gwangzeejay/NovaSight/output/diagrams/NovaSight_Studio_Preview.jpg

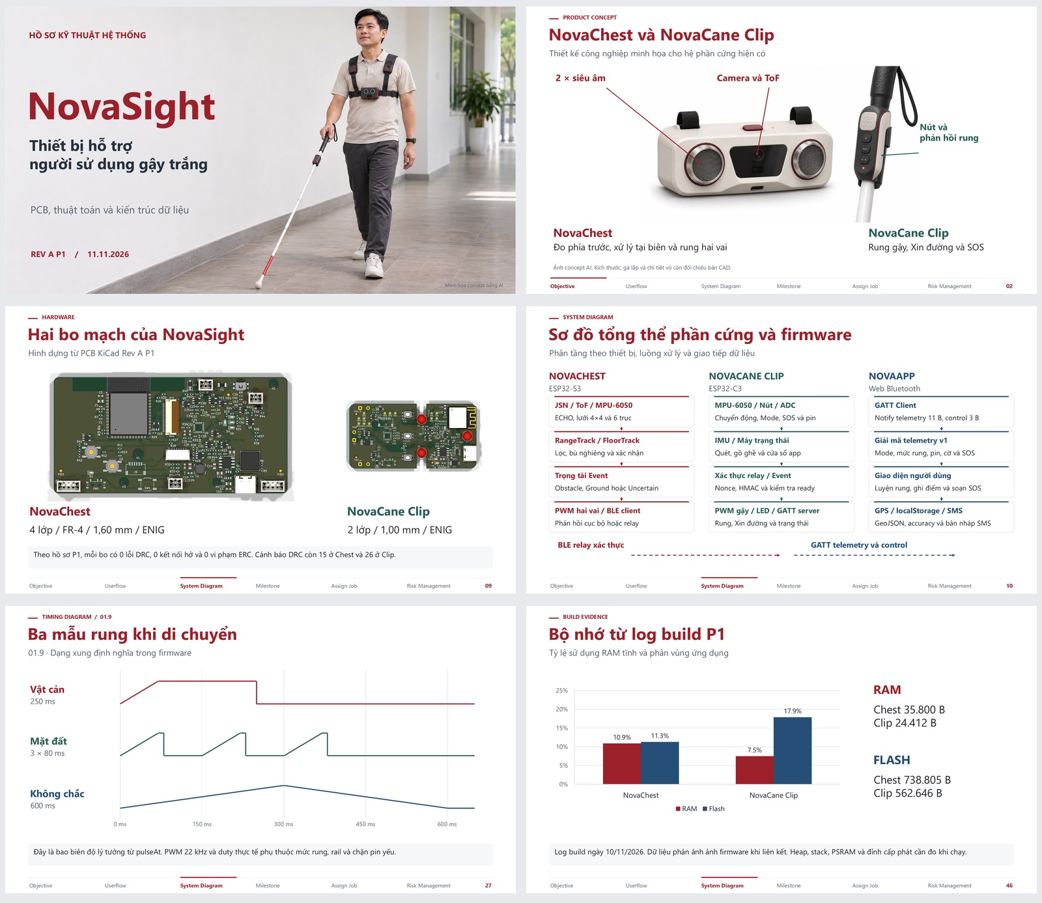
output/diagrams/NovaSight_Studio_Preview.jpg
