gwangzeejay/NovaSight/output/pdf/NovaSight_Technology_Engineering_RevA_P1_Studio.pdf

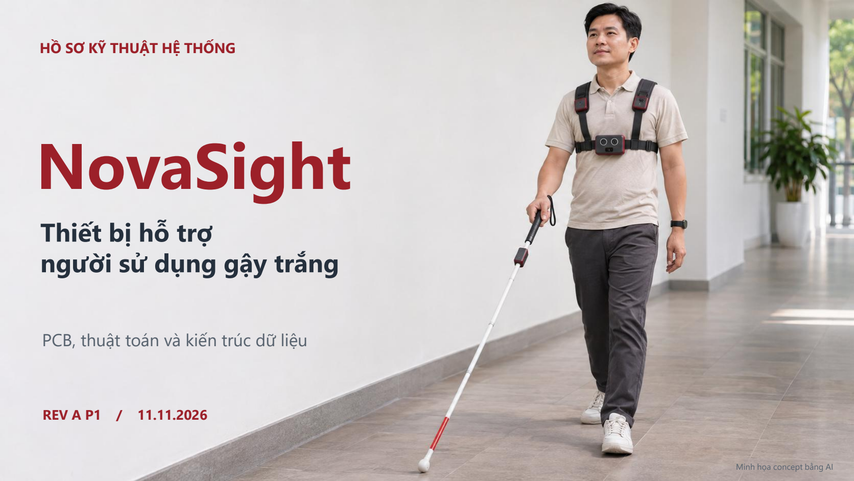
[picture p65: page 1]

HỒ SƠ KỸ THUẬT HỆ THỐNG

# NovaSight

# Thiết bị hỗ trợ

# người sử dụng gậy trắng

### PCB, thuật toán và kiến trúc dữ liệu

REV A P1 / 11.11.2026

Minh họa concept bằng AI

PRODUCT CONCEPT

# NovaChest và NovaCane Clip

Thiết kế công nghiệp minh họa cho hệ phần cứng hiện có

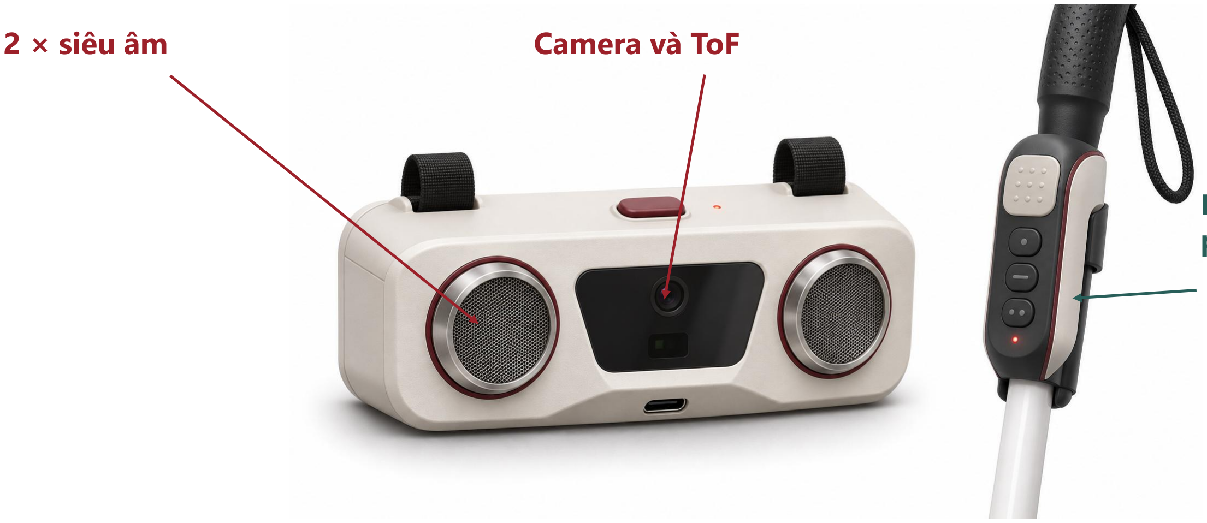
[picture p66: figure]
2 × siêu âm; Camera và ToF

Objective | Userflow | System Diagram | Milestone | Assign Job | Risk Management | 02

Nút và
phản hồi rung

## NovaChest

Đo phía trước, xử lý tại biên và rung hai vai

## NovaCane Clip

Rung gậy, Xin đường và SOS

Ảnh concept AI. Kích thước, gá lắp và chi tiết vỏ cần đối chiếu bản CAD.

DESIGN RATIONALE

# Nhu cầu và quyết định thiết kế

Dấu vết từ khảo sát người dùng đến yêu cầu kỹ thuật

Objective | Userflow | System Diagram | Milestone | Assign Job | Risk Management | 03
N1 | Vật cản ở ngực và đầu

### Hai kênh siêu âm trên Chest phân biệt

trái, phải và giữa.

## N4 Mặt đường khó dự đoán

ToF đa vùng so với nền đã hiệu chuẩn, kết hợp tư thế IMU.

N5 / N6 | Rung nhẹ và giữ tai rảnh
| Ba mức rung, khởi động mềm và phản hồi hai vai hoặc trên gậy.

## N13 / N14 Tiếp tục sử dụng gậy quen thuộc

### Clip gắn dưới tay cầm. NovaApp hỗ trợ

cấu hình và tiện ích.

P1 là nguyên mẫu kỹ thuật có giám sát. Hiệu năng phát hiện và trải nghiệm rung cần được đo với phần cứng thực.

TỔNG QUAN

# Objective

Nguyên mẫu hỗ trợ người sử dụng gậy trắng

Objective | Userflow | System Diagram | Milestone | Assign Job | Risk Management | 04

### 01 Nhận biết vật cản thân trên

NovaChest phát siêu âm hai hướng và chọn vật cản trái, phải hoặc giữa.

### 02 Nhận biết thay đổi mặt đất

ToF 4×4 và IMU giúp so độ cao so với nền đã hiệu chuẩn. Tín hiệu yếu có mẫu rung riêng.

### 03 Phản hồi qua hai thiết bị

Chest có rung vai. Clip nhận cảnh báo đã xác thực khi đang quét và đủ điều kiện.

### 04 Tiện ích NovaApp

Cấu hình, luyện rung, tiếp nhận SOS và lưu điểm gồ ghề khi người dùng thao tác.

P1 dùng cho nguyên mẫu kỹ thuật có giám sát. Mục tiêu độ trễ và khả năng phát hiện cần đo trên mẫu.

OBJECTIVE

# Phạm vi chức năng Rev A P1

Phân biệt đường chạy hiện hành và hạng mục kiểm chứng

Objective | Userflow | System Diagram | Milestone | Assign Job | Risk Management | 05
Khối | Đường xử lý có trong P1 | Điều kiện hoặc mốc còn mở
NovaChest | Siêu âm, ToF + IMU, trọng tài sự kiện, rung vai | ToF cần bật và hiệu chuẩn. Đo ngoài nắng, bỏ sót và báo nhầm.
NovaCane Clip | IMU, quét và gồ ghề, motor, đèn Xin đường, SOS | Xác nhận cường độ rung, rail tải và dùng nút khi đeo.
Liên kết Chest–Clip | BLE GATT và relay có nonce + HMAC | Cần cặp đã cấu hình. Đo mất kết nối và thời gian chờ ACK.
NovaApp | BLE, luyện rung, GPS theo yêu cầu, mở SMS và GeoJSON | Cần trình duyệt tương thích. Người dùng xác nhận gửi SMS.
OV5640 | Task chẩn đoán thu JPEG QVGA | Đo điện và xác minh FPC. Ghép ảnh vào thuật toán là hướng phát triển.

HÀNH TRÌNH SỬ DỤNG

# Userflow

Các thao tác chính khi chuẩn bị, di chuyển và cần hỗ trợ

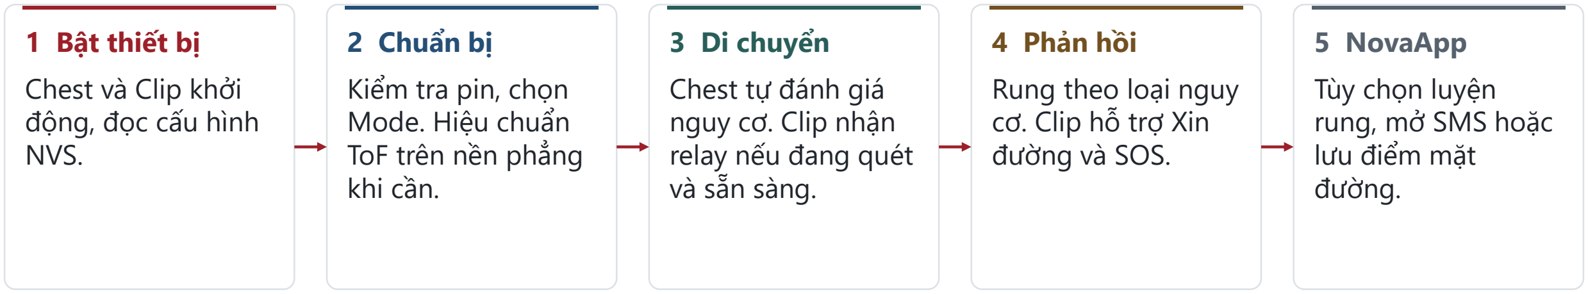
[picture p67: figure]
1 Bật thiết bị; Chest và Clip khởi động, đọc cấu hình NVS.; 2 Chuẩn bị; Kiểm tra pin, chọn Mode. Hiệu chuẩn ToF trên nền phẳng khi cần.; 3 Di chuyển; Chest tự đánh giá nguy cơ. Clip nhận relay nếu đang quét và sẵn sàng.; 4 Phản hồi; Rung theo loại nguy cơ. Clip hỗ trợ Xin đường và SOS.; 5 NovaApp; Tùy chọn luyện rung, mở SMS hoặc lưu điểm mặt đường.
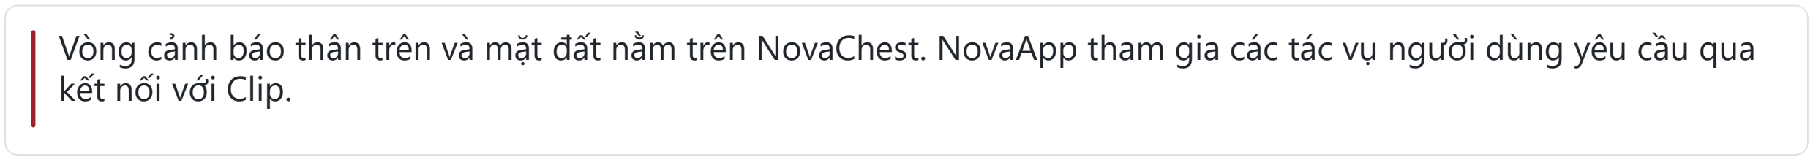
[picture p68: figure]
kết nối với Clip.

Objective | Userflow | System Diagram | Milestone | Assign Job | Risk Management | 06

Vòng cảnh báo thân trên và mặt đất nằm trên NovaChest. NovaApp tham gia các tác vụ người dùng yêu cầu qua

NOVASIGHT
01

# ARCHITECTURE

## System Diagram từ ngữ cảnh đến gói dữ liệu

NovaChest · NovaCane Clip · NovaApp

Objective | Userflow | System Diagram | Milestone | Assign Job | Risk Management | 07

SYSTEM DIAGRAM

# Thành phần hệ thống

Các thiết bị và giao diện trong phiên bản Rev A P1

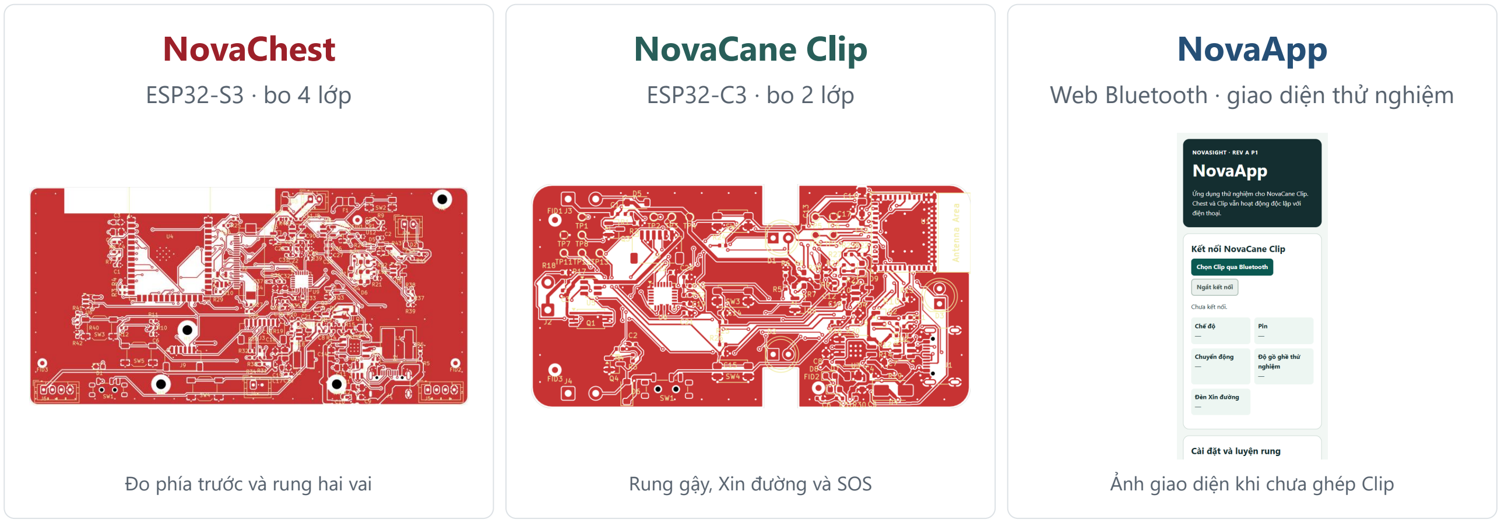
[picture p69: figure]
NovaChest; ESP32-S3 · bo 4 lớp; Đo phía trước và rung hai vai; NovaCane Clip; ESP32-C3 · bo 2 lớp; Rung gậy, Xin đường và SOS; NovaApp; Web Bluetooth · giao diện thử nghiệm; Ảnh giao diện khi chưa ghép Clip

Objective | Userflow | System Diagram | Milestone | Assign Job | Risk Management | 08

HARDWARE

# Hai bo mạch của NovaSight

Hình dựng từ PCB KiCad Rev A P1

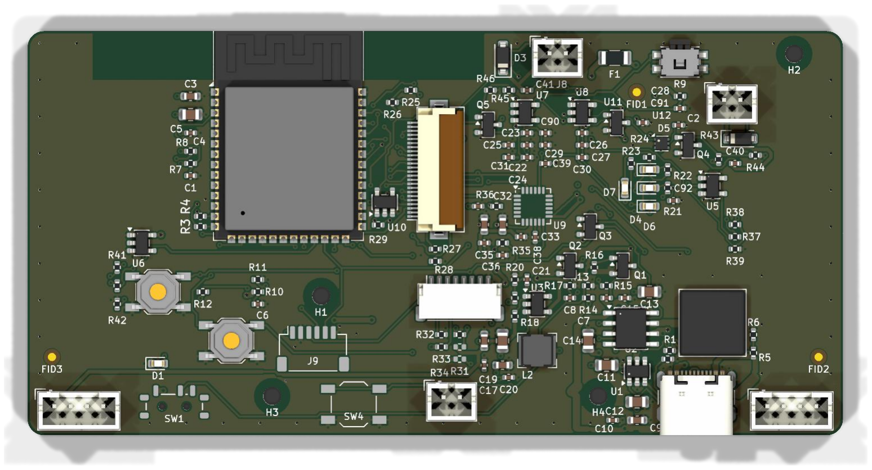
[picture p70: figure]
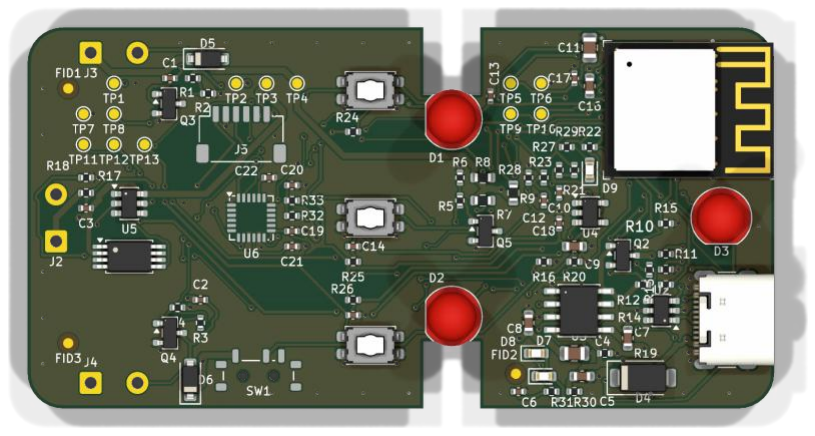
[picture p71: figure]

Objective | Userflow | System Diagram | Milestone | Assign Job | Risk Management | 09

## NovaChest

### 4 lớp / FR-4 / 1,60 mm / ENIG

## NovaCane Clip

### 2 lớp / 1,00 mm / ENIG

Theo hồ sơ P1, mỗi bo có 0 lỗi DRC, 0 kết nối hở và 0 vi phạm ERC. Cảnh báo DRC còn 15 ở Chest và 26 ở Clip.

# Sơ đồ tổng thể phần cứng và firmware

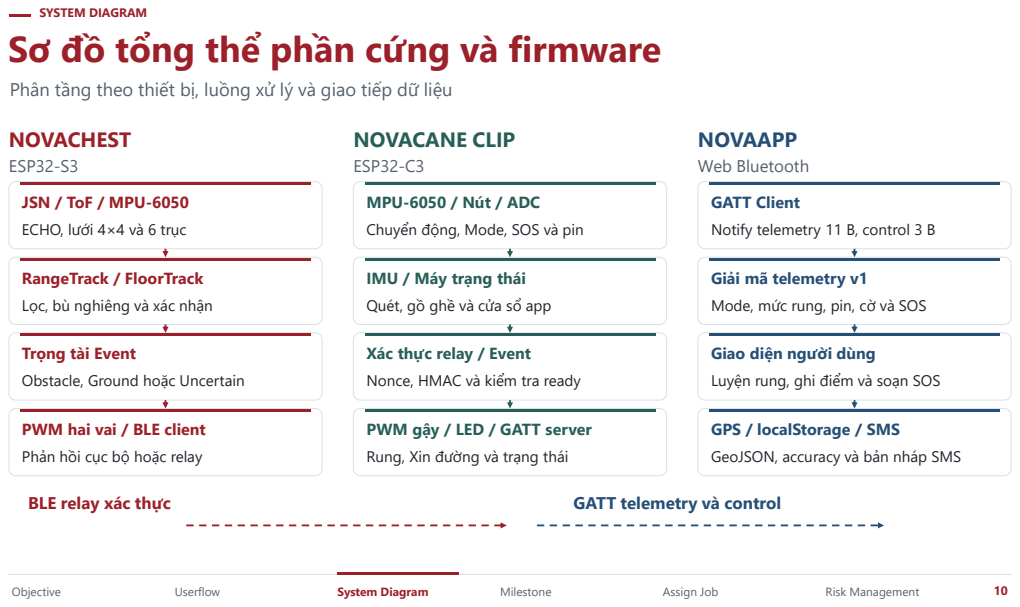
[picture p72: page 10]
SYSTEM DIAGRAM; Objective; Userflow; System Diagram; Milestone; Assign Job; Risk Management; NOVACHEST; ESP32-S3; NOVACANE CLIP; ESP32-C3; NOVAAPP; Web Bluetooth; GATT Client; BLE relay xác thực; GATT telemetry và control

Phân tầng theo thiết bị, luồng xử lý và giao tiếp dữ liệu

JSN / ToF / MPU-6050
ECHO, lưới 4×4 và 6 trục

MPU-6050 / Nút / ADC
Chuyển động, Mode, SOS và pin

Notify telemetry 11 B, control 3 B

RangeTrack / FloorTrack
Lọc, bù nghiêng và xác nhận

IMU / Máy trạng thái
Quét, gồ ghề và cửa sổ app

Giải mã telemetry v1

Mode, mức rung, pin, cờ và SOS

Trọng tài Event

Xác thực relay / Event
Nonce, HMAC và kiểm tra ready

Giao diện người dùng
Luyện rung, ghi điểm và soạn SOS

Obstacle, Ground hoặc Uncertain

PWM hai vai / BLE client
Phản hồi cục bộ hoặc relay

PWM gậy / LED / GATT server

GPS / localStorage / SMS
GeoJSON, accuracy và bản nháp SMS

Rung, Xin đường và trạng thái

POWER ARCHITECTURE

# Kiến trúc nguồn NovaChest

Đường công suất và tín hiệu điều khiển được phân biệt rõ

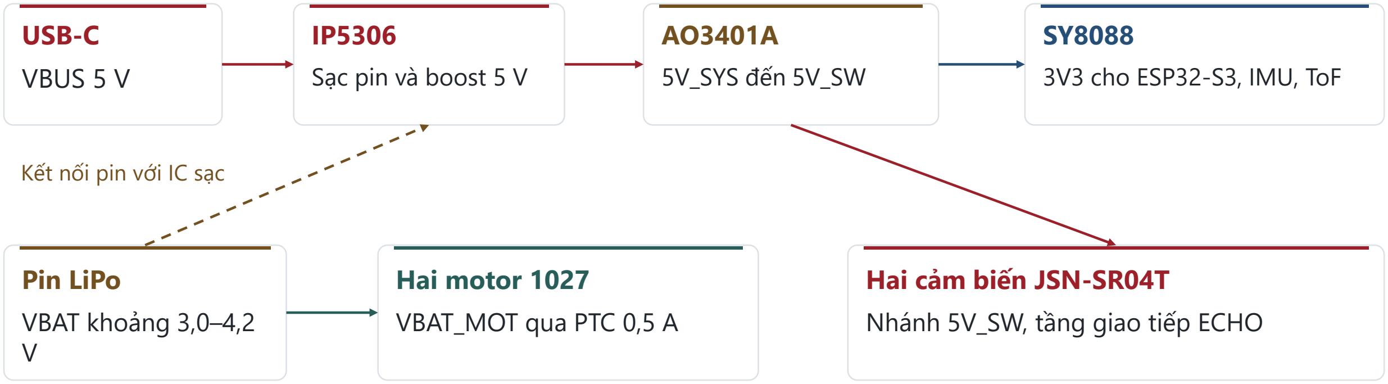
[picture p73: figure]
USB-C; VBUS 5 V; Sạc pin và boost 5 V; 5V_SYS đến 5V_SW; 3V3 cho ESP32-S3, IMU, ToF; Pin LiPo; VBAT khoảng 3,0–4,2 V; Hai motor 1027; VBAT_MOT qua PTC 0,5 A; Hai cảm biến JSN-SR04T; Nhánh 5V_SW, tầng giao tiếp ECHO; Kết nối pin với IC sạc

Objective | Userflow | System Diagram | Milestone | Assign Job | Risk Management | 11

Công tắc gạt điều khiển PWR_EN và KEY. Motor lấy nguồn từ VBAT. Đo rail, dòng đỉnh và nhiệt trước khi gắn đầy đủ tải.

POWER ARCHITECTURE

# Kiến trúc nguồn NovaCane Clip

Nạp qua USB, bảo vệ pin và chia tải VSYS

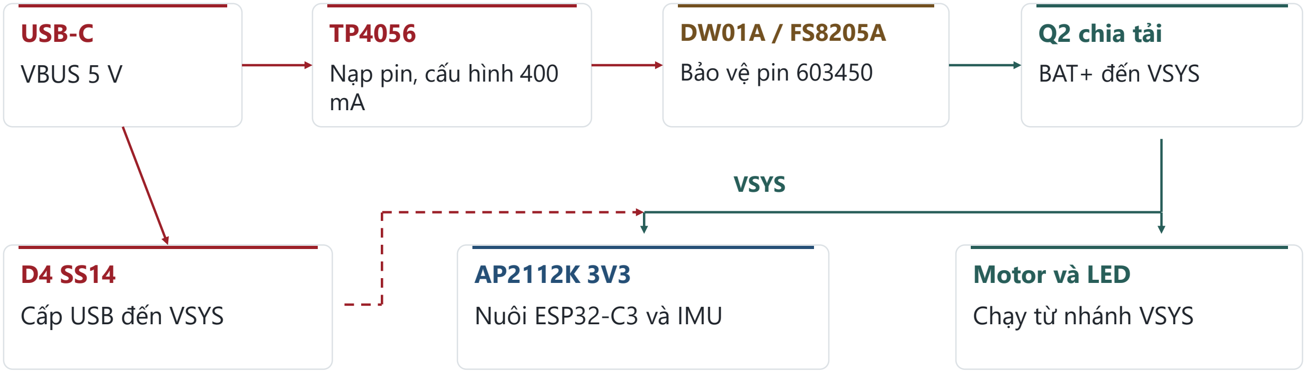
[picture p74: figure]
USB-C; VBUS 5 V; Nạp pin, cấu hình 400 mA; Bảo vệ pin 603450; Q2 chia tải; BAT+ đến VSYS; Cấp USB đến VSYS; Nuôi ESP32-C3 và IMU; Motor và LED; Chạy từ nhánh VSYS; VSYS

Objective | Userflow | System Diagram | Milestone | Assign Job | Risk Management | 12

SW1 điều khiển chân EN của LDO. Rung bị khóa dưới 3,50 V và mở lại từ 3,65 V theo ADC trong firmware.

SYSTEM DIAGRAM / L0

# System Diagram

L0 · Ngữ cảnh, tác nhân và ranh giới hệ thống

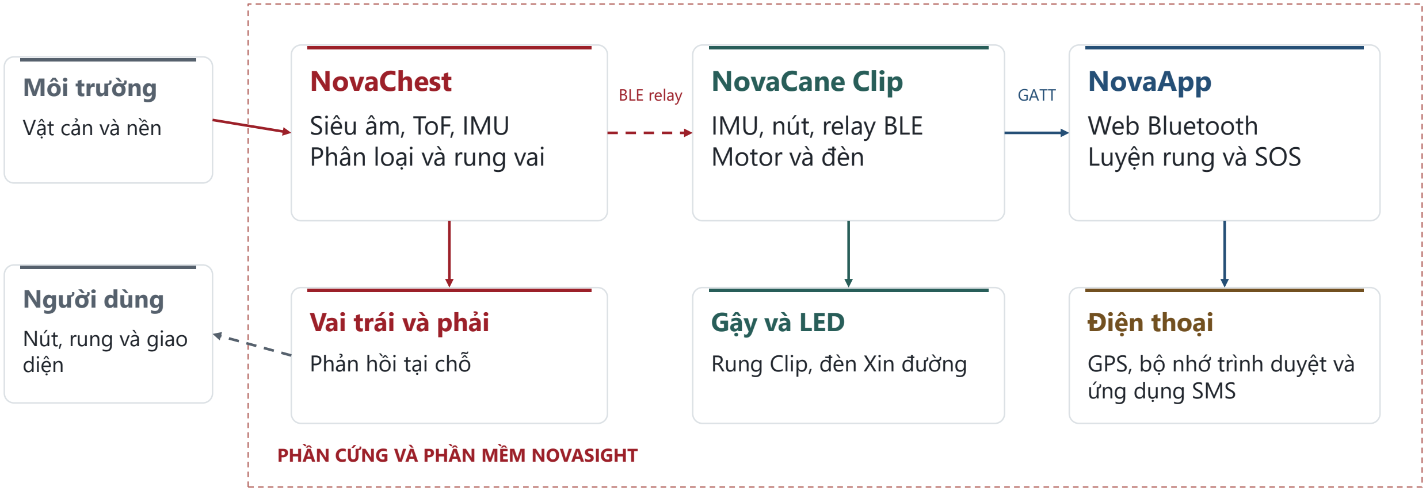
[picture p75: figure]
Môi trường; Vật cản và nền; Người dùng; Nút, rung và giao diện; NovaChest; Siêu âm, ToF, IMU Phân loại và rung vai; NovaCane Clip; IMU, nút, relay BLE Motor và đèn; NovaApp; Web Bluetooth Luyện rung và SOS; Điện thoại; GPS, bộ nhớ trình duyệt và ứng dụng SMS; Vai trái và phải; Phản hồi tại chỗ; Gậy và LED; Rung Clip, đèn Xin đường; BLE relay; GATT; PHẦN CỨNG VÀ PHẦN MỀM NOVASIGHT

Objective | Userflow | System Diagram | Milestone | Assign Job | Risk Management | 13

Đường an toàn tại chỗ chạy trên thiết bị. GPS, lưu điểm và soạn SMS là các tác vụ tùy chọn trên điện thoại.

SYSTEM DIAGRAM / L0–L4

# Phân cấp dữ liệu NovaSight

L0–L4 · Từ ngữ cảnh đến byte, đối tượng và nơi lưu

Objective | Userflow | System Diagram | Milestone | Assign Job | Risk Management | 14
L0 Ngữ cảnh | Môi trường, người sử dụng, Chest, Clip và điện thoại.
L1 Miền và giao tiếp | Cảm biến I²C, TRIG/ECHO, PWM, BLE GATT và API vị trí.
L2 Luồng xử lý | Thu nhận, lọc, trích đặc trưng, phân loại và phản hồi.
L3 Đối tượng dữ liệu | Motion, RangeSample, FloorFrame, FloorCalibration, Event và
Pulse.

L4 Tuần tự hóa và lưu Challenge 18 B, relay 16 B, ACK 12 B, telemetry 11 B, control 3 B và GeoJSON.

SYSTEM DIAGRAM / L1

# Phân vùng xử lý và nhịp dữ liệu

L1 · Các task và nhịp xử lý cấu hình trong P1

Objective | Userflow | System Diagram | Milestone | Assign Job | Risk Management | 15
Tác vụ | NovaChest ESP32-S3 | NovaCane Clip ESP32-C3 / NovaApp
Vòng chính | pollUltrasound, nhận FloorFrame, trọng tài và PWM. delay(2 ms). | Đọc nút, xử lý relay/control, PWM và cập nhật cờ. delay(2 ms).
Thu nhận | TRIG xen kẽ 50 ms. IMU theo lịch 10 ms. ToF 4×4 cấu hình 20 Hz. | IMU theo lịch 10 ms. ADC pin trên cả hai bo mỗi 250 ms.
Task nền | nova-sensors đẩy queue 1 phần tử. nova-camera và nova-link chạy riêng. | BLE server đẩy hàng đợi 1 Event và 3 AppCommand.
Ứng dụng | Chest không gửi ảnh hay lưới ToF sang NovaApp. | Telemetry notify mỗi 500 ms hoặc khi dirty. GPS theo yêu cầu.

Nhịp danh định từ code. Thời gian I/O, radio và lập lịch làm thay đổi nhịp đo thực tế.

TIMING DIAGRAM / L1–L2

# Dòng thời gian thu nhận và xác nhận

L1–L2 · Minh họa nhịp danh định trong cửa sổ 250 ms

Objective | Userflow | System Diagram | Milestone | Assign Job | Risk Management | 16
| 0 ms | 50 ms | 100 ms | 150 ms | 200 ms | 250 ms
TRIG trái | L | | L | | L
TRIG phải | | R | | R | | R
ToF 4×4 | F | F | F | F | F | F
Mẫu trái nhất quán | 1 | | 2 | | 3
Khung ToF nhất quán | 1 | 2 | 3

Điểm 3 đánh dấu đủ số mẫu/khung. IMU cập nhật theo lịch 10 ms và cung cấp Motion mới nhất cho khung ToF.

Mốc minh họa giả định các chuỗi bắt đầu cùng lúc. Độ trễ thực còn gồm thời điểm mục tiêu xuất hiện, ECHO, xử lý và đầu ra.

NOVASIGHT
02

# EDGE PROCESSING

## NovaChest nhận biết nguy cơ và điều khiển phản hồi

01 · Thu nhận / DSP / Quyết định / Rung

Objective | Userflow | System Diagram | Milestone | Assign Job | Risk Management | 17

SYSTEM DIAGRAM / 01

# System Diagram

01 · NovaChest và các nhánh xử lý tại biên

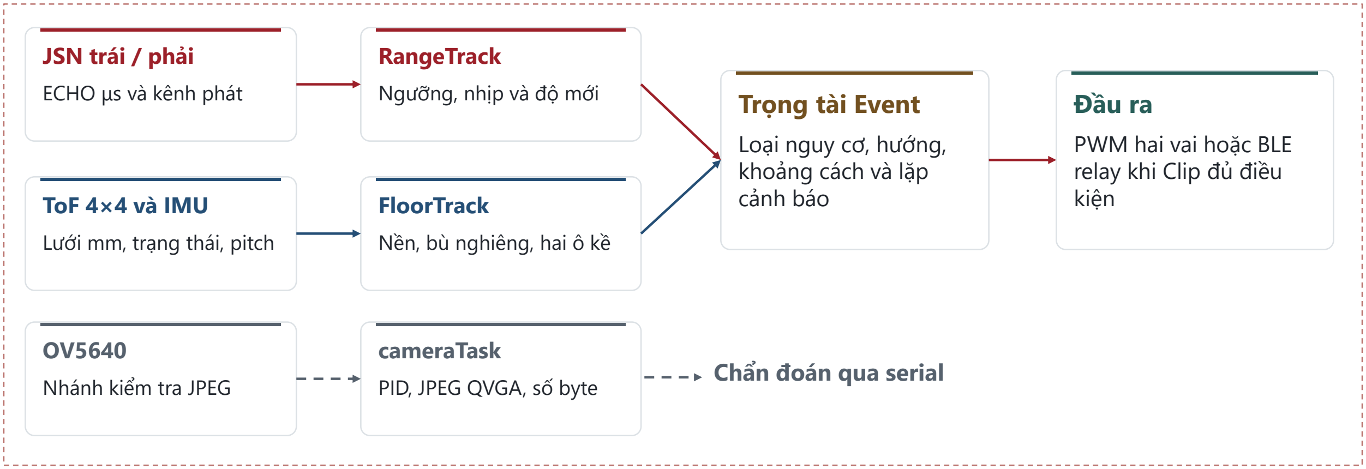
[picture p76: figure]
JSN trái / phải; ECHO μs và kênh phát; ToF 4×4 và IMU; Lưới mm, trạng thái, pitch; Nhánh kiểm tra JPEG; RangeTrack; Ngưỡng, nhịp và độ mới; FloorTrack; Nền, bù nghiêng, hai ô kề; cameraTask; PID, JPEG QVGA, số byte; Trọng tài Event; Loại nguy cơ, hướng, khoảng cách và lặp cảnh báo; Đầu ra; PWM hai vai hoặc BLE relay khi Clip đủ điều kiện; Chẩn đoán qua serial

Objective | Userflow | System Diagram | Milestone | Assign Job | Risk Management | 18

Camera đo tình trạng thu ảnh riêng. Đường cảnh báo dùng siêu âm, ToF và thông tin tư thế từ IMU.

ALGORITHM / 01.1

# Siêu âm và thuật toán vật cản

01.1 · Thu ECHO, kiểm tra nhất quán rồi phát hiện thân trên

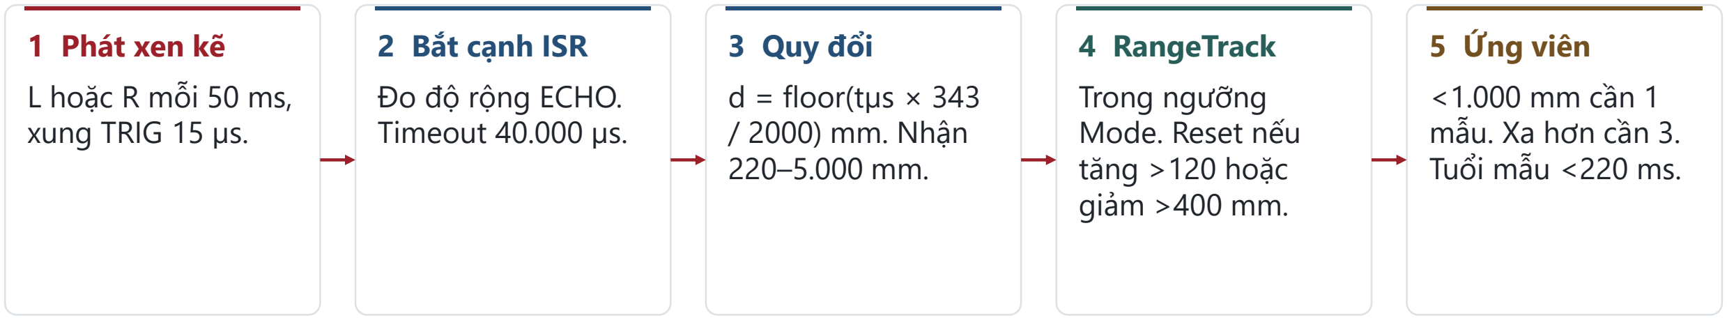
[picture p77: figure]
1 Phát xen kẽ; L hoặc R mỗi 50 ms, xung TRIG 15 µs.; 2 Bắt cạnh ISR; Đo độ rộng ECHO. Timeout 40.000 µs.; 3 Quy đổi; d = floor(tµs × 343 / 2000) mm. Nhận 220–5.000 mm.; 4 RangeTrack; Trong ngưỡng Mode. Reset nếu tăng >120 hoặc giảm >400 mm.; 5 Ứng viên; <1.000 mm cần 1 mẫu. Xa hơn cần 3. Tuổi mẫu <220 ms.
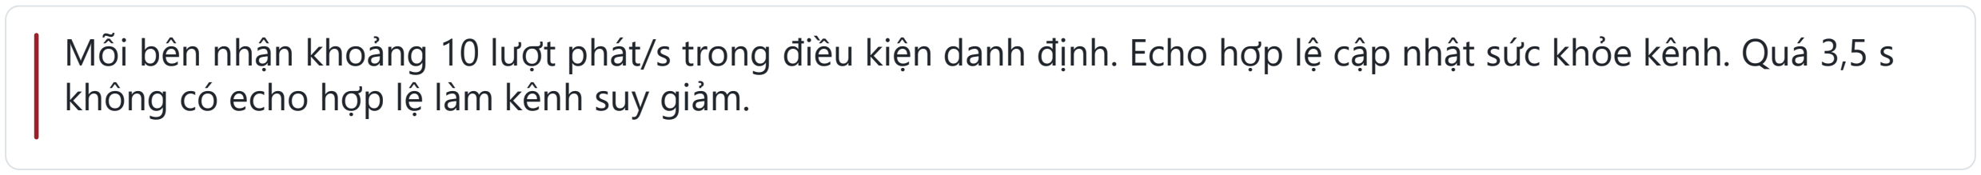
[picture p78: figure]
không có echo hợp lệ làm kênh suy giảm.

Objective | Userflow | System Diagram | Milestone | Assign Job | Risk Management | 19

Mỗi bên nhận khoảng 10 lượt phát/s trong điều kiện danh định. Echo hợp lệ cập nhật sức khỏe kênh. Quá 3,5 s

DSP / 01.2

# IMU và trích xuất đặc trưng

01.2 · Từ 14 byte MPU-6050 đến tư thế và vận tốc ước lượng

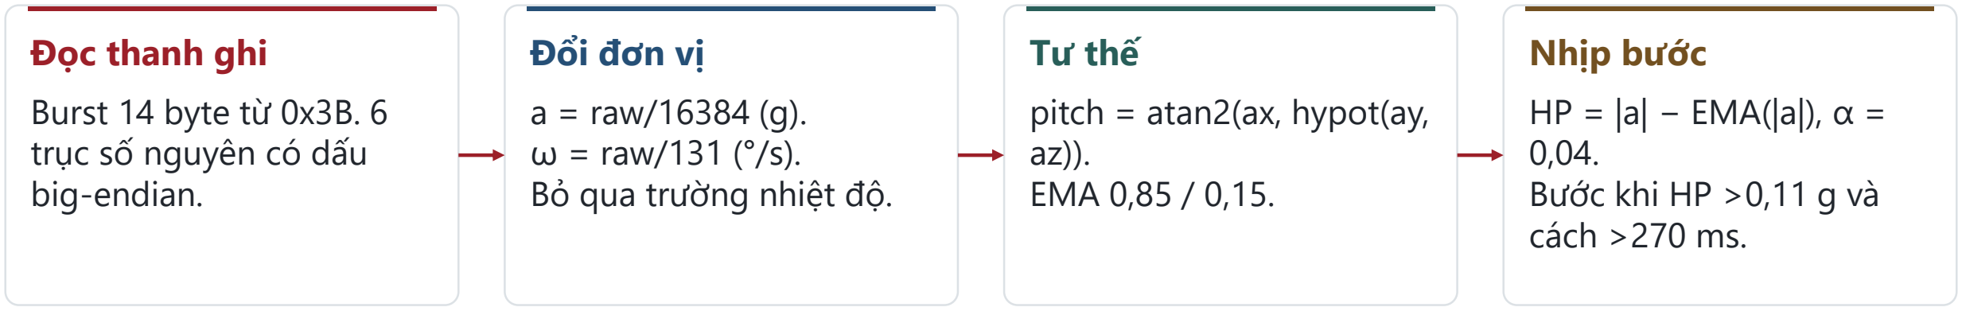
[picture p79: figure]
Đọc thanh ghi; Burst 14 byte từ 0x3B. 6 trục số nguyên có dấu big-endian.; Đổi đơn vị; a = raw/16384 (g). ω = raw/131 (°/s). Bỏ qua trường nhiệt độ.; Tư thế; pitch = atan2(ax, hypot(ay, az)). EMA 0,85 / 0,15.; Nhịp bước; HP = |a| − EMA(|a|), α = 0,04. Bước khi HP >0,11 g và cách >270 ms.

Objective | Userflow | System Diagram | Milestone | Assign Job | Risk Management | 20

Cổng tin cậy tư thế

0,78 < |a| < 1,22 g và |ω| < 140 °/s. Pitch chỉ cập nhật ở mẫu qua cổng.

Tốc độ dùng cho ngưỡng

Cadence EMA 0,7 / 0,3. v = min(2,2; 0,65 × cadence) m/s khi bước còn mới (<1,45 s).

Pitch lấy từ gia tốc trọng trường. Gyro giúp loại tư thế thiếu ổn định. Tốc độ là ước lượng từ nhịp bước.

DSP / 01.3

# ToF Input Processing

01.3 · Đồng bộ lưới độ sâu với tư thế mới nhất

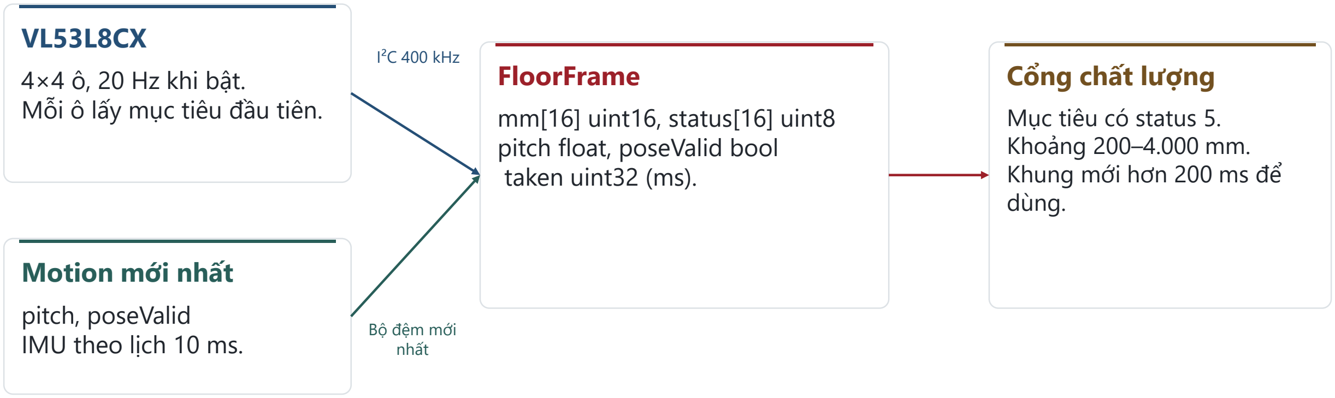
[picture p80: figure]
4×4 ô, 20 Hz khi bật. Mỗi ô lấy mục tiêu đầu tiên.; Motion mới nhất; pitch, poseValid IMU theo lịch 10 ms.; FloorFrame; mm[16] uint16, status[16] uint8 pitch float, poseValid bool taken uint32 (ms).; Cổng chất lượng; Mục tiêu có status 5. Khoảng 200–4.000 mm. Khung mới hơn 200 ms để dùng.; I²C 400 kHz; Bộ đệm mới nhất

Objective | Userflow | System Diagram | Milestone | Assign Job | Risk Management | 21

Nếu ô không có mục tiêu, status = 255. Mất khung ≥1 s thì task dừng ranging và thử lại theo chu kỳ 5 s.

ALGORITHM / 01.4

# Hiệu chuẩn nền phẳng

01.4 · Tạo nền theo từng ô ToF và lưu cấu hình có phiên bản

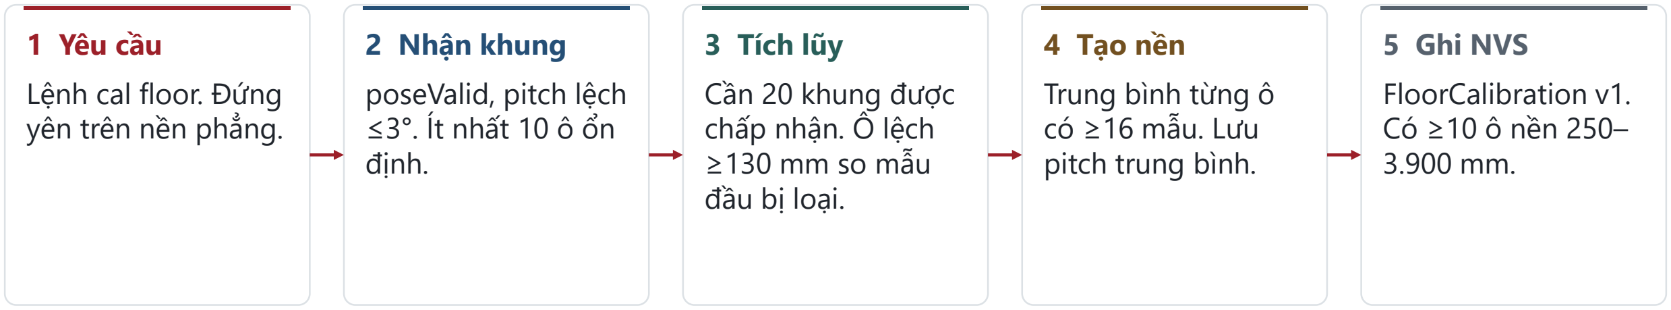
[picture p81: figure]
1 Yêu cầu; Lệnh cal floor. Đứng yên trên nền phẳng.; 2 Nhận khung; poseValid, pitch lệch ≤3°. Ít nhất 10 ô ổn định.; 3 Tích lũy; Cần 20 khung được chấp nhận. Ô lệch ≥130 mm so mẫu đầu bị loại.; 4 Tạo nền; Trung bình từng ô có ≥16 mẫu. Lưu pitch trung bình.; 5 Ghi NVS; FloorCalibration v1. Có ≥10 ô nền 250– 3.900 mm.
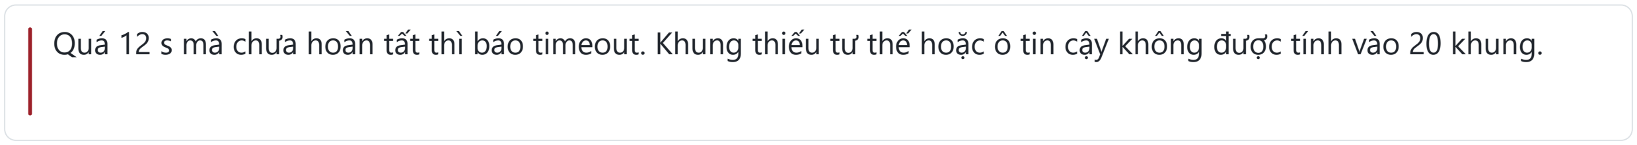
[picture p82: figure]

Objective | Userflow | System Diagram | Milestone | Assign Job | Risk Management | 22

Quá 12 s mà chưa hoàn tất thì báo timeout. Khung thiếu tư thế hoặc ô tin cậy không được tính vào 20 khung.

ALGORITHM / 01.5

# Bù nghiêng và độ lệch mặt đất

01.5 · Phép chiếu theo hàng ToF cho mỗi ô đã qua lọc

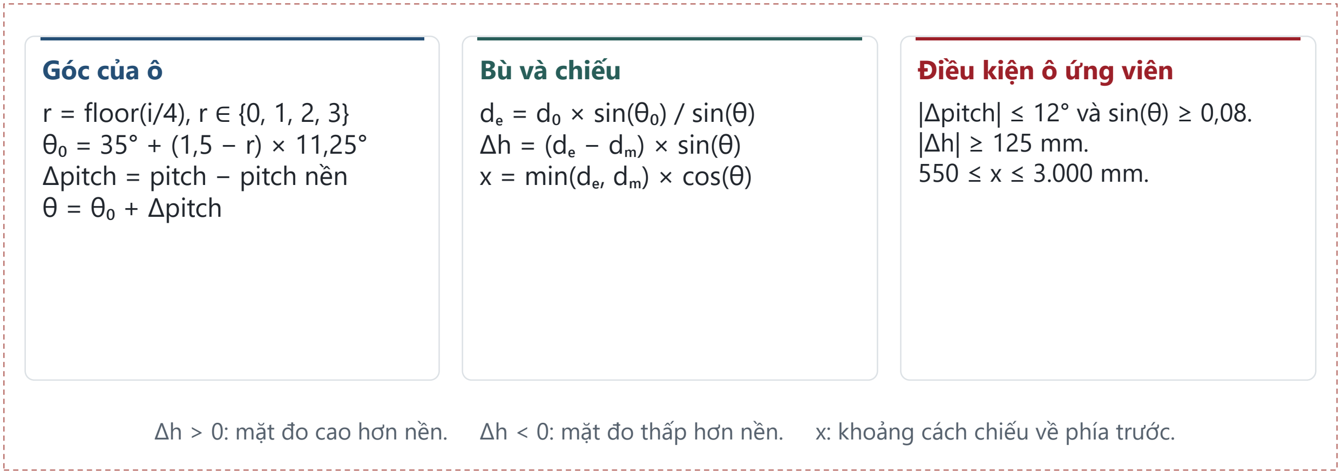
[picture p83: figure]
Góc của ô; r = floor(i/4), r ∈ {0, 1, 2, 3} θ₀ = 35° + (1,5 − r) × 11,25° Δpitch = pitch − pitch nền θ = θ₀ + Δpitch; Bù và chiếu; dₑ = d₀ × sin(θ₀) / sin(θ) Δh = (dₑ − dₘ) × sin(θ) x = min(dₑ, dₘ) × cos(θ); Điều kiện ô ứng viên; |Δpitch| ≤ 12° và sin(θ) ≥ 0,08. |Δh| ≥ 125 mm. 550 ≤ x ≤ 3.000 mm.

Objective | Userflow | System Diagram | Milestone | Assign Job | Risk Management | 23
Δh > 0: mặt đo cao hơn nền. | Δh < 0: mặt đo thấp hơn nền. | x: khoảng cách chiếu về phía trước.

Khi hụt, dùng min(dₑ, dₘ) để ước lượng vị trí mép nền thay vì chọn điểm phản xạ sâu.

ALGORITHM / 01.6

# Lưới ToF và cửa sổ xác nhận

01.6 · Kiểm tra liền kề theo không gian và nhất quán theo thời gian

Objective | Userflow | System Diagram | Milestone | Assign Job | Risk Management | 24
Hàng | 0 | 1 | 2 | 3
0 | · | + | + | ·
1 | · | · | · | ·
2 | · | · | · | −
3 | ? | · | · | ·

Ví dụ minh họa nhãn ô, không phải lưới đo thực tế.

Không gian

Chấp nhận cặp ngang hoặc dọc cùng dấu. Chọn ứng viên gần nhất. Cần ≥6 ô khỏe.

Thời gian

Đếm 3 khung nhất quán. Reset nếu mất >200 ms, đổi dấu, xa thêm >150 mm hoặc gần thêm >450 mm.

Kết quả

reliable biểu thị đủ ô khỏe. hazardMm chỉ khác 0 khi qua cửa sổ xác nhận.

Cặp + ở hàng 0 qua kiểm tra liền kề. Ô − đơn lẻ ở hàng 2 chưa đủ điều kiện ứng viên.

ALGORITHM / 01.7

# Trọng tài nguy cơ và chế độ

01.7 · Từ hai RangeTrack và FloorResult đến một Event

Objective | Userflow | System Diagram | Milestone | Assign Job | Risk Management | 25
Chế độ | Vật cản thân trên | Mặt đất và phản hồi
Đi bộ | Ngưỡng = clamp(1.200v + 300; 1.500; 2.500) mm. Hướng giữa khi hai bên lệch ≤500 mm. | Xét mặt đất khi khung còn mới và đủ tin cậy. Rung theo mức cài.
Đông người | Chỉ ứng viên giữa trong 1.200 mm. Khoảng lặp 1.200 ms. | Bỏ qua kênh mặt đất trong mode này.
Trong nhà | Giới hạn siêu âm 1.000 mm. | Mặt đất chỉ đến 1.000 mm. Mức rung 1 và tạm dừng camera.

Nếu có cả hai ứng viên, ưu tiên mặt đất khi d_mặt đất + 200 mm < d_thân trên. Các trường hợp còn lại chọn thân trên.

ALGORITHM / 01.8

# Trạng thái suy giảm và không chắc

01.8 · Hành vi khi tín hiệu không đủ để kết luận

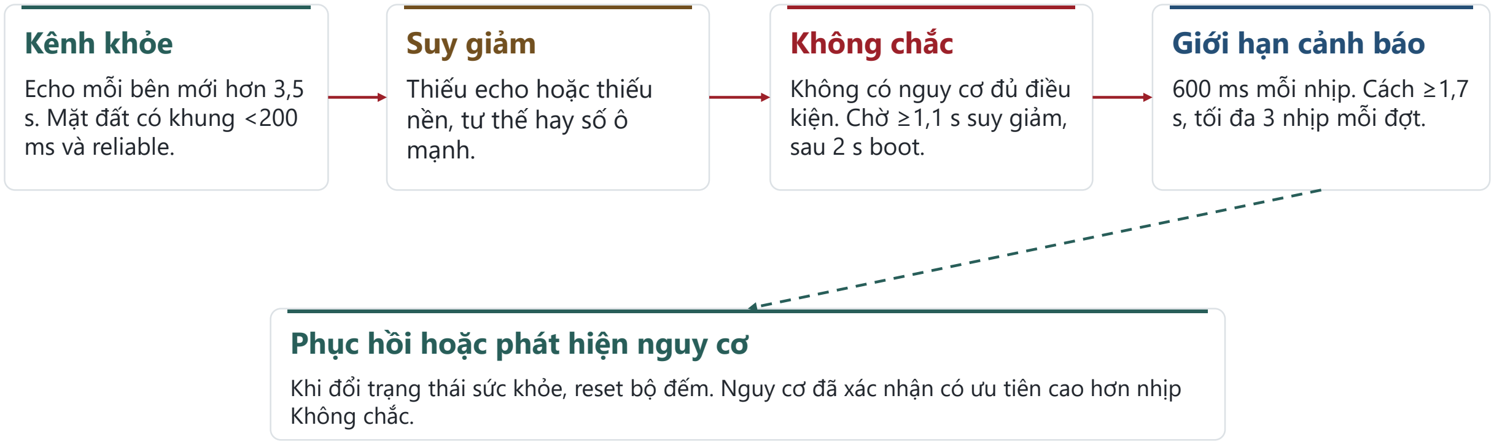
[picture p84: figure]
Kênh khỏe; Echo mỗi bên mới hơn 3,5 s. Mặt đất có khung <200 ms và reliable.; Suy giảm; Thiếu echo hoặc thiếu nền, tư thế hay số ô mạnh.; Không chắc; Không có nguy cơ đủ điều kiện. Chờ ≥1,1 s suy giảm, sau 2 s boot.; Giới hạn cảnh báo; 600 ms mỗi nhịp. Cách ≥1,7 s, tối đa 3 nhịp mỗi đợt.; Phục hồi hoặc phát hiện nguy cơ; Không chắc.

Objective | Userflow | System Diagram | Milestone | Assign Job | Risk Management | 26

Khi đổi trạng thái sức khỏe, reset bộ đếm. Nguy cơ đã xác nhận có ưu tiên cao hơn nhịp

Không có echo kéo dài có thể là vùng trống hoặc lỗi/che đầu dò. P1 chọn báo trạng thái suy giảm.

TIMING DIAGRAM / 01.9

# Ba mẫu rung khi di chuyển

01.9 · Dạng xung định nghĩa trong firmware

Objective | Userflow | System Diagram | Milestone | Assign Job | Risk Management | 27
0 ms | 150 ms | 300 ms | 450 ms | 600 ms

### Vật cản

250 ms

### Mặt đất

3 × 80 ms

### Không chắc

600 ms

Đây là bao biên độ lý tưởng từ pulseAt. PWM 22 kHz và duty thực tế phụ thuộc mức rung, rail và chặn pin yếu.

ALGORITHM / 01.10

# Quản lý pin và duty motor

01.10 · Chặn tải theo điện áp và mức rung của người dùng

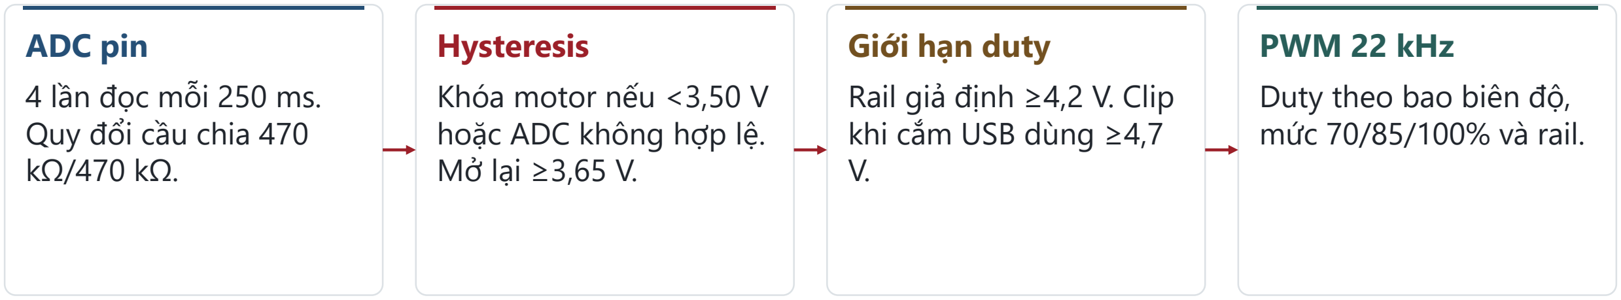
[picture p85: figure]
ADC pin; 4 lần đọc mỗi 250 ms. Quy đổi cầu chia 470 kΩ/470 kΩ.; Hysteresis; Khóa motor nếu <3,50 V hoặc ADC không hợp lệ. Mở lại ≥3,65 V.; Giới hạn duty; Rail giả định ≥4,2 V. Clip khi cắm USB dùng ≥4,7 V.; PWM 22 kHz; Duty theo bao biên độ, mức 70/85/100% và rail.
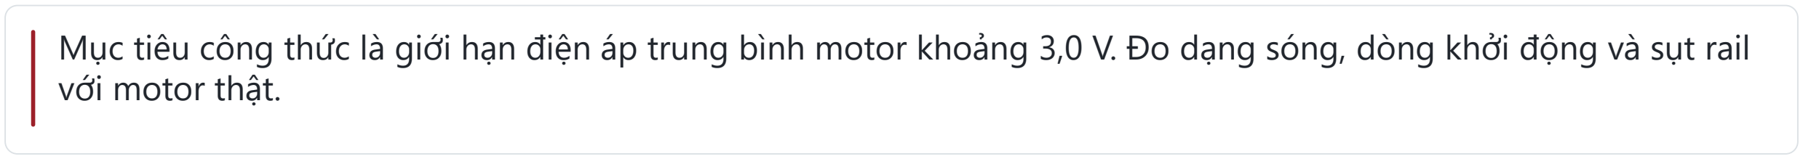
[picture p86: figure]
với motor thật.

Objective | Userflow | System Diagram | Milestone | Assign Job | Risk Management | 28

Mục tiêu công thức là giới hạn điện áp trung bình motor khoảng 3,0 V. Đo dạng sóng, dòng khởi động và sụt rail

SYSTEM DIAGRAM / 01.11

# OV5640 và luồng chẩn đoán

01.11 · Kiểm tra camera tại thiết bị bằng dữ liệu JPEG

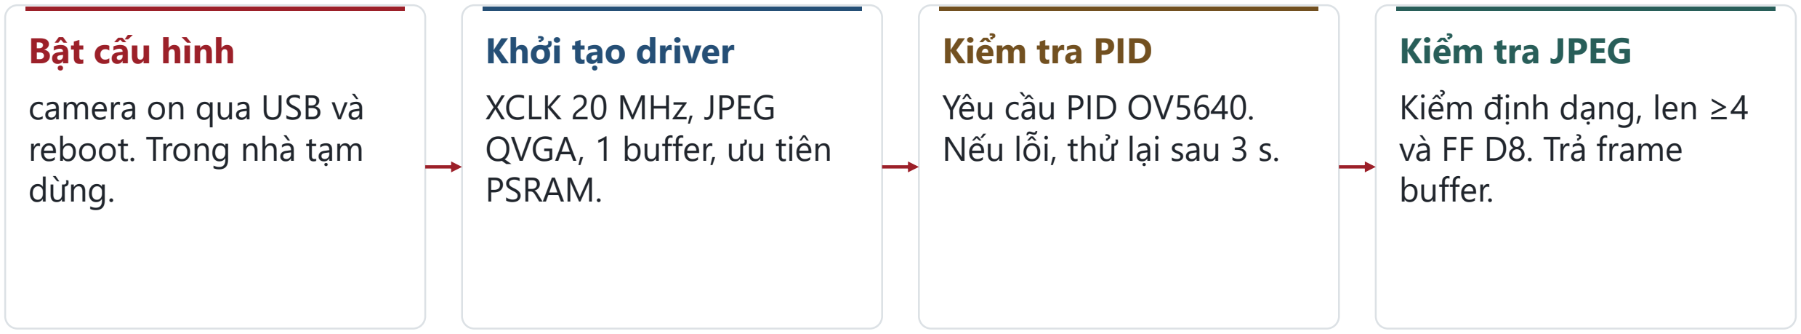
[picture p87: figure]
Bật cấu hình; camera on qua USB và reboot. Trong nhà tạm dừng.; Khởi tạo driver; XCLK 20 MHz, JPEG QVGA, 1 buffer, ưu tiên PSRAM.; Kiểm tra PID; Yêu cầu PID OV5640. Nếu lỗi, thử lại sau 3 s.; Kiểm tra JPEG; Kiểm định dạng, len ≥4 và FF D8. Trả frame buffer.
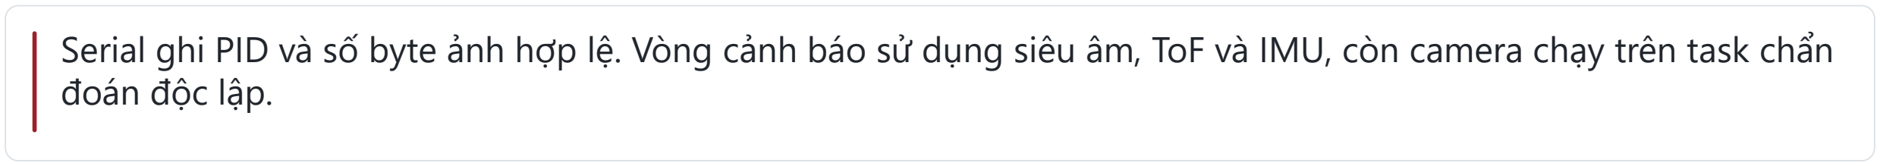
[picture p88: figure]
đoán độc lập.

Objective | Userflow | System Diagram | Milestone | Assign Job | Risk Management | 29

Serial ghi PID và số byte ảnh hợp lệ. Vòng cảnh báo sử dụng siêu âm, ToF và IMU, còn camera chạy trên task chẩn

SYSTEM DIAGRAM / 02

# System Diagram

02 · NovaCane Clip và các đường vào ra

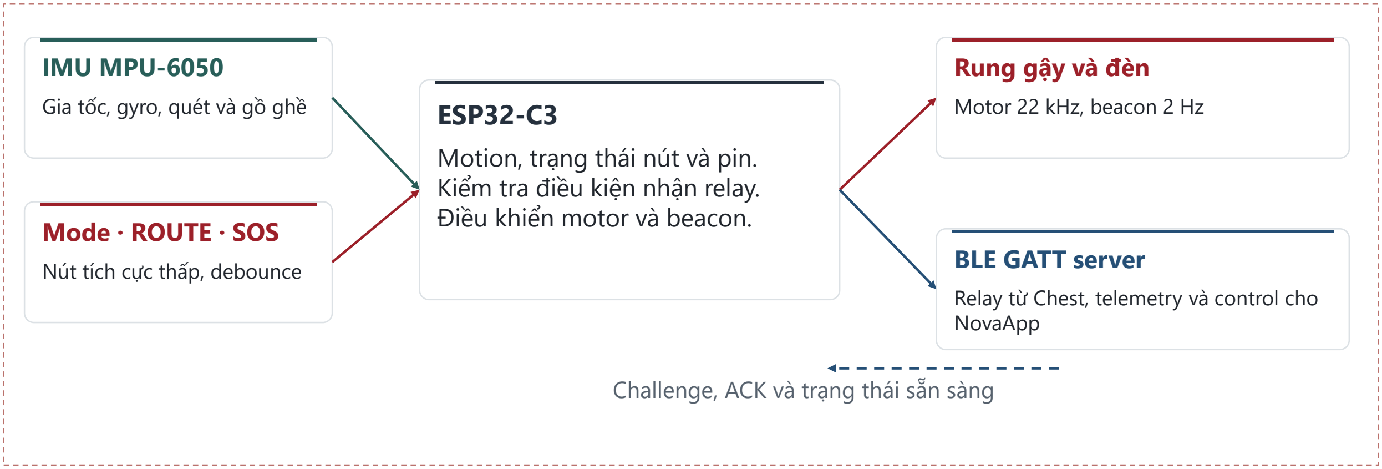
[picture p89: figure]
IMU MPU-6050; Gia tốc, gyro, quét và gồ ghề; Mode · ROUTE · SOS; Nút tích cực thấp, debounce; ESP32-C3; Motion, trạng thái nút và pin. Kiểm tra điều kiện nhận relay. Điều khiển motor và beacon.; Rung gậy và đèn; Motor 22 kHz, beacon 2 Hz; BLE GATT server; NovaApp; Challenge, ACK và trạng thái sẵn sàng

Objective | Userflow | System Diagram | Milestone | Assign Job | Risk Management | 30

Relay từ Chest, telemetry và control cho

Clip chỉ nhận cảnh báo relay khi đang quét, pin đủ và motor rảnh hoặc đang chạy mẫu có thể thay thế.

ALGORITHM / 02.1

# NovaCane Clip và các máy trạng thái

02.1 · Xử lý nút, beacon và yêu cầu hỗ trợ

Objective | Userflow | System Diagram | Milestone | Assign Job | Risk Management | 31
Đầu vào | Kích hoạt | Trạng thái hoặc đầu ra
Mode ngắn | Nhả sau debounce 30 ms | Đi bộ → Đông người → Trong nhà. Lưu NVS, xác nhận 1–3 xung.
Mode giữ | Giữ 3 s | Mở điều khiển NovaApp 60 s. Xác nhận hai xung nếu motor cho phép.
Xin đường | Nhả ROUTE để bật/tắt | Đèn 2 Hz, duty 50%. Tự tắt sau 60 s hoặc pin yếu.
SOS | Giữ 3 s | Tạo sosId 32 bit khác 0, giữ 120 s. Nếu chưa có điện thoại, phát NoLink.
App control | 3 B đúng phiên bản, quyền còn hạn | Đặt mức 1–3, hoặc thử mẫu khi Clip đứng yên.

DSP / 02.2

# Phát hiện quét và chỉ số gồ ghề

02.2 · Nhánh xử lý IMU riêng trên Clip

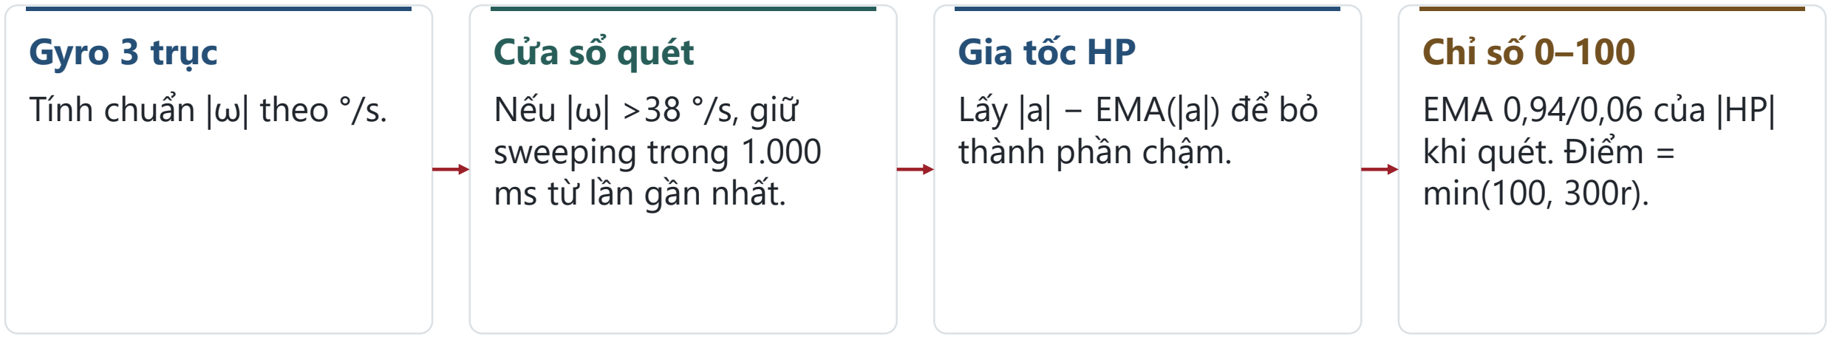
[picture p90: figure]
Gyro 3 trục; Tính chuẩn |ω| theo °/s.; Cửa sổ quét; Nếu |ω| >38 °/s, giữ sweeping trong 1.000 ms từ lần gần nhất.; Gia tốc HP; Lấy |a| − EMA(|a|) để bỏ thành phần chậm.; Chỉ số 0–100; EMA 0,94/0,06 của |HP| khi quét. Điểm = min(100, 300r).
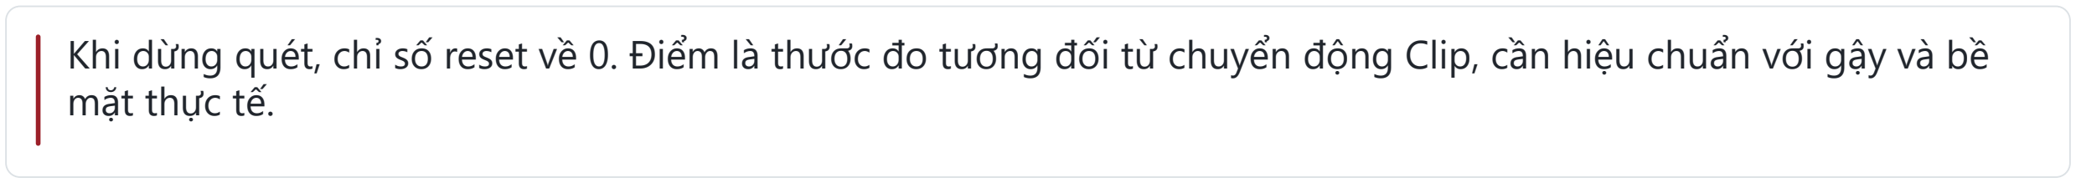
[picture p91: figure]
mặt thực tế.

Objective | Userflow | System Diagram | Milestone | Assign Job | Risk Management | 32

Khi dừng quét, chỉ số reset về 0. Điểm là thước đo tương đối từ chuyển động Clip, cần hiệu chuẩn với gậy và bề

SYSTEM DIAGRAM / 03

# System Diagram

03 · BLE GATT và vai trò Client / Server

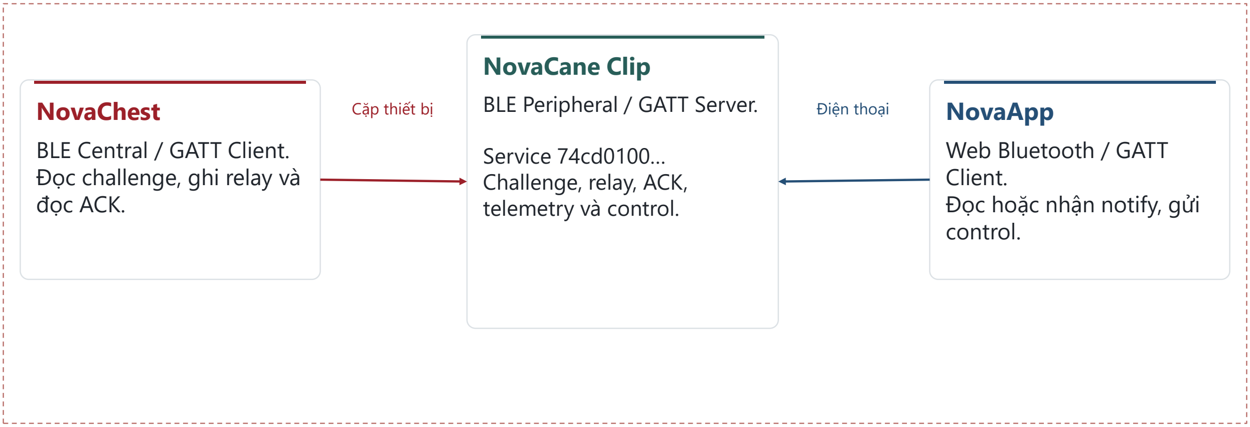
[picture p92: figure]
NovaChest; BLE Central / GATT Client. Đọc challenge, ghi relay và đọc ACK.; NovaCane Clip; BLE Peripheral / GATT Server.; Service 74cd0100… Challenge, relay, ACK, telemetry và control.; NovaApp; Web Bluetooth / GATT Client. Đọc hoặc nhận notify, gửi control.; Cặp thiết bị; Điện thoại

Objective | Userflow | System Diagram | Milestone | Assign Job | Risk Management | 33

Relay xác thực bằng khóa chung 128 bit. Control của app dùng cửa sổ mở bằng nút Mode trên Clip.

SEQUENCE DIAGRAM / 03.1

# Trình tự xác thực relay BLE

03.1 · Challenge, sự kiện và phản hồi trên cùng kết nối

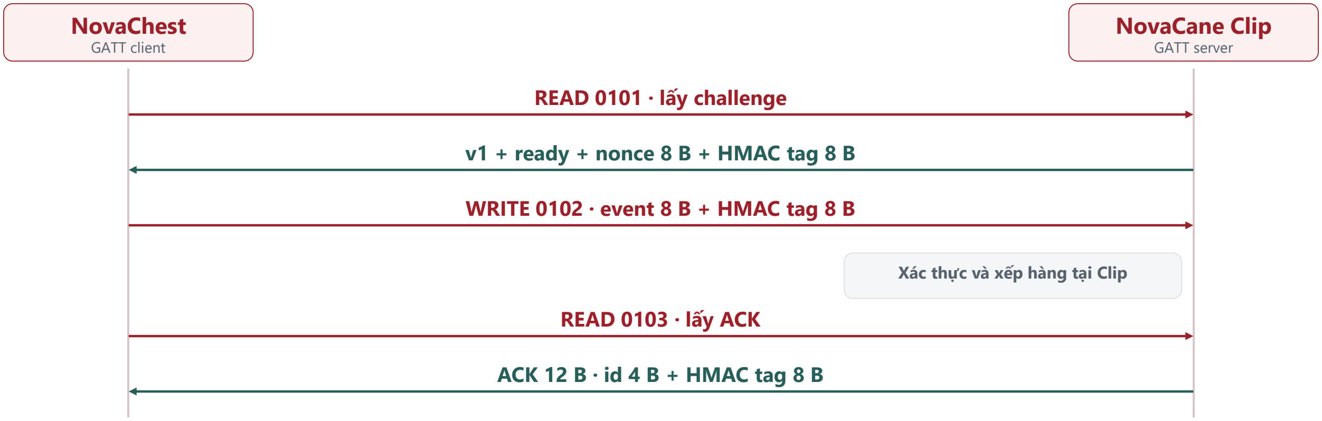
[picture p93: figure]
NovaChest; GATT client; NovaCane Clip; GATT server; READ 0101 · lấy challenge; v1 + ready + nonce 8 B + HMAC tag 8 B; WRITE 0102 · event 8 B + HMAC tag 8 B; Xác thực và xếp hàng tại Clip; READ 0103 · lấy ACK; ACK 12 B · id 4 B + HMAC tag 8 B

Objective | Userflow | System Diagram | Milestone | Assign Job | Risk Management | 34

Nonce thuộc kết nối, dùng một lần và hết hạn 120 ms. Tag là 8 byte đầu của HMAC-SHA256.

STATE DIAGRAM / 03.2

# Khi relay không hoàn tất

03.2 · Cửa sổ gửi và phương án rung cục bộ

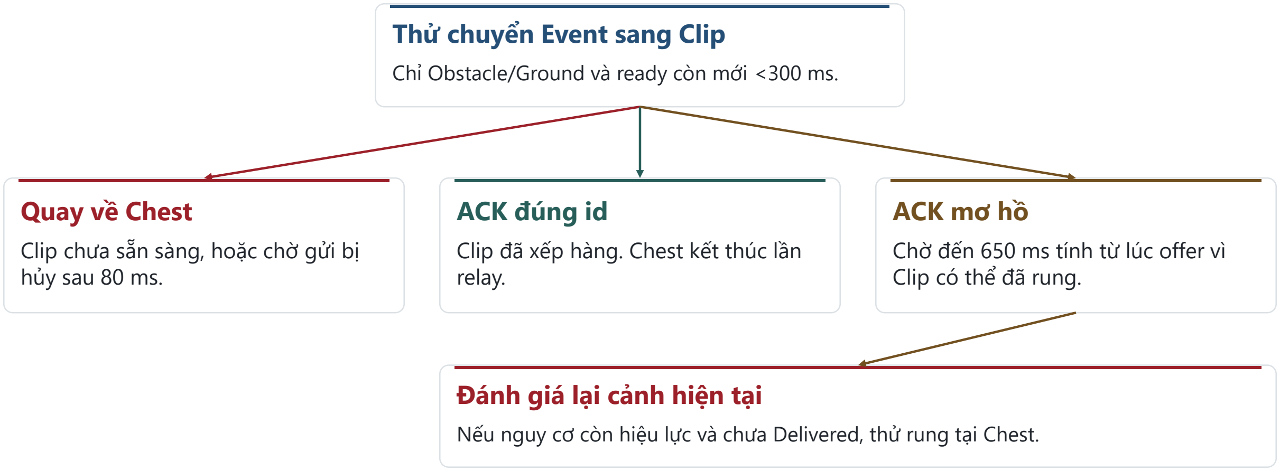
[picture p94: figure]
Thử chuyển Event sang Clip; Quay về Chest; Clip chưa sẵn sàng, hoặc chờ gửi bị hủy sau 80 ms.; ACK đúng id; Clip đã xếp hàng. Chest kết thúc lần relay.; ACK mơ hồ; Chờ đến 650 ms tính từ lúc offer vì Clip có thể đã rung.; Đánh giá lại cảnh hiện tại

Objective | Userflow | System Diagram | Milestone | Assign Job | Risk Management | 35

Chỉ Obstacle/Ground và ready còn mới <300 ms.

Nếu nguy cơ còn hiệu lực và chưa Delivered, thử rung tại Chest.

Mốc 650 ms là nhánh dự phòng. Khi đo độ trễ cần báo riêng nhánh ổn định và nhánh mất ACK.

DATA FORMAT / 03.3

# Bản đồ dữ liệu giao thức BLE

03.3 · Định dạng trên đường truyền, little-endian cho số nhiều byte

Objective | Userflow | System Diagram | Milestone | Assign Job | Risk Management | 36
Characteristic | Quyền và cỡ | Thứ tự byte
0101 Challenge | READ · 18 B | [0] v1 [1] ready [2–9] nonce [10–17] tag
0102 Relay | WRITE · 16 B | [0] kind [1] side [2–3] d_mm [4–7] id [8–15] tag
0103 ACK | READ · 12 B | [0–3] id nhận vào queue [4–11] tag
0104 Telemetry | READ/NOTIFY · 11 B | [0] v1 [1] flags [2] mode [3] level [4–5] pin_mV [6] roughness [7–10] sosId
0105 Control | WRITE · 3 B | [0] v1 [1] op [2] value. Op 1 đặt mức, op 2 phát mẫu.

# Telemetry theo tầng dữ liệu

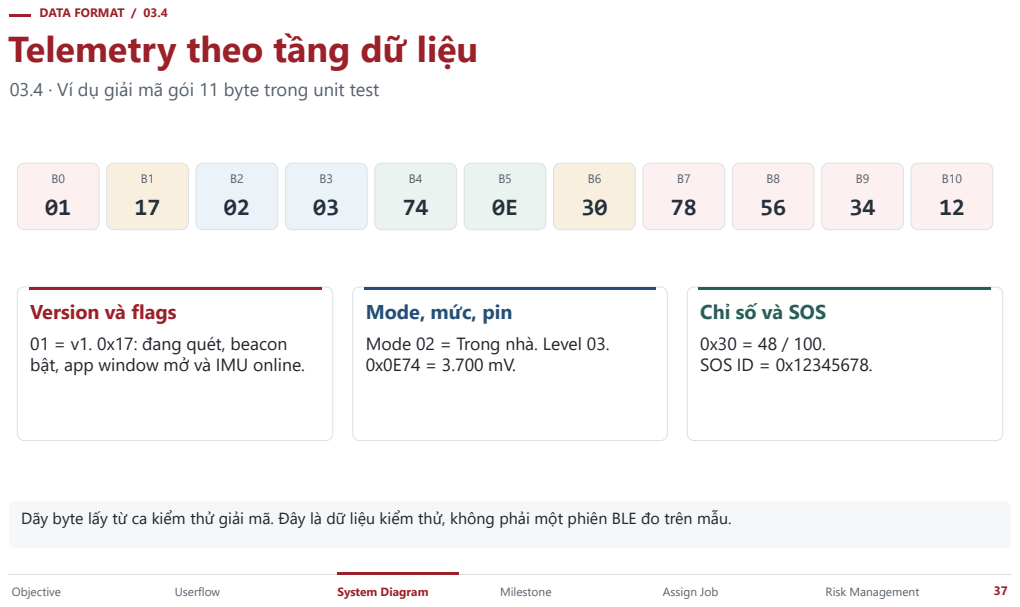
[picture p95: page 37]
DATA FORMAT / 03.4; Objective; Userflow; System Diagram; Milestone; Assign Job; Risk Management; 0x30 = 48 / 100. SOS ID = 0x12345678.

03.4 · Ví dụ giải mã gói 11 byte trong unit test

Version và flags

Mode, mức, pin

Chỉ số và SOS

01 = v1. 0x17: đang quét, beacon
bật, app window mở và IMU online.

Mode 02 = Trong nhà. Level 03.

Dãy byte lấy từ ca kiểm thử giải mã. Đây là dữ liệu kiểm thử, không phải một phiên BLE đo trên mẫu.

SYSTEM DIAGRAM / 04

# System Diagram

04 · NovaApp, lưu cục bộ và API điện thoại

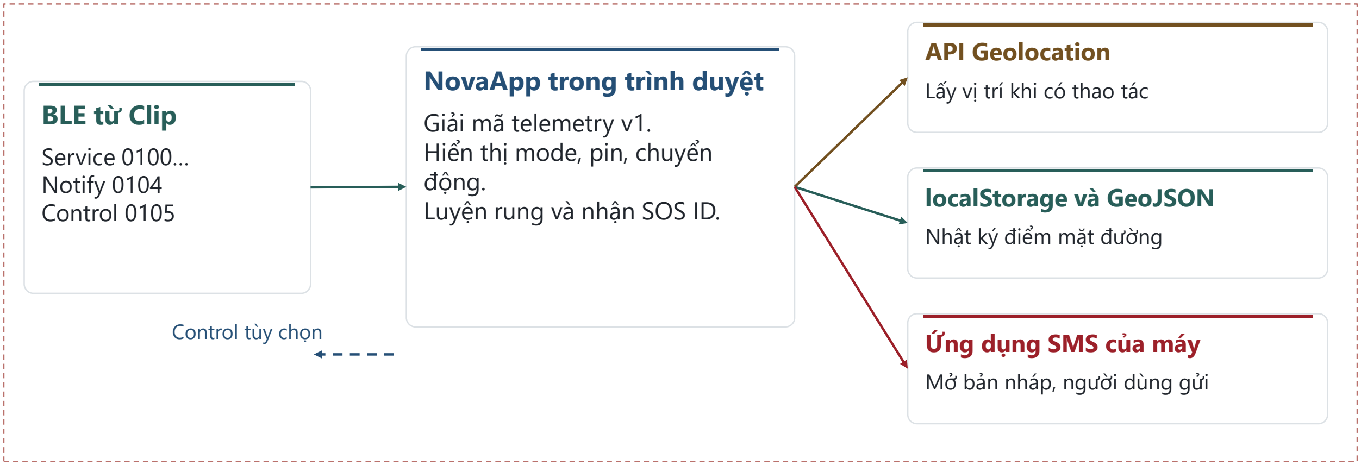
[picture p96: figure]
BLE từ Clip; Service 0100… Notify 0104 Control 0105; NovaApp trong trình duyệt; Giải mã telemetry v1. Hiển thị mode, pin, chuyển động. Luyện rung và nhận SOS ID.; API Geolocation; Lấy vị trí khi có thao tác; localStorage và GeoJSON; Nhật ký điểm mặt đường; Ứng dụng SMS của máy; Mở bản nháp, người dùng gửi; Control tùy chọn

Objective | Userflow | System Diagram | Milestone | Assign Job | Risk Management | 38

Dữ liệu ứng dụng P1 nằm trong trình duyệt và các tệp người dùng xuất. Vòng cảnh báo trên Chest độc lập.

USER INTERFACE / 04.1

# NovaApp và quyền thao tác

04.1 · Giao diện hiện có và cửa sổ điều khiển

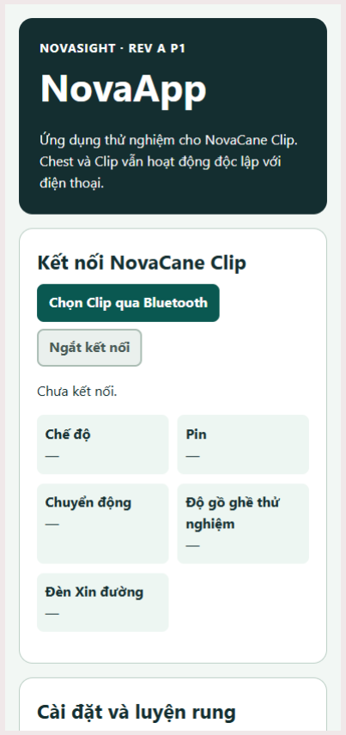
[picture p97: figure]

Objective | Userflow | System Diagram | Milestone | Assign Job | Risk Management | 39

Kết nối và đọc trạng thái

Chọn NovaClip P1. App đọc telemetry ban đầu và đăng ký notify. Mất BLE thì xóa trạng thái live.

Đặt mức hoặc luyện mẫu

Giữ Mode 3 s để mở quyền 60 s. Gửi op 1 đặt mức, op 2 luyện mẫu. Luyện khi Clip đứng yên.

Xác nhận phản hồi

Mức rung hiển thị theo telemetry. Phát mẫu tùy tình trạng pin, motor và trạng thái quét.

SEQUENCE DIAGRAM / 04.2

# SOS từ nút đến SMS

04.2 · Hành động vật lý, nhận sự kiện và xác nhận gửi

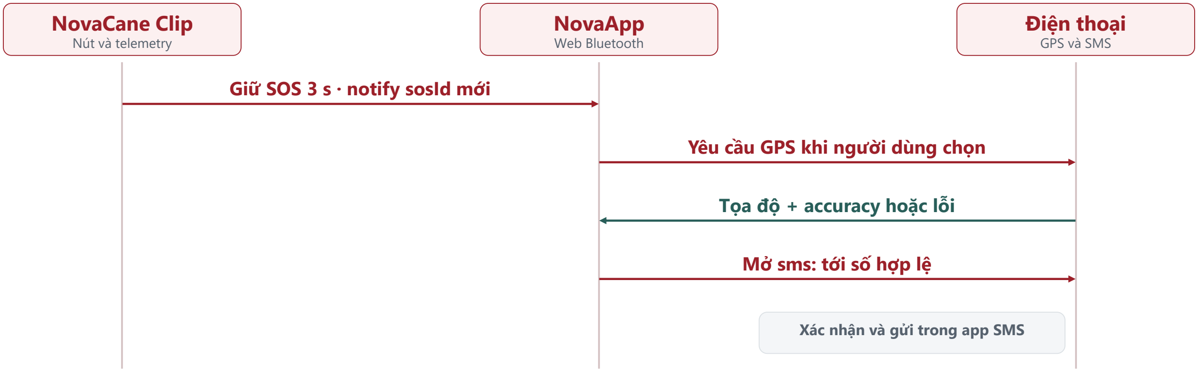
[picture p98: figure]
NovaCane Clip; Nút và telemetry; NovaApp; Web Bluetooth; Điện thoại; GPS và SMS; Giữ SOS 3 s · notify sosId mới; Yêu cầu GPS khi người dùng chọn; Tọa độ + accuracy hoặc lỗi; Mở sms: tới số hợp lệ; Xác nhận và gửi trong app SMS

Objective | Userflow | System Diagram | Milestone | Assign Job | Risk Management | 40

SOS ID tồn tại 120 s trong Clip. App lọc ID trùng trong phiên. Nếu GPS thất bại, vẫn có thể soạn SMS không kèm vị trí.

DATA HIERARCHY / 04.3

# Luồng dữ liệu điểm mặt đường

04.3 · Từ chỉ số Clip đến GeoJSON cục bộ

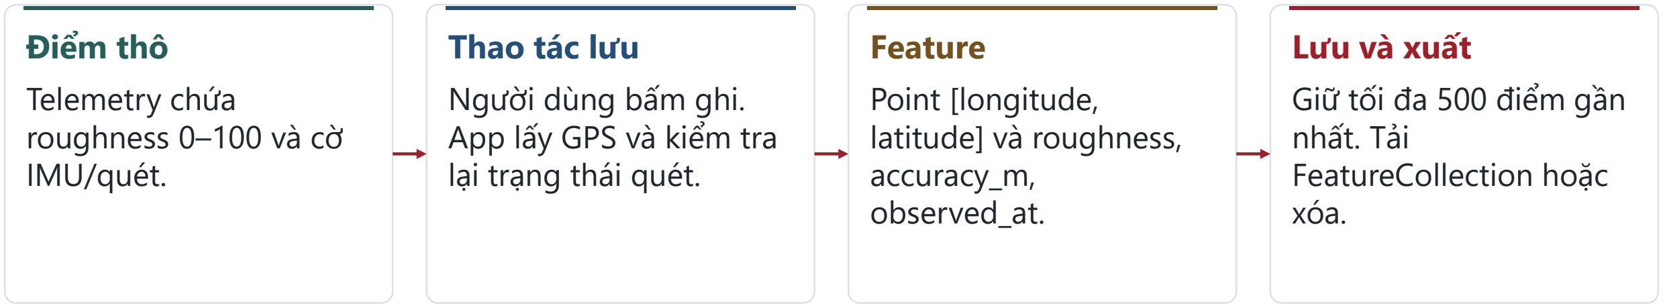
[picture p99: figure]
Điểm thô; Telemetry chứa roughness 0–100 và cờ IMU/quét.; Thao tác lưu; Người dùng bấm ghi. App lấy GPS và kiểm tra lại trạng thái quét.; Feature; Point [longitude, latitude] và roughness, accuracy_m, observed_at.; Lưu và xuất; Giữ tối đa 500 điểm gần nhất. Tải FeatureCollection hoặc xóa.
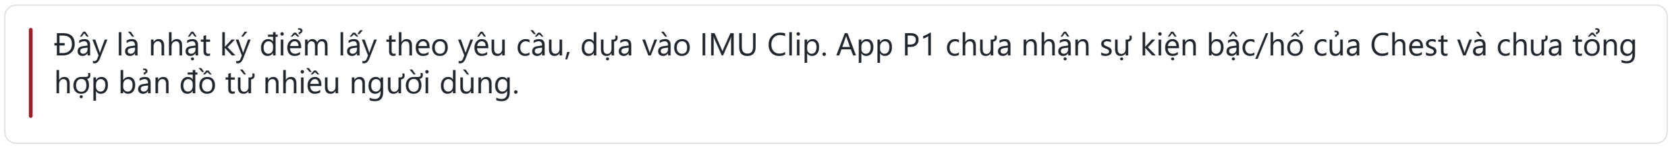
[picture p100: figure]
hợp bản đồ từ nhiều người dùng.

Objective | Userflow | System Diagram | Milestone | Assign Job | Risk Management | 41

Đây là nhật ký điểm lấy theo yêu cầu, dựa vào IMU Clip. App P1 chưa nhận sự kiện bậc/hố của Chest và chưa tổng

DATA HIERARCHY / L3–L4

# Từ điển dữ liệu và vòng đời

L3–L4 · Trường, đơn vị, vị trí và thời điểm tồn tại

Objective | Userflow | System Diagram | Milestone | Assign Job | Risk Management | 42
Đối tượng | Dữ liệu chính | Nơi tồn tại và vòng đời
RangeSample / RangeTrack | left, distance mm. Track giữ timestamp, count và lastEcho. | RAM Chest. Ứng viên mất hiệu lực khi tuổi mẫu ≥220 ms.
Motion / FloorFrame | pitch °, speed m/s, valid/quét; mm[16], status[16], taken ms. | RAM. Queue mới nhất một phần tử trên Chest.
FloorCalibration | mm[16], pitch °, version = 1. | NVS Chest sau hiệu chuẩn. Xóa bằng cal clear.
Event / Pulse | kind, side, distance mm, pulses; level, side, finished. | RAM. Có tuần tự hóa Event rút gọn cho BLE relay.
Telemetry / GeoJSON | Mode, pin mV, cờ, roughness, sosId; Point, sai số m, UTC ISO. | Telemetry tức thời. GeoJSON lưu cục bộ khi được yêu cầu.

DATA TRACE / VÍ DỤ

# Ví dụ từ cảm biến đến sự kiện

Kiểm tra từng lớp dữ liệu bằng một tình huống minh họa

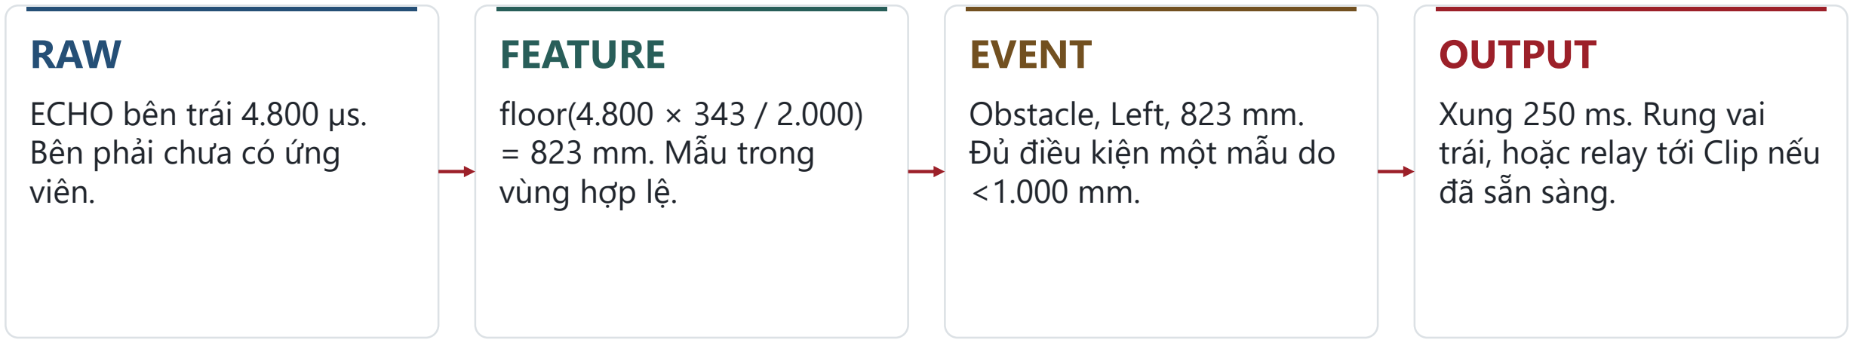
[picture p101: figure]
RAW; ECHO bên trái 4.800 µs. Bên phải chưa có ứng viên.; FEATURE; floor(4.800 × 343 / 2.000) = 823 mm. Mẫu trong vùng hợp lệ.; EVENT; Obstacle, Left, 823 mm. Đủ điều kiện một mẫu do <1.000 mm.; OUTPUT; Xung 250 ms. Rung vai trái, hoặc relay tới Clip nếu đã sẵn sàng.

Objective | Userflow | System Diagram | Milestone | Assign Job | Risk Management | 43

Giả định nguồn hợp lệ, mẫu còn mới, mode Đi bộ và chưa có nguy cơ mặt đất gần hơn theo ngưỡng ưu tiên.

Nếu Clip nhận Obstacle, firmware Clip phát cả hai motor. Hướng trái vẫn xác định đường rung cục bộ ở Chest.

DATA TRACE / VÍ DỤ ToF

# Ví dụ ToF từ lưới đến Event

Đối chiếu số liệu qua các lớp bù nghiêng, kiểm tra cặp và đếm khung

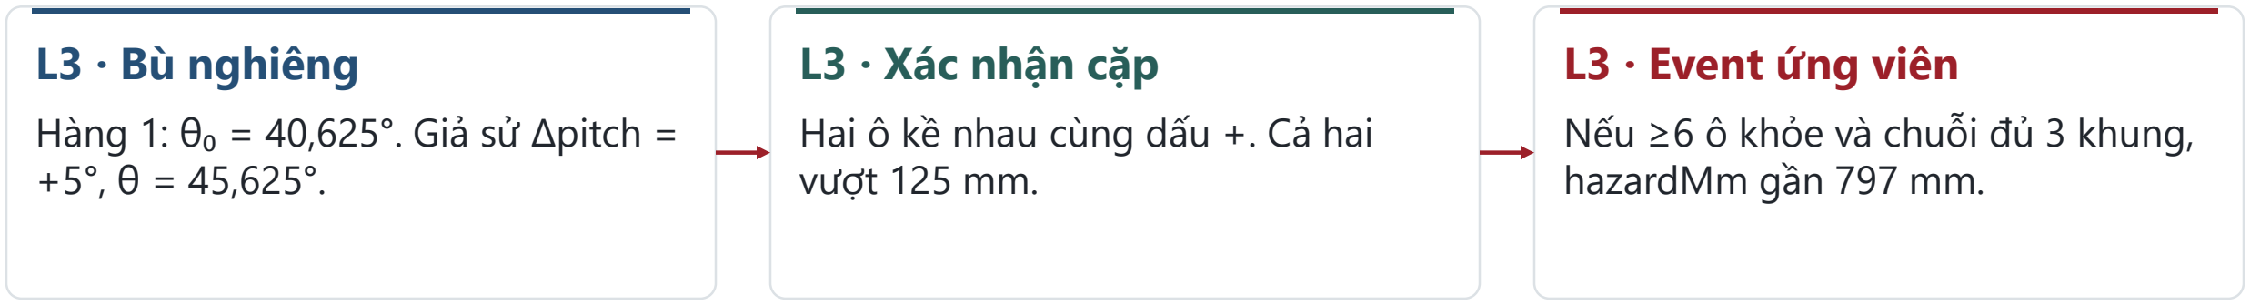
[picture p102: figure]
L3 · Bù nghiêng; Hàng 1: θ₀ = 40,625°. Giả sử Δpitch = +5°, θ = 45,625°.; L3 · Xác nhận cặp; Hai ô kề nhau cùng dấu +. Cả hai vượt 125 mm.; L3 · Event ứng viên; Nếu ≥6 ô khỏe và chuỗi đủ 3 khung, hazardMm gần 797 mm.

Objective | Userflow | System Diagram | Milestone | Assign Job | Risk Management | 44
Ô hàng 1 | Nền d₀ | ToF dₘ | dₑ sau bù | Δh | x chiếu
Cột 1 | 1.600 mm | 1.140 mm | 1.457,5 mm | +226,9 mm | 797,3 mm
Cột 2 | 1.600 mm | 1.160 mm | 1.457,5 mm | +212,6 mm | 811,2 mm

Ví dụ tính toán giả định ô status 5, nền hợp lệ và khung mới. Trọng tài còn xét Mode và vật cản thân trên.

VERIFICATION

# Kiểm chứng phần mềm và build

Kết quả đọc từ log và kiểm thử chạy lại trên máy phát triển

Objective | Userflow | System Diagram | Milestone | Assign Job | Risk Management | 45
Hạng mục | Kết quả | Phạm vi
Build NovaChest | SUCCESS · RAM 35.800 B · Flash 738.805 B | Theo log PlatformIO. Bộ nhớ phần build, chưa gồm số đo runtime.
Build NovaCane Clip | SUCCESS · RAM 24.412 B · Flash 562.646 B | Theo log PlatformIO. Dùng target P1 đã cấu hình.
Kiểm thử C++ | Pass · xung rung, nút, khoảng cách và lưới ToF | Kiểm tra logic thuần trên máy, không có cảm biến thực.
Kiểm thử NovaApp | 3/3 pass · telemetry, control và GeoJSON | Kiểm tra định dạng giao thức và thứ tự kinh độ/vĩ độ.

BUILD EVIDENCE

# Bộ nhớ từ log build P1

Tỷ lệ sử dụng RAM tĩnh và phân vùng ứng dụng

Objective | Userflow | System Diagram | Milestone | Assign Job | Risk Management | 46

10.9%

7.5%

11.3%

17.9%

0%

5%

10%

15%

20%

25%

NovaChest | NovaCane Clip
RAM | Flash

## RAM

## Chest 35.800 B Clip 24.412 B

## FLASH

## Chest 738.805 B Clip 562.646 B

Log build ngày 10/11/2026. Dữ liệu phản ánh ảnh firmware khi liên kết. Heap, stack, PSRAM và đỉnh cấp phát cần đo khi chạy.

VERIFICATION

# Kế hoạch đo và benchmark nguyên mẫu

Báo cáo theo từng kịch bản và tách mục tiêu khỏi kết quả đo

Objective | Userflow | System Diagram | Milestone | Assign Job | Risk Management | 47
Bài thử | Thay đổi có kiểm soát | Số liệu và bằng chứng cần ghi
Khoảng cách và hướng | 0,5 / 1 / 2 / 2,5 m, trái/giữa/phải, bề mặt phản xạ khác nhau | Sai số khoảng cách, nhầm hướng, bỏ sót, báo nhầm.
Mặt đất và độ tin cậy | Nền phẳng, bậc lên/xuống, trong nhà, bóng râm, nắng | Số ô hợp lệ, sai lệch nền, tỷ lệ cảnh báo và Không chắc.
Độ trễ | Chest độc lập, relay ổn định, chờ ACK, nhiều khung | Từ khi mục tiêu vào vùng kiểm đến PWM: median, p95 và max.
Rung, nguồn và SOS | Mức 1–3, pin thấp, cắm/rút USB, GPS cấp/từ chối | Duty, dòng/nhiệt, sự kiện trùng hoặc mất, bước xác nhận SMS.

Mục tiêu brief ≤200 ms. Đo nhánh mất ACK riêng vì firmware cho phép chờ đến 650 ms trước khi đánh giá lại.

NOVASIGHT
03

# MILESTONE

## Lộ trình kiểm chứng theo các mốc bàn giao

Sáu mốc cho nguyên mẫu Rev A P1

Objective | Userflow | System Diagram | Milestone | Assign Job | Risk Management | 48

MILESTONE

# Lộ trình hoàn thiện

Milestone · Các mốc theo thứ tự phụ thuộc kỹ thuật

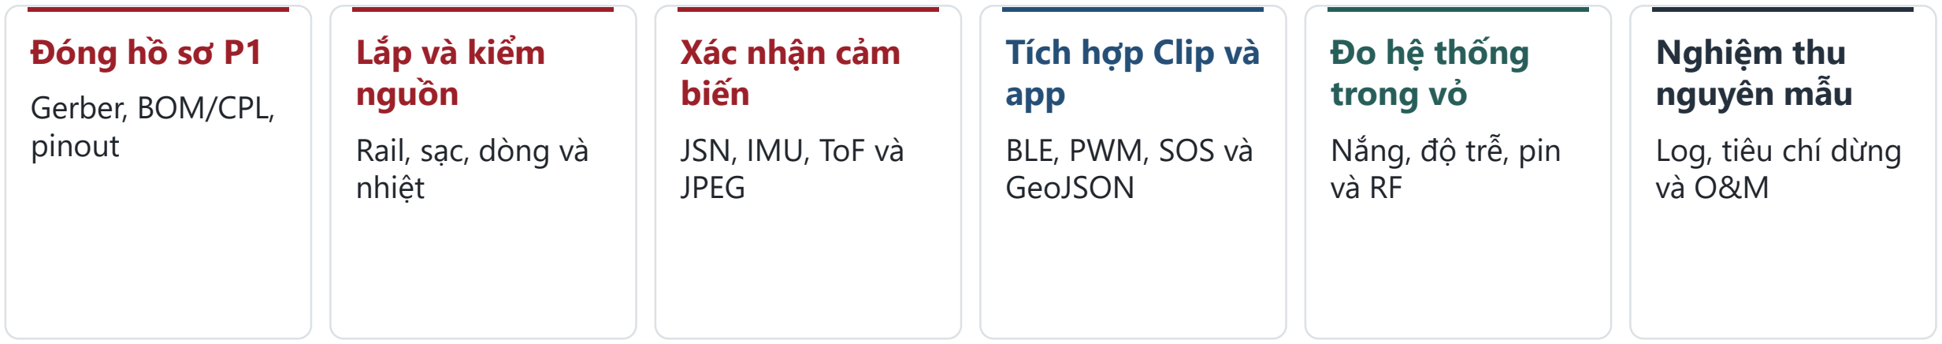
[picture p103: figure]
Đóng hồ sơ P1; Gerber, BOM/CPL, pinout; Lắp và kiểm nguồn; Rail, sạc, dòng và nhiệt; Xác nhận cảm biến; JSN, IMU, ToF và JPEG; Tích hợp Clip và app; BLE, PWM, SOS và GeoJSON; Đo hệ thống trong vỏ; Nắng, độ trễ, pin và RF; Nghiệm thu nguyên mẫu; Log, tiêu chí dừng và O&M

Objective | Userflow | System Diagram | Milestone | Assign Job | Risk Management | 49

Chuyển mốc sau khi có bằng chứng đo và danh sách lỗi còn mở. Chốt lịch và người phụ trách theo nguồn lực thực tế.

ASSIGN JOB

# Assign Job và Work Flow

Ma trận đề xuất theo vai trò của nhóm

Objective | Userflow | System Diagram | Milestone | Assign Job | Risk Management | 50
Vai trò | Việc phụ trách | Bàn giao
Phần cứng và cơ khí | Duyệt Gerber, footprint, vỏ, dây, pinout và nguồn | Checklist lắp, sơ đồ rail, log nhiệt và ảnh lắp vỏ.
Firmware NovaChest | Thu nhận, hiệu chuẩn, xử lý sự kiện và rung cục bộ | Bộ kịch bản khoảng cách/nền, log serial và dạng sóng.
Firmware Clip và BLE | IMU, nút, motor, beacon và giao thức relay | Kết quả mất ACK, cửa sổ setup, kiểm thử nguồn và tải.
NovaApp và kiểm thử | Tương thích BLE, SOS/GPS, nhật ký và thu kết quả | Ma trận trình duyệt/điện thoại, tệp mẫu GeoJSON, báo cáo kiểm chứng.

NOVASIGHT
04

# RISK ASSESSMENT

## Rủi ro kỹ thuật và ưu tiên kiểm chứng

Đánh giá sơ bộ cho phiên bản nguyên mẫu

Objective | Userflow | System Diagram | Milestone | Assign Job | Risk Management | 51

RISK MANAGEMENT

# Risk Assessment Table

Ma trận sơ bộ trước đo trên mẫu

Objective | Userflow | System Diagram | Milestone | Assign Job | Risk Management | 52
Khả năng / Tác động | Thấp | Vừa | Cao | Rất cao
Thường gặp | Theo dõi | Kiểm tra | Ưu tiên | Ưu tiên
Có thể | Theo dõi | R5, R6 | R2, R3 | R1, R4
Ít gặp | Theo dõi | Theo dõi | Kiểm tra | Ưu tiên
Hiếm | Theo dõi | Theo dõi | Kiểm tra | Kiểm tra
R1 Bỏ sót vật cản/nền | R2 Thiếu dữ liệu ToF | R3 Trễ relay hoặc ACK mơ hồ
R4 Mất nguồn/reset | R5 SOS chưa gửi | R6 Nhầm mẫu rung

Mức khả năng và tác động là giả định để xếp thứ tự thử. Cập nhật theo dữ liệu đo và sự cố trên mẫu.

RISK MANAGEMENT

# Rủi ro và hành động kiểm chứng

Chuyển mỗi rủi ro thành một phép thử hoặc kiểm tra cụ thể

Objective | Userflow | System Diagram | Milestone | Assign Job | Risk Management | 53
Mã | Cơ chế cần xem xét | Hành động và bằng chứng
R1 / R2 | Mù vùng đo, phản xạ yếu, ToF nắng gắt hoặc lệch trục | Đo tập tình huống chuẩn. Ghi bỏ sót, báo nhầm, số ô mạnh và Không chắc.
R3 | Relay chậm, mất BLE hoặc trạng thái ACK mơ hồ | Đo p95/max và số lần mất/trùng trên cả Chest và Clip.
R4 | Sụt rail, cắm/rút USB hoặc motor khởi động | Đo rail, dòng đỉnh, PWM, nhiệt và số reset ở tải thực.
R5 | GPS bị từ chối, không có Clip hoặc SMS chưa xác nhận | Thử cùng người dùng, xác minh SMS có/không vị trí theo kịch bản.
R6 | Người dùng khó phân biệt mẫu hoặc khó thao tác nút | Đo tỷ lệ nhận đúng, cảm nhận mức rung và tình huống thao tác khi đeo.

RISK MANAGEMENT

# Nguồn đối chiếu

Tài liệu thiết kế và mã nguồn của đúng phiên bản

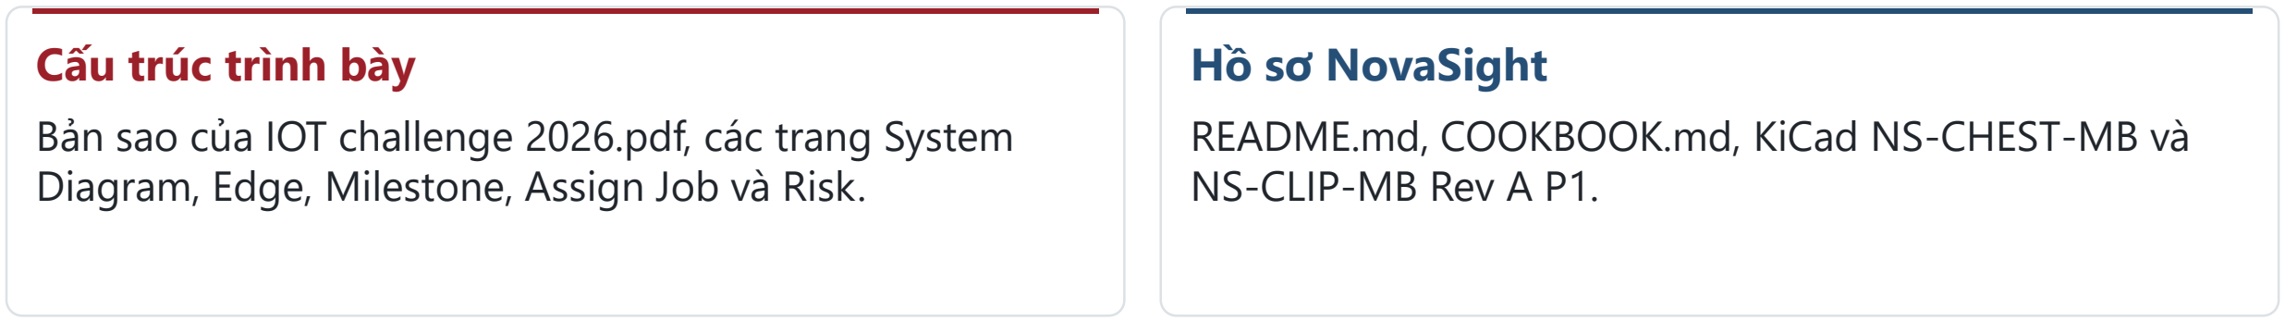
[picture p104: figure]
Cấu trúc trình bày; Hồ sơ NovaSight; README.md, COOKBOOK.md, KiCad NS-CHEST-MB và NS-CLIP-MB Rev A P1.
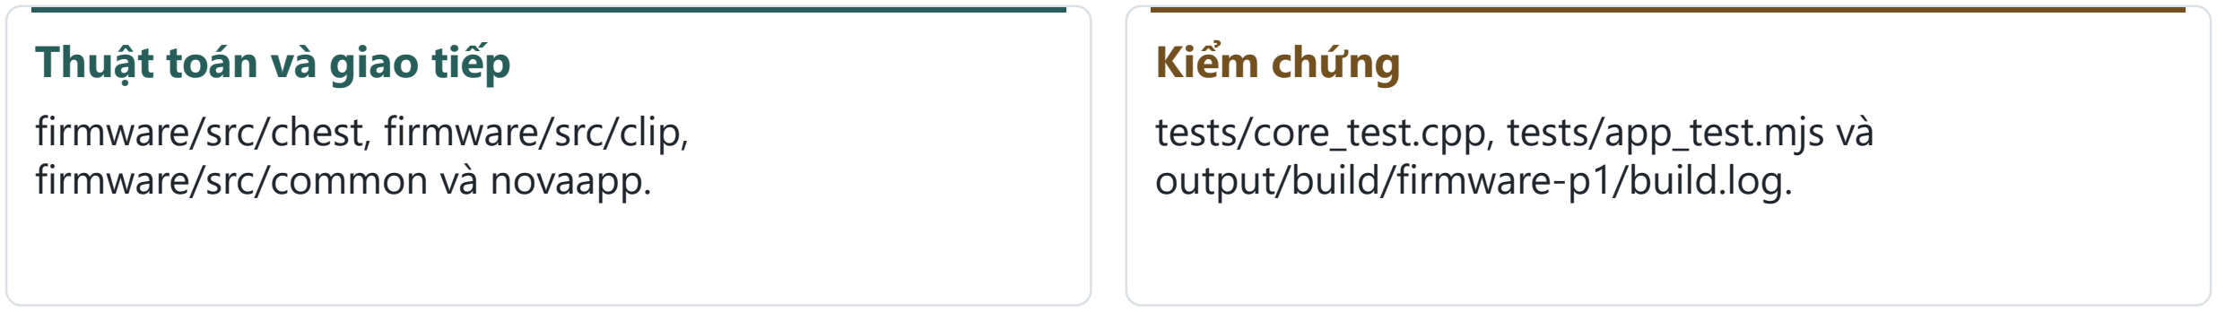
[picture p105: figure]
Thuật toán và giao tiếp; firmware/src/chest, firmware/src/clip, firmware/src/common và novaapp.; Kiểm chứng; tests/core_test.cpp, tests/app_test.mjs và output/build/firmware-p1/build.log.

Objective | Userflow | System Diagram | Milestone | Assign Job | Risk Management | 54

Bản sao của IOT challenge 2026.pdf, các trang System Diagram, Edge, Milestone, Assign Job và Risk.

NOVASIGHT

# NOVASIGHT

## Từ dữ liệu cảm biến đến phản hồi tại chỗ

NovaChest · NovaCane Clip · NovaApp

Objective | Userflow | System Diagram | Milestone | Assign Job | Risk Management | 55
