gwangzeejay/NovaSight/hardware/NS-CHEST-MB/exports/NS-CHEST-MB.png

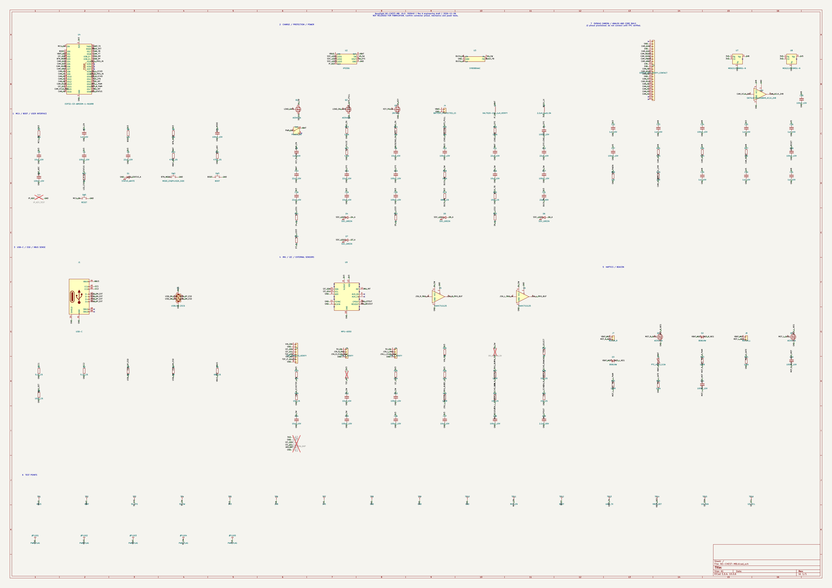
hardware/NS-CHEST-MB/exports/NS-CHEST-MB.png
