gwangzeejay/NovaSight/hardware/NS-CLIP-MB/exports/NS-CLIP-MB.png

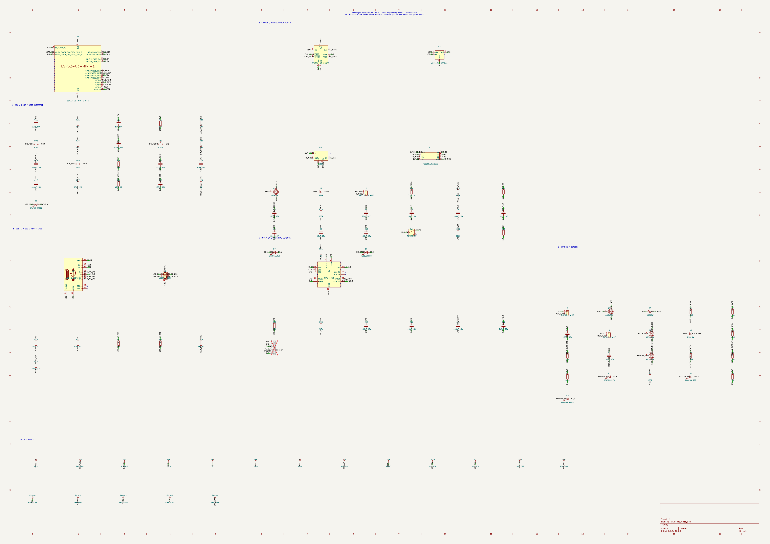
hardware/NS-CLIP-MB/exports/NS-CLIP-MB.png
