gwangzeejay/NovaSight/source_review/brief_2.png

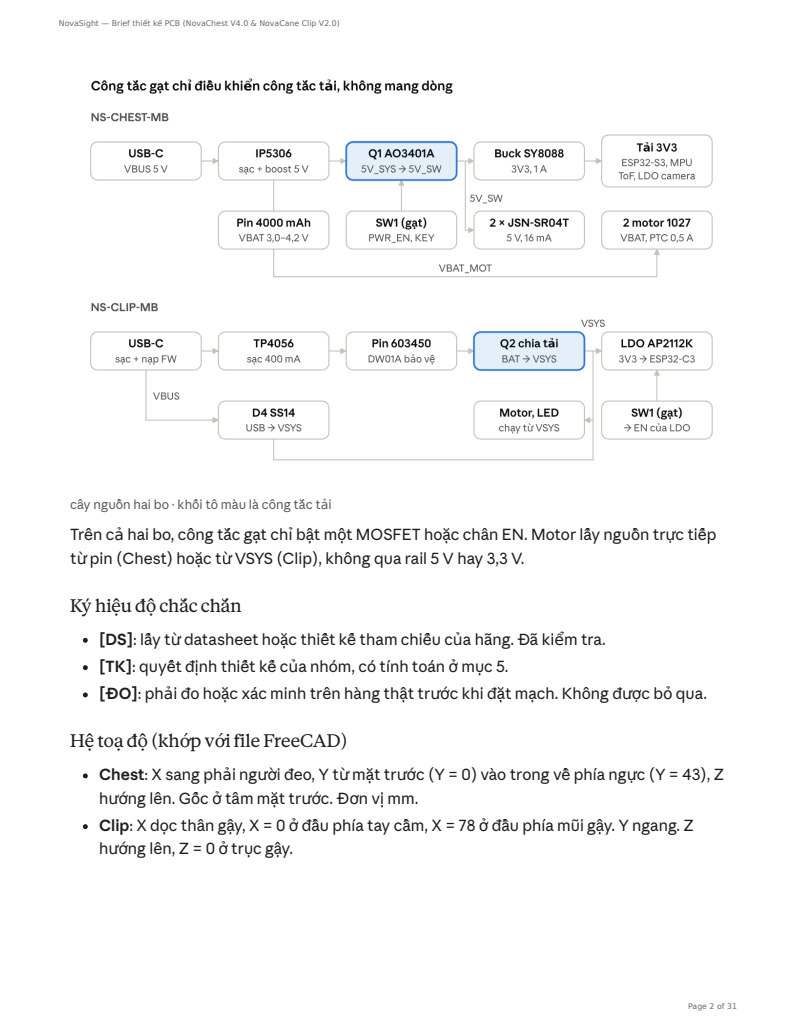
source_review/brief_2.png
