gwangzeejay/NovaSight/source_review/brief_5.png

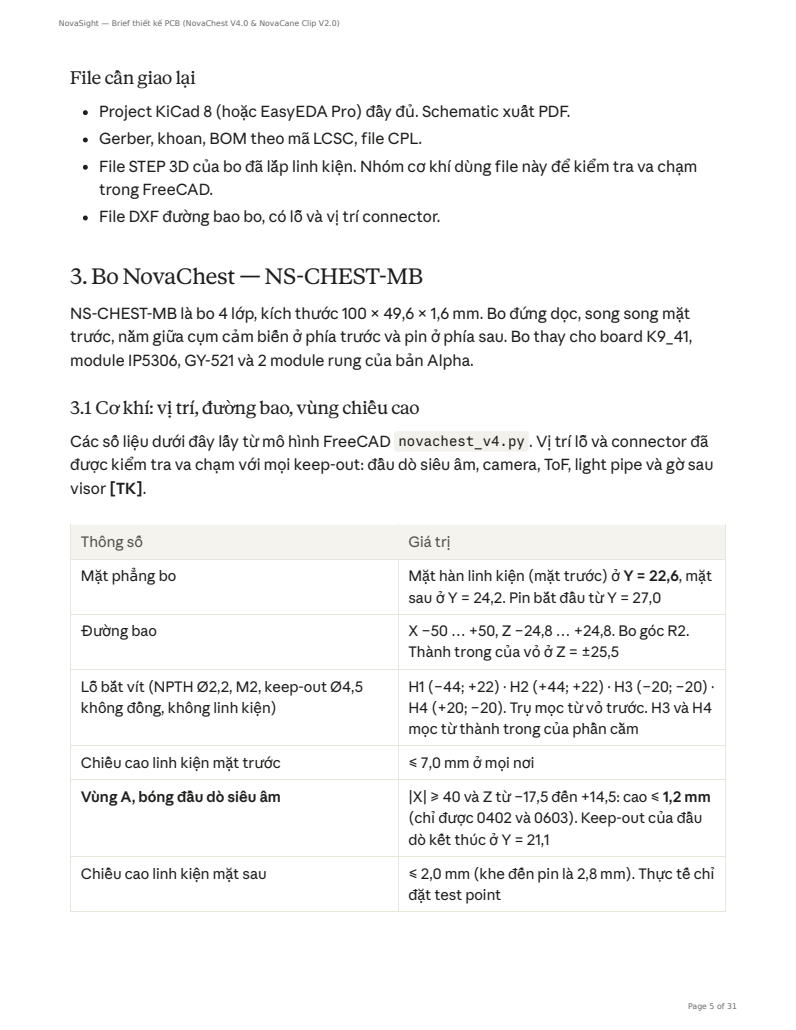
source_review/brief_5.png
