gwangzeejay/NovaSight/source_review/brief_6.png

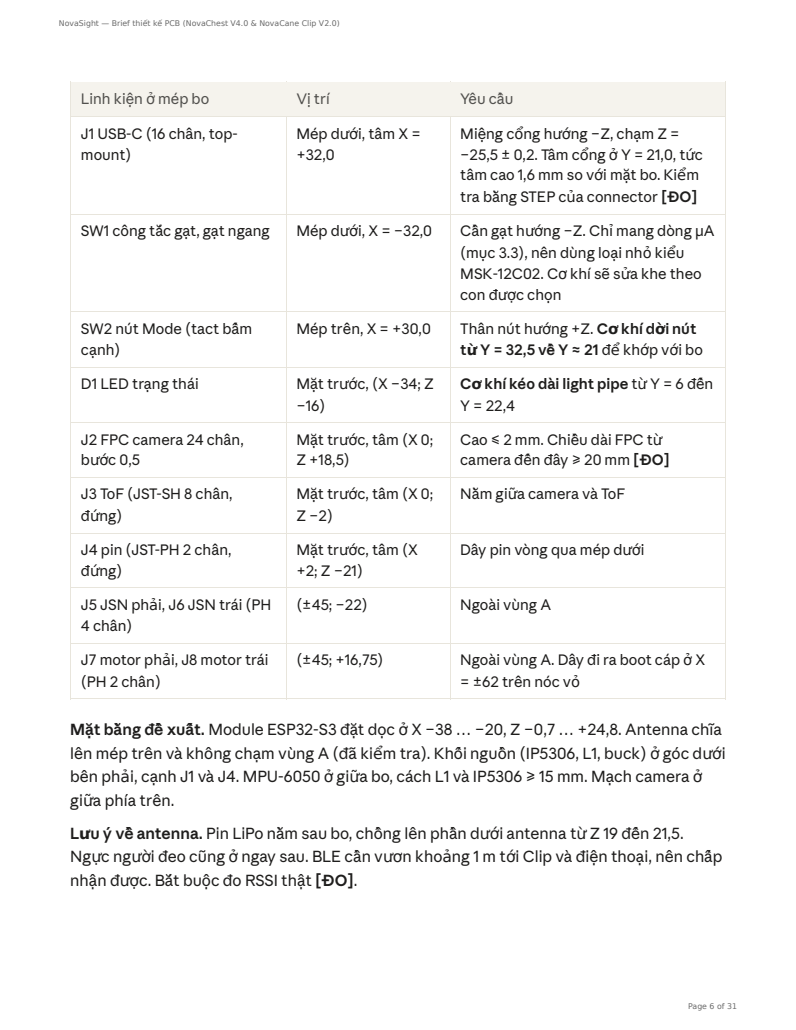
source_review/brief_6.png
