gwangzeejay/NovaSight/source_review/brief_7.png

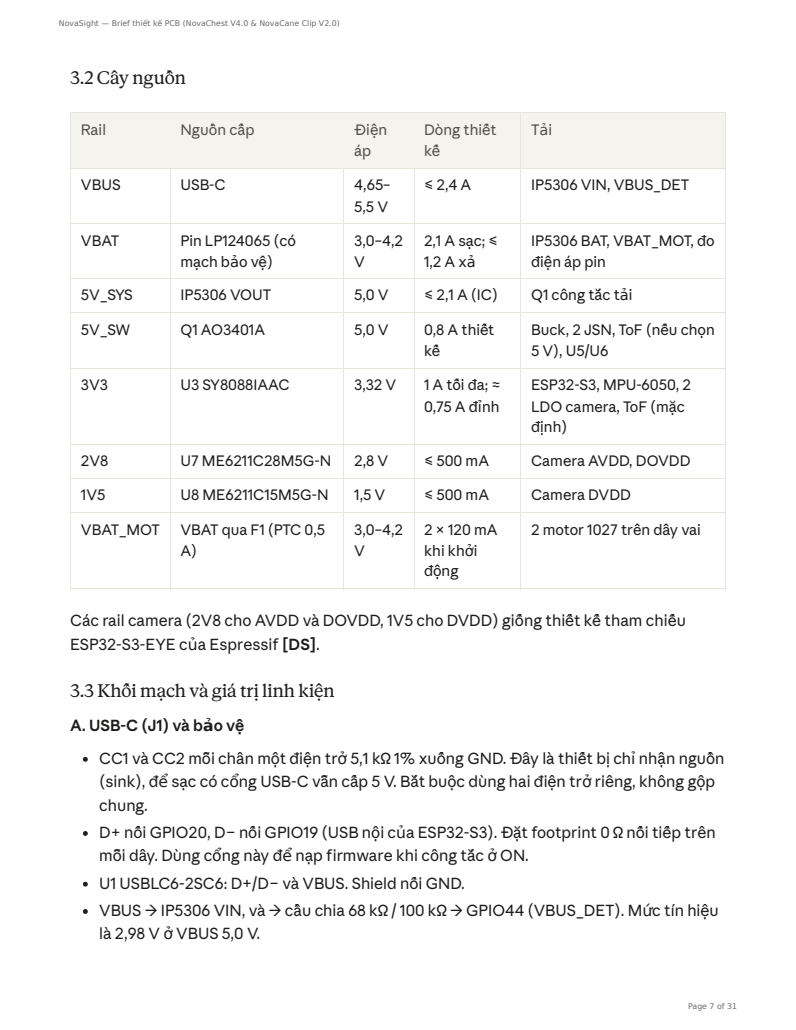
source_review/brief_7.png
