gwangzeejay/NovaSight/source_review/brief_14.png

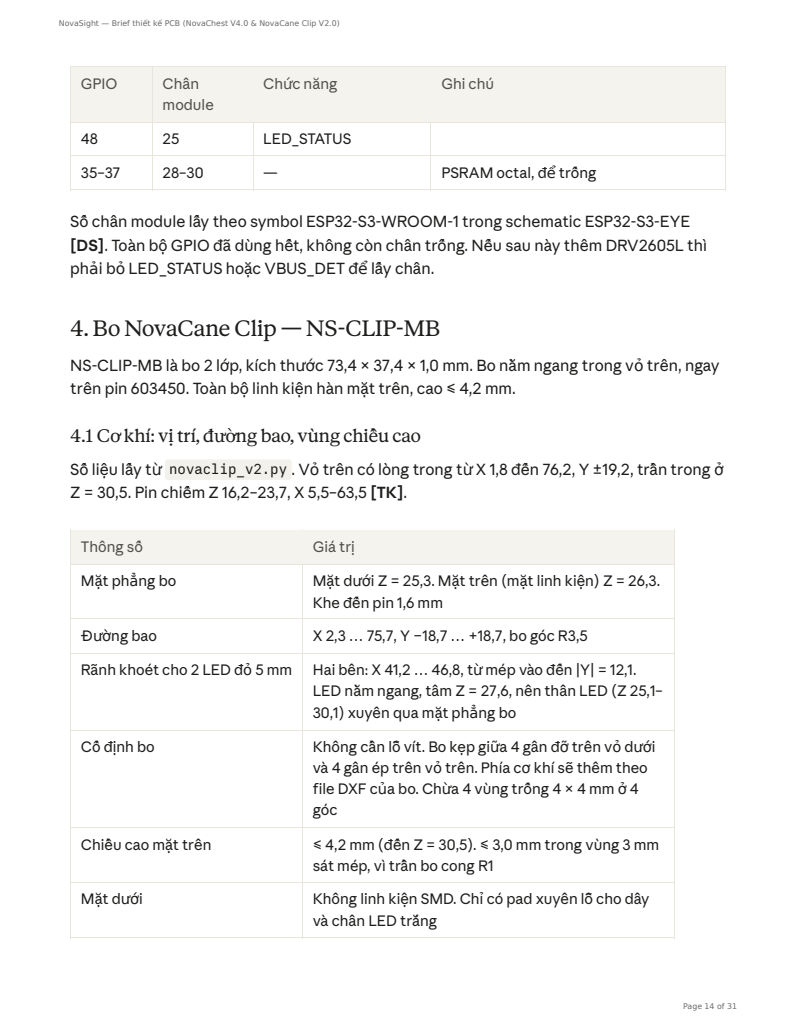
source_review/brief_14.png
