gwangzeejay/NovaSight/source_review/brief_15.png

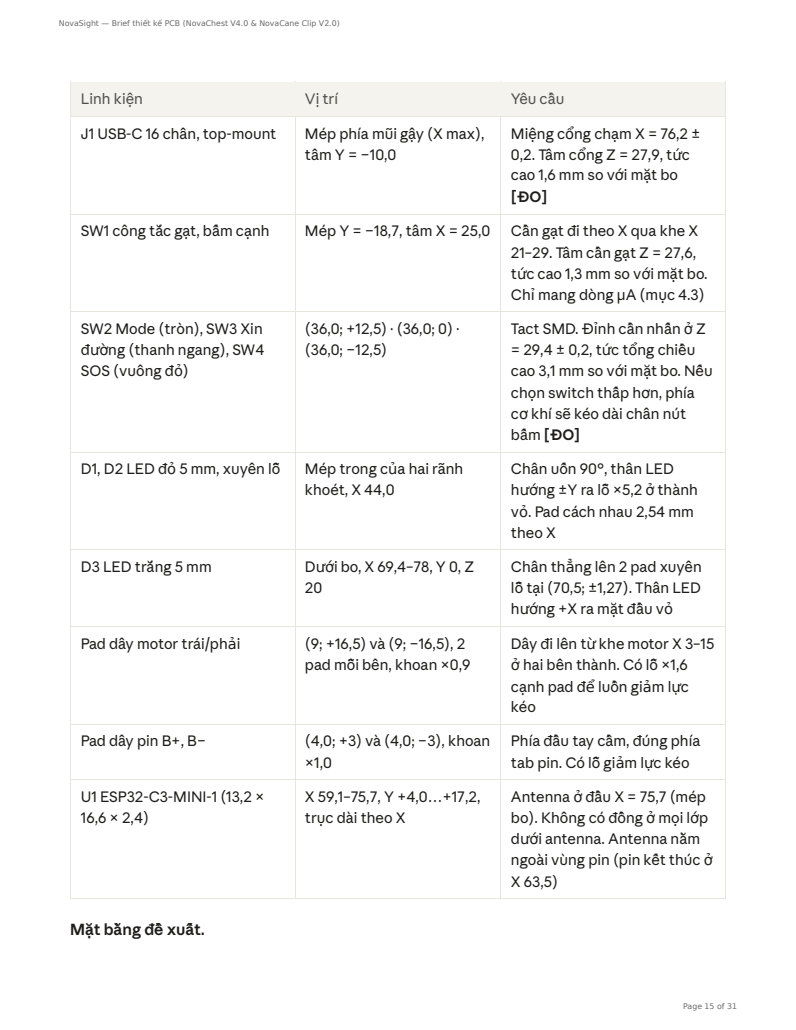
source_review/brief_15.png
