gwangzeejay/NovaSight/source_review/brief_16.png

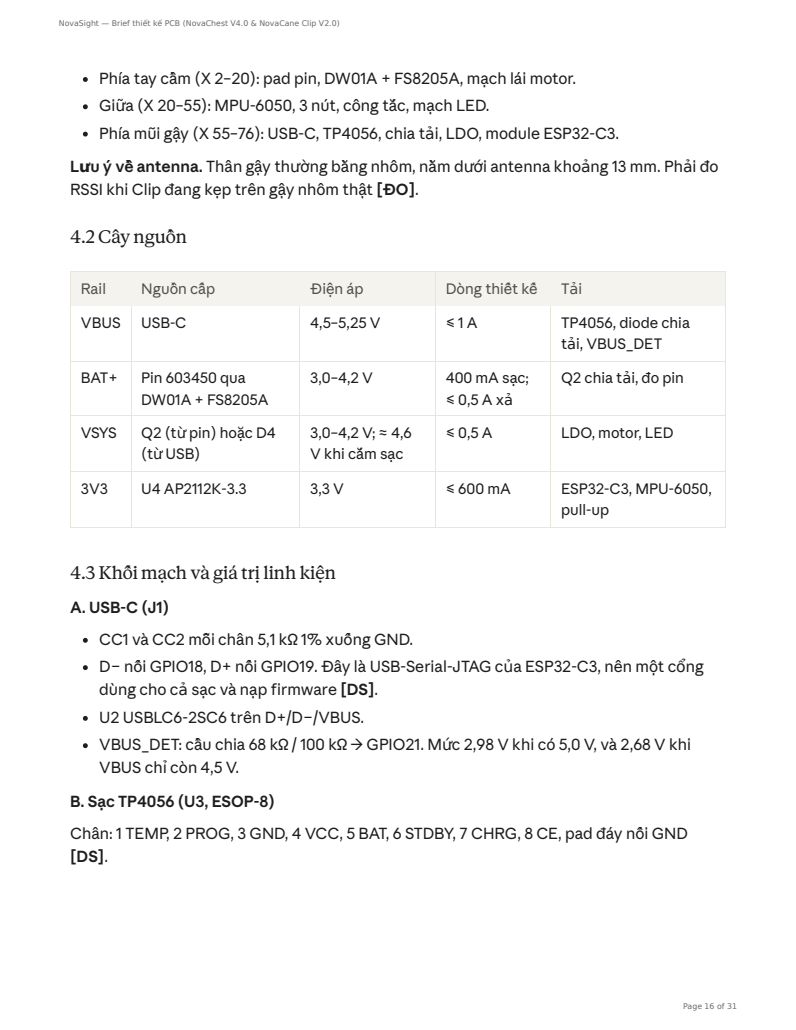
source_review/brief_16.png
