gwangzeejay/NovaSight/source_review/IP5306_application.png

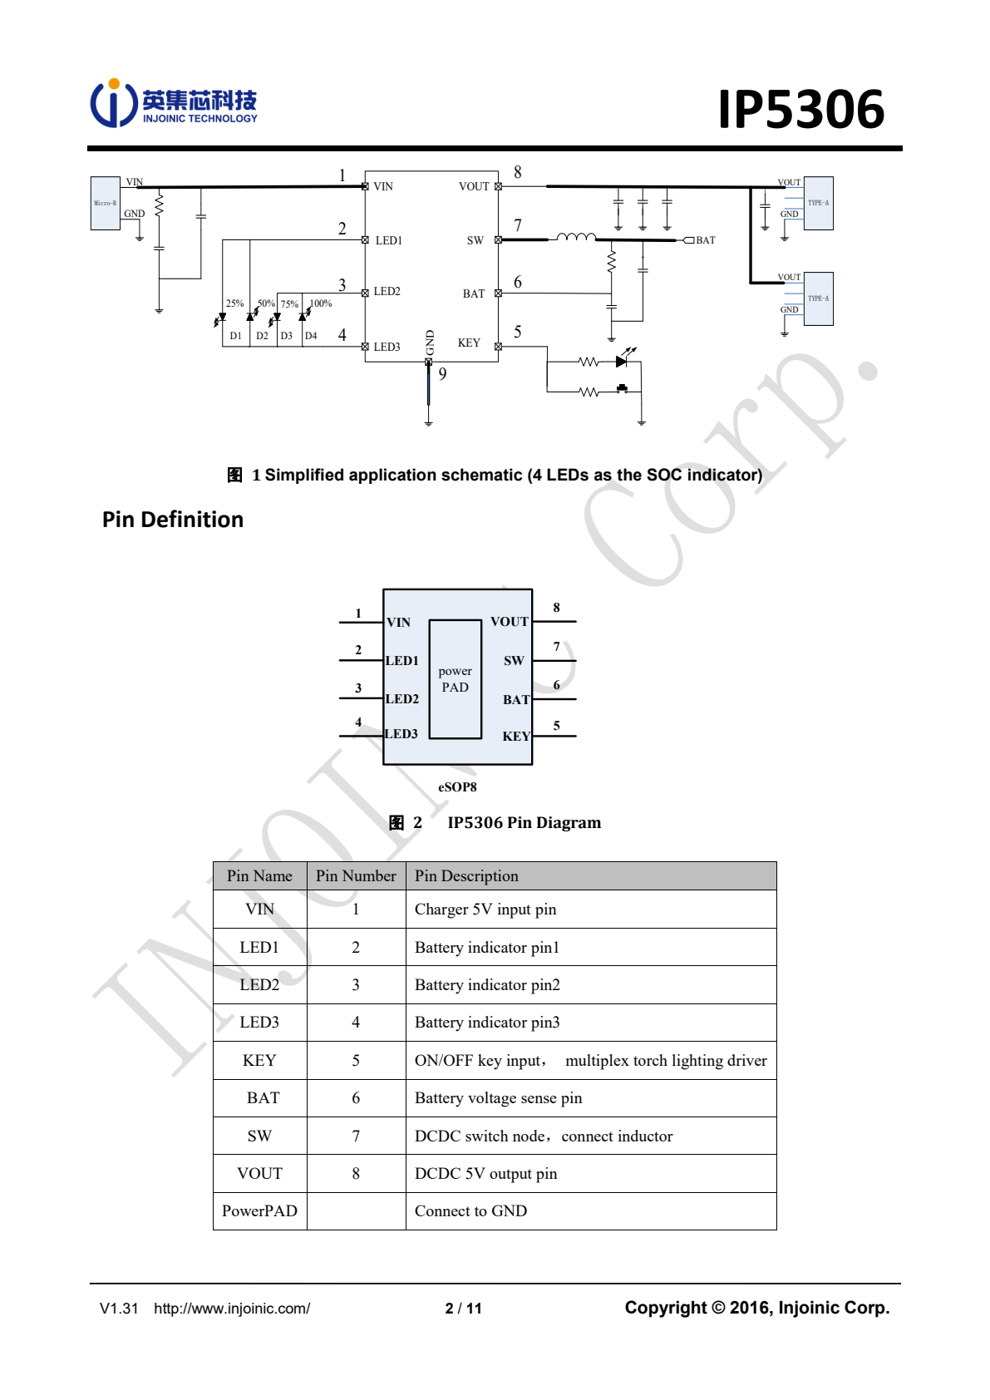
source_review/IP5306_application.png
