gwangzeejay/NovaSight/output/bom/NovaSight_BOM_Alpha-2_sua.xlsx

Sheet: Tổng hợp
NovaSight — BOM bản Alpha (2 sản phẩm)
Giá lấy từ trang sản phẩm của các shop ngày 06/11/2026. Chi tiết, link và phương án thay thế nằm ở 2 sheet sản phẩm.
Sản phẩm | Tổng BOM (đ) | Phần giá đã có trên web (đ) | Phần cần xác nhận giá (đ) | Số dòng linh kiện | Ghi chú
NovaChest V4.0 | 2028000 | 1538000 | 490000 | 24 | VL53L8CX đang HẾT HÀNG ở Đức Huy (670.000 đ). Phương án: chờ hàng hoặc nhập Pololu #3419.
NovaCane Clip V2.0 | 390670 | 162270 | 228400 | 17 | Thay module rung bằng motor trần 1027 + MOSFET vì khe motor nhỏ. Thay R_PROG của TP4056 sang 3,0 kΩ.
Tổng 1 bộ (Chest + Clip) | 2418670 | 1700270 | 718400
So với Đặc tả v2
Chest (Đặc tả v2) | 1874000
Clip (Đặc tả v2) | 417000
Chênh lệch 2 sản phẩm | 127670 |  |  |  | Dương = BOM mới cao hơn Đặc tả v2 (do giá K9_41 tăng, thêm phụ trợ, cơ khí và vít được liệt kê riêng).
Cách đọc
• Chữ xanh dương: số lượng và đơn giá nhập tay, sửa được. Thành tiền và tổng tự tính lại.
• Ô đơn giá tô vàng: Ước tính / Dự toán / giá Đặc tả v2, chưa có trên trang web của shop. Hỏi shop hoặc xưởng in 3D để chốt.
• Link Shopee dạng tìm kiếm (shopee.vn/search?keyword=…) dùng cho hàng phổ thông như vít, dây, gen co. Chọn shop có đánh giá tốt, gần TP.HCM.
• Cột 'Phương án thay thế' có nơi mua thứ hai và link, dùng khi nơi mua chính hết hàng.

Sheet: NovaChest V4.0
BOM NovaChest V4.0 — bản Alpha lắp từ module
Giá tra trên web các shop ngày 06/11/2026, có thể thay đổi. Ô vàng là giá ước tính hoặc dự toán, cần hỏi lại shop. Ô đỏ là hàng đang hết.
STT | Mã | Linh kiện / quy cách | SL | Đơn vị | Đơn giá (đ) | Thành tiền (đ) | Loại giá | Nơi mua chính | Link mua | Phương án thay thế (nơi mua, giá, link) | Ghi chú kỹ thuật
A. ĐIỆN TỬ CHÍNH
1 | C01 | ESP32-S3 WROOM N16R8 tích hợp camera OV5640 5MP (Đức Huy K9_41) | 1 | cái | 330000 | 330000 | Giá web | Điện tử Đức Huy | ESP32 S3 WROOM N16R8 WIFI TÍCH HỢP CAMERA OV5640 – LINH KIỆN ĐIỆN TỬ ĐỨC HUY (29A BÙI XUÂN PHÁI) (https://dientuduchuy.com/products/esp32-s3-wroom-n16r8-wifi-tich-hop-camera-ov5640) | Tuyết Nga: kit ESP32-S3 N16R8 TypeC chưa kèm camera, 155.000 đ, https://dientutuyetnga.com/products/esp32-cam-kit-phat-trien-esp32-s3-n16r8-typec + camera OV3660 68° rời (Đức Huy K2_14, 130.000 đ, đang hết) | Đặc tả v2 ghi 290.000 đ; giá web hiện tại 315.000 đ. Mua dư 1 con dự phòng vì đang còn ít. [CẦN XÁC NHẬN: đơn giá 330.000 đ nhưng ghi chú trên nói giá web hiện tại 315.000 đ. Kiểm tra lại giá. SL trong bảng là 1, con mua dự phòng chưa tính vào tổng.]
2 | C02 | Breakout ToF VL53L8CX 8×8 vùng, VIN 3,3 V | 1 | cái | 670000 | 670000 | Giá web | Điện tử Đức Huy | https://dientuduchuy.com/products/vl53l8cx-cam-bien-do-khoang-cach-laser-time-of-flight-tof-do-chinh-xac-cao | Pololu #3419 (có LDO + chuyển mức, VIN 3,2–5,5 V), 24,95 USD + phí nhập, https://www.pololu.com/product/3419 | Board Đức Huy ghi VIN 3,3 V: cấp từ 3,3 V, KHÔNG cấp 5 V. Gọi shop hỏi ngày về hàng trước khi đặt.
3 | C03 | Cảm biến siêu âm chống nước JSN-SR04T (đầu dò + board, cáp 2,5 m) | 2 | bộ | 140000 | 280000 | Giá web | Điện tử Tuyết Nga | https://dientutuyetnga.com/products/jsn-sr04t-cam-bien-sieu-am-chong-nuoc | Nguyễn Hiền: 135.000 đ, tồn 5, https://www.dientunguyenhien.vn/show/145 | Chế độ 0 (Mode để hở). ECHO ra mức 5 V: phải qua cầu chia 10k/20k trước khi vào GPIO.
4 | C04 | Module IMU GY-521 MPU6050 | 1 | cái | 73000 | 73000 | Giá web | Thegioiic | https://www.thegioiic.com/gy-521-mpu-6050-cam-bien-con-quay-gia-toc | Caka: 74.000 đ, https://caka.vn/cam-bien-gy-521-mpu6050-do-gia-toc-goc-6-truc-imu | Gắn cứng lên khung, không lót mút.
5 | C05 | Pin Li-Po 3,7 V 4000 mAh 12×40×65 mm (LP124065), có mạch bảo vệ | 1 | viên | 90000 | 90000 | Giá web | Linh kiện Thành Công | https://linhkienthanhcong.com/pin-lipo-polymer-3-7v-4000mah-12x40x65mm-co-mach-bao-ve | handphone.vn (Hà Nội): 70.000 đ + 10.000 đ mạch bảo vệ, https://handphone.vn/pin-li-po-3-7v-124065-4000mah.html | Bắt buộc loại có mạch bảo vệ. Kiểm tra kích thước thật trước khi in vỏ.
6 | C06 | Mạch sạc + boost 5 V 2,1 A MH-CD42 (IP5306) | 1 | cái | 15000 | 15000 | Giá web | Điện tử Đức Huy | https://dientuduchuy.com/products/mhcd42-ip5306-mach-sac-pin-1s-kem-tang-ap-5v-2a-co-den-bao-dung-luong | Hshop: 20.000 đ, https://hshop.vn/products/mach-sac-pin-lithium-va-cap-nguon-5vdc-2-1a-mh-cd42 | Tự tắt khi tải < 45 mA quá 32 s. Mua dư 1.
7 | C06b | Đế ra chân USB-C cái (chỉ lấy nguồn 5 V) cho cổng sạc ở đáy vỏ | 1 | cái | 5000 | 5000 | Ước tính | Shopee | https://shopee.vn/search?keyword=breakout%20usb%20type%20c%20cái%202%20chân | Mua tại shop linh kiện gần nhất | Nối vào VIN của MH-CD42. Vị trí X +32 ở đáy vỏ. [LƯU Ý: cổng này chỉ có nguồn 5 V, không nạp firmware được khi đã lắp vỏ. Nạp qua cổng USB của board ESP32 trước khi đóng vỏ.]
8 | C07 | Mạch động cơ rung 1027 tích hợp MOSFET, 3–5,3 V | 2 | cái | 40000 | 80000 | Giá web | Điện tử RLAB | https://dienturlab.com/san-pham/mach-dong-co-rung-viration-motor-1027/ | Motor 1027 trần 10.000 đ (Tuyết Nga) + MOSFET tự hàn, https://dientutuyetnga.com/products/1027-dong-co-rung-tron | Trang sản phẩm ghi 40.000 đ, trang danh mục ghi 30.000 đ. Đặt trong túi trên dây vai. [LƯU Ý: module 3–5,3 V cấp từ 5 V thì điện áp trung bình trên motor 1027 cao hơn khoảng 19% so với firmware tính theo rail pin 4,2 V (mục tiêu ~3 V). Cấp từ VBAT hoặc kiểm tra lại duty, và xác nhận định mức motor theo datasheet.]
B. PHỤ TRỢ ĐIỆN
9 | C08a | Công tắc gạt mini 2 vị trí, chịu ≥ 2 A | 1 | cái | 5000 | 5000 | Ước tính | Shopee | https://shopee.vn/search?keyword=công%20tắc%20gạt%20mini%202A | Điện tử Tuyết Nga, Đức Huy (mua tại quầy) | Ở đáy vỏ, X −32. Cắt dòng 5 V nên phải ≥ 2 A. [LƯU Ý: công tắc gạt mini phổ biến (SS12D00, MSK12C02) chỉ chịu khoảng 0,3–0,5 A, giá ước tính 5.000 đ khó mua được loại ≥ 2 A. Chọn linh kiện thật, hoặc dùng công tắc chỉ điều khiển MOSFET/chân EN như brief P1.]
10 | C08b | Nút nhấn 6×6 mm (Mode) | 1 | cái | 1000 | 1000 | Ước tính | Shopee | https://shopee.vn/search?keyword=nút%20nhấn%206x6 | Mua tại quầy | Trên nóc vỏ.
11 | C08c | LED 3 mm trắng + điện trở 1 kΩ (LED trạng thái sau light pipe) | 1 | bộ | 1000 | 1000 | Ước tính | Điện tử Đức Huy | https://dientuduchuy.com/products/led-do-3mm-10-con | — | Chỉ dành cho kỹ thuật viên. [CẦN XÁC NHẬN: mô tả là LED trắng nhưng link là LED đỏ 3 mm. LED trắng (~3 V) với 1 kΩ ở 3,3 V gần như không sáng; giảm điện trở hoặc đổi màu LED.]
12 | C08d | Điện trở 1/4 W: 10 kΩ ×2, 20 kΩ ×2 (chia ECHO), 100 kΩ ×2 (đo pin) | 1 | bộ | 3000 | 3000 | Ước tính | Shopee | https://shopee.vn/search?keyword=điện%20trở%201/4w | Mua tại quầy | Cầu chia ECHO 5 V → 3,3 V.
13 | C08e | Dây silicone 26 AWG (đỏ, đen) 1 m mỗi màu | 2 | m | 4000 | 8000 | Ước tính | Shopee | https://shopee.vn/search?keyword=dây%20silicone%2026awg | Mua tại quầy | Dây mềm, chịu nhiệt.
14 | C08f | Cáp 3 lõi mềm 50 cm cho 2 hộp rung trên dây vai | 2 | sợi | 5000 | 10000 | Ước tính | Shopee | https://shopee.vn/search?keyword=dây%20điện%203%20lõi%20mềm%2026awg | Mua tại quầy | Đi qua 2 boot cáp ở X ±62 trên nóc.
15 | C08g | Bộ jack JST-PH 2.0 có dây bấm sẵn (2P ×3, 3P ×2, 4P ×2) | 1 | bộ | 15000 | 15000 | Ước tính | Shopee | https://shopee.vn/search?keyword=jst%20ph2.0%20dây%20bấm%20sẵn | Mua tại quầy | Để tháo thay cảm biến, motor và pin. [THIẾU: chưa có jack cho breakout ToF (5–6 chân: VIN, GND, SCL, SDA, LPn, INT) và GY-521 (4–5 chân). Thêm 6P ×1 và 5P ×1 hoặc ghi rõ hàn dây trực tiếp.]
16 | C08h | Gen co nhiệt các cỡ + băng keo Kapton | 1 | bộ | 10000 | 10000 | Ước tính | Shopee | https://shopee.vn/search?keyword=gen%20co%20nhiệt%20bộ | Mua tại quầy
17 | C08i | Mạch đục lỗ mini (interposer) 5×7 cm | 1 | tấm | 8000 | 8000 | Ước tính | Shopee | https://shopee.vn/search?keyword=mạch%20đục%20lỗ%205x7 | Mua tại quầy | Gom cầu chia, jack JST. Bỏ khi chuyển sang bo PCB Beta.
C. CƠ KHÍ, VỎ, ĐEO
18 | C09a | Vỏ in 3D PETG màu sáng: nắp trước, thân sau, gờ mày, visor (graphite), nút Mode | 1 | bộ | 150000 | 150000 | Dự toán | Xưởng in 3D (TP.HCM) | https://shopee.vn/search?keyword=dịch%20vụ%20in%203d%20petg | Tự in nếu nhóm có máy | Khối lượng nhựa theo CAD ≈ 123 g. File STL nằm trong thư mục NovaChest_V4.
19 | C09b | Chi tiết in TPU 95A: 2 vòng đỏ siêu âm, gioăng, nút cao su USB, 2 boot cáp, đệm lưng, 2 hộp rung | 1 | bộ | 50000 | 50000 | Dự toán | Xưởng in 3D (TP.HCM) | https://shopee.vn/search?keyword=dịch%20vụ%20in%203d%20tpu | — | TPU 95A; vòng siêu âm màu đỏ.
20 | C09c | Kính PC trong: Ø16 × 1,0 mm (camera) và 12,6 × 9,6 × 0,8 mm (ToF), cắt laser | 1 | bộ | 20000 | 20000 | Ước tính | Tiệm cắt laser mica/PC | https://shopee.vn/search?keyword=tấm%20polycarbonate%20trong%201mm | — | Cửa sổ ToF phải theo hướng dẫn cover glass của ST.
21 | C09d | Thanh dẫn sáng acrylic Ø3 mm, dài 6 mm | 1 | cái | 5000 | 5000 | Ước tính | Shopee | https://shopee.vn/search?keyword=thanh%20acrylic%20tròn%203mm | — | Bản PCB Beta cần dài hơn (đến Y = 22,4 mm).
22 | C09e | Vít lục giác chìm DIN 912 M2×35 inox | 4 | con | 1500 | 6000 | Ước tính | Shopee | https://shopee.vn/search?keyword=vít%20lục%20giác%20m2x35%20inox | Tiệm ốc vít (đường Nhật Tảo, Q.10) | Bắt từ mặt sau tại X ±57, Z ±23.
23 | C09f | Ốc cấy nhiệt (heat-set insert) đồng M2, cho lỗ Ø3,2 sâu 6 mm | 4 | con | 1000 | 4000 | Ước tính | Shopee | https://shopee.vn/search?keyword=ốc%20cấy%20nhiệt%20m2 | — | Ép bằng mỏ hàn.
24 | C10 | Dây đeo ngực kiểu action-camera (GoPro chest strap) kèm ốc vặn tay | 1 | bộ | 189000 | 189000 | Đặc tả v2 | Shopee | https://shopee.vn/search?keyword=dây%20đeo%20ngực%20gopro%20chest%20strap | Bản Beta dùng ray trượt + bộ dây riêng (xem file CAD) | Ngàm GoPro 2 ngón trên đế vỏ, lỗ Ø5,2.
 |  | TỔNG CỘNG |  |  |  | 2028000
 |  | Trong đó: giá đã có trên web (Giá web) |  |  |  | 1538000
 |  | Trong đó: giá Đặc tả v2 / ước tính / dự toán (cần xác nhận) |  |  |  | 490000

Sheet: NovaCane Clip V2.0
BOM NovaCane Clip V2.0 — bản Alpha lắp từ module
Giá tra trên web các shop ngày 06/11/2026, có thể thay đổi. Ô vàng là giá ước tính hoặc dự toán, cần hỏi lại shop. Ô đỏ là hàng đang hết.
STT | Mã | Linh kiện / quy cách | SL | Đơn vị | Đơn giá (đ) | Thành tiền (đ) | Loại giá | Nơi mua chính | Link mua | Phương án thay thế (nơi mua, giá, link) | Ghi chú kỹ thuật
A. ĐIỆN TỬ CHÍNH
1 | K01 | ESP32-C3 SuperMini 4 MB (USB-C), loại CHƯA hàn chân | 1 | cái | 63000 | 63000 | Giá web | Điện tử Tuyết Nga | https://dientutuyetnga.com/products/kit-phat-trien-wifi-bluetooth-esp32-c3-super-mini | Đức Huy: 73.000 đ (đã hàn chân), còn 16, https://dientuduchuy.com/products/esp32c3-supermini-wifi-bluetooth-da-han-chan | Lấy bản chưa hàn chân để vừa khoang 5,8 mm trong vỏ.
2 | K02 | Module IMU GY-521 MPU6050 | 1 | cái | 73000 | 73000 | Giá web | Thegioiic | https://www.thegioiic.com/gy-521-mpu-6050-cam-bien-con-quay-gia-toc | Caka: 74.000 đ, https://caka.vn/cam-bien-gy-521-mpu6050-do-gia-toc-goc-6-truc-imu | Bỏ header, hàn dây trực tiếp để thấp.
3 | K03 | Pin Li-Po 3,7 V 603450 (6×34×50 mm) ~1200 mAh, có mạch bảo vệ | 1 | viên | 60000 | 60000 | Đặc tả v2 | 1688s.vn | https://1688s.vn/pin-lipo-polymer-3-7v-400mah-300ma-160ma-co-mach-bao-ve | Shopee: https://shopee.vn/search?keyword=pin%20lipo%20603450%20mạch%20bảo%20vệ | Khoang pin trong CAD dày 7,5 mm. KHÔNG dùng pin 1500 mAh 7,8×34×52 (dày hơn khoang). [CẦN XÁC NHẬN: link hiện trỏ tới pin 400 mAh / 300 mA / 160 mA, không phải pin 603450 ~1200 mAh. Tìm link đúng và giá thật; giá 60.000 đ chỉ là giá Đặc tả v2.]
4 | K04 | Mạch sạc TP4056 USB-C 1 A có bảo vệ (DW01 + 8205A) | 1 | cái | 6270 | 6270 | Giá web | Thegioiic | https://www.thegioiic.com/tp4056-mach-sac-pin-usb-type-c-1a-co-bao-ve | HTPro: 11.000 đ, https://htpro.vn/pin-acquy-bien-ap-mach-sac/tp4056-mach-sac-pin-usb-type-c-1a-co-bao-ve.html | Mua dư 2. Phải thay điện trở PROG (dòng K04b). SL trong bảng là 1, hai con mua dự phòng chưa tính vào tổng. [LƯU Ý: TP4056 không có chia tải, vừa chạy vừa sạc thì chu kỳ sạc có thể không kết thúc đúng.]
5 | K04b | Điện trở 3,0 kΩ 1% SMD 0603 (thay R_PROG 1,2 kΩ trên module) | 2 | con | 500 | 1000 | Ước tính | Shopee | https://shopee.vn/search?keyword=điện%20trở%203k%200603 | Mua tại quầy | Đặt dòng sạc 400 mA (= 1200/3,0). Bản gốc 1,2 kΩ = 1 A, quá cao cho pin ~1200 mAh.
6 | K05 | Motor rung 1027 trần (Ø10 × 2,7 mm) | 2 | cái | 10000 | 20000 | Giá web | Điện tử Tuyết Nga | https://dientutuyetnga.com/products/1027-dong-co-rung-tron | IoTLabChannel 10.000 đ, https://iotlabchannel.com/san-pham/dong-co-rung-tron-1027/ | Dùng motor trần vì khe motor trong vỏ chỉ rộng 12 × 3 mm; module RLAB 21×30 mm (Đặc tả v2, K05) không vừa.
7 | K05b | Bộ lái motor tự hàn: 2 MOSFET AO3400 (hoặc transistor S8050) + 2 diode 1N5819 + 2×100 Ω + 2×100 kΩ | 1 | bộ | 8000 | 8000 | Ước tính | Shopee | https://shopee.vn/search?keyword=AO3400%20sot23 | Mua tại quầy | Cấp từ pin, PWM giới hạn điện áp trung bình ≤ 3,0 V.
8 | K06 | LED 5 mm đỏ siêu sáng ×2, LED 5 mm trắng ×1, điện trở 100 Ω ×2, 68 Ω ×1, transistor S8050 ×1 | 1 | bộ | 10000 | 10000 | Đặc tả v2 | Điện tử Tuyết Nga / Đức Huy | https://shopee.vn/search?keyword=led%205mm%20đỏ%20siêu%20sáng | — | Đèn Xin đường nháy 2 Hz trong 60 s.
9 | K07 | Băng dán phản quang (loại 3M hoặc tương đương) khổ 2,5 cm | 1 | cuộn | 25000 | 25000 | Đặc tả v2 | Shopee | https://shopee.vn/search?keyword=băng%20phản%20quang%203m%202.5cm | Cửa hàng phụ tùng xe máy | Dán 2 vòng trên thân gậy, cách đầu gậy ~30 cm.
10 | K08 | Công tắc gạt mini SS12D00 + 3 nút nhấn 6×6 mm | 1 | bộ | 15000 | 15000 | Đặc tả v2 | Shopee | https://shopee.vn/search?keyword=công%20tắc%20gạt%20ss12d00 | Mua tại quầy | Công tắc ở cạnh vỏ X = 25; 3 nút xếp ngang, cách 12,5 mm.
11 | K10 | Dây silicone 28 AWG, gen co, keo | 1 | bộ | 20000 | 20000 | Đặc tả v2 | Shopee | https://shopee.vn/search?keyword=dây%20silicone%2028awg | Mua tại quầy
B. CƠ KHÍ, VỎ
12 | K09a | Vỏ in 3D PETG: vỏ trên, đế yên, hàm kẹp, 3 nắp nút | 1 | bộ | 60000 | 60000 | Đặc tả v2 | Xưởng in 3D (TP.HCM) | https://shopee.vn/search?keyword=dịch%20vụ%20in%203d%20petg | Tự in | File STL trong thư mục NovaCane_Clip_V2.
13 | K09b | Chi tiết in TPU 95A: 4 lót kẹp L1–L4 (Ø15/18/21/25), nút cao su USB | 1 | bộ | 20000 | 20000 | Ước tính | Xưởng in 3D (TP.HCM) | https://shopee.vn/search?keyword=dịch%20vụ%20in%203d%20tpu | — | Chọn 1 lót theo đường kính gậy của người dùng; in đủ 4 để thử.
14 | K09c | Vít lục giác chìm DIN 912 M3×12 inox (hàm kẹp) | 2 | con | 1500 | 3000 | Ước tính | Shopee | https://shopee.vn/search?keyword=vít%20lục%20giác%20m3x12%20inox | Tiệm ốc vít (đường Nhật Tảo, Q.10) | Tại X 26, Y ±17,5.
15 | K09d | Ốc cấy nhiệt đồng M3 (lỗ Ø4,0, sâu 6,8 mm) | 2 | con | 1000 | 2000 | Ước tính | Shopee | https://shopee.vn/search?keyword=ốc%20cấy%20nhiệt%20m3 | —
16 | K09e | Vít lục giác chìm DIN 912 M2×16 inox (vỏ trên) | 2 | con | 1200 | 2400 | Ước tính | Shopee | https://shopee.vn/search?keyword=vít%20lục%20giác%20m2x16%20inox | Tiệm ốc vít | Tại X 72,5, Y ±16,7, bắt từ dưới đế yên.
17 | K09f | Ốc cấy nhiệt đồng M2 (lỗ Ø3,2, sâu 5 mm) | 2 | con | 1000 | 2000 | Ước tính | Shopee | https://shopee.vn/search?keyword=ốc%20cấy%20nhiệt%20m2 | —
 |  | TỔNG CỘNG |  |  |  | 390670
 |  | Trong đó: giá đã có trên web (Giá web) |  |  |  | 162270
 |  | Trong đó: giá Đặc tả v2 / ước tính / dự toán (cần xác nhận) |  |  |  | 228400

Sheet: Cửa hàng
Danh sách cửa hàng
Cửa hàng | Website | Địa chỉ / liên hệ (theo website) | Mua gì
Điện tử Đức Huy | https://dientuduchuy.com | 29a Bùi Xuân Phái, P. Tây Thạnh, Q. Tân Phú, TP.HCM | ESP32-S3 + OV5640 (K9_41), VL53L8CX, MH-CD42, ESP32-C3 SuperMini, LED
Điện tử Tuyết Nga | https://dientutuyetnga.com | 31/2 Nguyễn Văn Bảo, Gò Vấp (0936 832 336) · 52 Hữu Nghị, Thủ Đức (0708 787 899) | JSN-SR04T, ESP32-C3 SuperMini, motor 1027, pin Li-Po
Hshop | https://hshop.vn | Xem trang Liên hệ trên website | GY-521, MH-CD42
Điện tử RLAB | https://dienturlab.com | 0962 404 344 | Mạch động cơ rung 1027 có MOSFET
Thegioiic | https://www.thegioiic.com | Bán online, giao trong ngày | TP4056 USB-C có bảo vệ, linh kiện SMD
Điện tử Nguyễn Hiền | https://www.dientunguyenhien.vn | Xem website | JSN-SR04T (dự phòng)
Linh kiện Thành Công | https://linhkienthanhcong.com | Xem website | Pin Li-Po 4000 mAh có mạch bảo vệ
Caka | https://caka.vn | Xem website | GY-521 (dự phòng)
Pololu (Mỹ, nhập khẩu) | https://www.pololu.com/product/3419 | Đặt online, ship quốc tế | VL53L8CX carrier #3419 nếu Đức Huy hết hàng
Shopee | https://shopee.vn | — | Vít, ốc cấy, dây, gen co, jack JST, băng phản quang, dây đeo ngực
