gwangzeejay/NovaSight/hardware/NS-CHEST-MB/exports/NS-CHEST-MB-bom.csv

Refs | Value | Footprint | Qty | DNP
C1 | 1uF_10V | Capacitor_SMD:C_0402_1005Metric | 1
C2 | 100nF_10V | Capacitor_SMD:C_0402_1005Metric | 1
C3 | 10uF_10V | Capacitor_SMD:C_0603_1608Metric | 1
C4 | 100nF_10V | Capacitor_SMD:C_0402_1005Metric | 1
C5 | 22uF_10V | Capacitor_SMD:C_0805_2012Metric | 1
C6 | 100nF_10V | Capacitor_SMD:C_0402_1005Metric | 1
C7 | 100nF_10V | Capacitor_SMD:C_0402_1005Metric | 1
C8 | 1uF_10V | Capacitor_SMD:C_0402_1005Metric | 1
C9 | 10uF_10V | Capacitor_SMD:C_0603_1608Metric | 1
C10 | 100nF_10V | Capacitor_SMD:C_0402_1005Metric | 1
C11 | 22uF_10V | Capacitor_SMD:C_0805_2012Metric | 1
C12 | 22uF_10V | Capacitor_SMD:C_0805_2012Metric | 1
C13 | 22uF_10V | Capacitor_SMD:C_0805_2012Metric | 1
C14 | 22uF_10V | Capacitor_SMD:C_0805_2012Metric | 1
C15 | 100nF_10V | Capacitor_SMD:C_0402_1005Metric | 1
C16 | 10uF_10V | Capacitor_SMD:C_0603_1608Metric | 1
C17 | 100nF_10V | Capacitor_SMD:C_0402_1005Metric | 1
C18 | 22uF_10V | Capacitor_SMD:C_0805_2012Metric | 1
C19 | 10uF_10V | Capacitor_SMD:C_0603_1608Metric | 1
C20 | 100nF_10V | Capacitor_SMD:C_0402_1005Metric | 1
C21 | 22pF_50V | Capacitor_SMD:C_0402_1005Metric | 1
C22 | 1uF_10V | Capacitor_SMD:C_0402_1005Metric | 1
C23 | 1uF_10V | Capacitor_SMD:C_0402_1005Metric | 1
C24 | 100nF_10V | Capacitor_SMD:C_0402_1005Metric | 1
C25 | 1uF_10V | Capacitor_SMD:C_0402_1005Metric | 1
C26 | 1uF_10V | Capacitor_SMD:C_0402_1005Metric | 1
C27 | 100nF_10V | Capacitor_SMD:C_0402_1005Metric | 1
C28 | 100nF_10V | Capacitor_SMD:C_0402_1005Metric | 1
C29 | 1uF_10V | Capacitor_SMD:C_0402_1005Metric | 1
C30 | 1uF_10V | Capacitor_SMD:C_0402_1005Metric | 1
C31 | 1uF_10V | Capacitor_SMD:C_0402_1005Metric | 1
C32 | 10uF_10V | Capacitor_SMD:C_0603_1608Metric | 1
C33 | 100nF_10V | Capacitor_SMD:C_0402_1005Metric | 1
C34 | 10uF_10V | Capacitor_SMD:C_0603_1608Metric | 1
C35 | 100nF_10V | Capacitor_SMD:C_0402_1005Metric | 1
C36 | 100nF_10V | Capacitor_SMD:C_0402_1005Metric | 1
C37 | 10nF_10V | Capacitor_SMD:C_0402_1005Metric | 1
C38 | 100nF_10V | Capacitor_SMD:C_0402_1005Metric | 1
C39 | 2.2nF_50V | Capacitor_SMD:C_0402_1005Metric | 1
C40 | 100nF_10V | Capacitor_SMD:C_0402_1005Metric | 1
C41 | 100nF_10V | Capacitor_SMD:C_0402_1005Metric | 1
C90 | 100nF_10V | Capacitor_SMD:C_0402_1005Metric | 1
D1 | STATUS_WHITE | LED_SMD:LED_0603_1608Metric | 1
D2 | B5819W | Diode_SMD:D_SOD-123 | 1
D3 | B5819W | Diode_SMD:D_SOD-123 | 1
D4 | SOC_GREEN | LED_SMD:LED_0603_1608Metric | 1
D5 | SOC_GREEN | LED_SMD:LED_0603_1608Metric | 1
D6 | SOC_GREEN | LED_SMD:LED_0603_1608Metric | 1
D7 | SOC_GREEN | LED_SMD:LED_0603_1608Metric | 1
F1 | PTC_HOLD_0.5A | Fuse:Fuse_1206_3216Metric | 1
J1 | USB-C | Connector_USB:USB_C_Receptacle_GCT_USB4105-xx-A_16P_TopMnt_Horizontal | 1
J2 | OV5640_FPC_VERIFY_CONTACT | Connector_FFC-FPC:Hirose_FH12-24S-0.5SH_1x24-1MP_P0.50mm_Horizontal | 1
J3 | TOF_HARNESS_VERIFY | Connector_JST:JST_SH_SM08B-SRSS-TB_1x08-1MP_P1.00mm_Horizontal | 1
J4 | BATTERY_PROTECTED_1S | Connector_JST:JST_PH_B2B-PH-K_1x02_P2.00mm_Vertical | 1
J5 | JSN_R_VERIFY | Connector_JST:JST_PH_B4B-PH-K_1x04_P2.00mm_Vertical | 1
J6 | JSN_L_VERIFY | Connector_JST:JST_PH_B4B-PH-K_1x04_P2.00mm_Vertical | 1
J7 | MOTOR_R | Connector_JST:JST_PH_B2B-PH-K_1x02_P2.00mm_Vertical | 1
J8 | MOTOR_L | Connector_JST:JST_PH_B2B-PH-K_1x02_P2.00mm_Vertical | 1
J9 | GY521_OPTION_DNP | Connector_JST:JST_SH_SM06B-SRSS-TB_1x06-1MP_P1.00mm_Horizontal | 1 | DNP
L1 | XAL7020-102_1uH_VERIFY | Inductor_SMD:L_Coilcraft_XAL7020-102 | 1
L2 | 2.2uH_Isat1.5A | Inductor_SMD:L_Bourns-SRN4018 | 1
Q1 | AO3401A | Package_TO_SOT_SMD:SOT-23 | 1
Q2 | AO3400A | Package_TO_SOT_SMD:SOT-23 | 1
Q3 | 2N7002 | Package_TO_SOT_SMD:SOT-23 | 1
Q4 | AO3400A | Package_TO_SOT_SMD:SOT-23 | 1
Q5 | AO3400A | Package_TO_SOT_SMD:SOT-23 | 1
R1 | 5.1k_1% | Resistor_SMD:R_0402_1005Metric | 1
R2 | 5.1k_1% | Resistor_SMD:R_0402_1005Metric | 1
R3 | 0R | Resistor_SMD:R_0402_1005Metric | 1
R4 | 0R | Resistor_SMD:R_0402_1005Metric | 1
R5 | 68k_1% | Resistor_SMD:R_0402_1005Metric | 1
R6 | 100k_1% | Resistor_SMD:R_0402_1005Metric | 1
R7 | 10k | Resistor_SMD:R_0402_1005Metric | 1
R8 | 10k | Resistor_SMD:R_0402_1005Metric | 1
R9 | 10k | Resistor_SMD:R_0402_1005Metric | 1
R10 | 470k_1% | Resistor_SMD:R_0402_1005Metric | 1
R11 | 470k_1% | Resistor_SMD:R_0402_1005Metric | 1
R12 | 1k | Resistor_SMD:R_0402_1005Metric | 1
R13 | 100k | Resistor_SMD:R_0402_1005Metric | 1
R14 | 10k | Resistor_SMD:R_0402_1005Metric | 1
R15 | 10k | Resistor_SMD:R_0402_1005Metric | 1
R16 | 100k | Resistor_SMD:R_0402_1005Metric | 1
R17 | 470k | Resistor_SMD:R_0402_1005Metric | 1
R18 | 100k | Resistor_SMD:R_0402_1005Metric | 1
R19 | 680k_1% | Resistor_SMD:R_0402_1005Metric | 1
R20 | 150k_1% | Resistor_SMD:R_0402_1005Metric | 1
R21 | 1k | Resistor_SMD:R_0402_1005Metric | 1
R22 | 1k | Resistor_SMD:R_0402_1005Metric | 1
R23 | 1k | Resistor_SMD:R_0402_1005Metric | 1
R24 | 1k | Resistor_SMD:R_0402_1005Metric | 1
R25 | 4.7k | Resistor_SMD:R_0402_1005Metric | 1
R26 | 4.7k | Resistor_SMD:R_0402_1005Metric | 1
R27 | 10k | Resistor_SMD:R_0402_1005Metric | 1
R28 | 10k | Resistor_SMD:R_0402_1005Metric | 1
R29 | 22R | Resistor_SMD:R_0402_1005Metric | 1
R30 | 0R | Resistor_SMD:R_0402_1005Metric | 1
R31 | 0R_OPTION_5V | Resistor_SMD:R_0402_1005Metric | 1 | DNP
R32 | 0R | Resistor_SMD:R_0402_1005Metric | 1
R33 | 47k | Resistor_SMD:R_0402_1005Metric | 1
R34 | 47k | Resistor_SMD:R_0402_1005Metric | 1 | DNP
R35 | 2.2k | Resistor_SMD:R_0402_1005Metric | 1
R36 | 2.2k | Resistor_SMD:R_0402_1005Metric | 1
R37 | 100R | Resistor_SMD:R_0402_1005Metric | 1
R38 | 10k_1% | Resistor_SMD:R_0402_1005Metric | 1
R39 | 15k_1% | Resistor_SMD:R_0402_1005Metric | 1
R40 | 100R | Resistor_SMD:R_0402_1005Metric | 1
R41 | 10k_1% | Resistor_SMD:R_0402_1005Metric | 1
R42 | 15k_1% | Resistor_SMD:R_0402_1005Metric | 1
R43 | 100R | Resistor_SMD:R_0402_1005Metric | 1
R44 | 100k | Resistor_SMD:R_0402_1005Metric | 1
R45 | 100R | Resistor_SMD:R_0402_1005Metric | 1
R46 | 100k | Resistor_SMD:R_0402_1005Metric | 1
SW1 | POWER_ON | Button_Switch_SMD:SW_SPDT_Shouhan_MSK12C02 | 1
SW2 | MODE_EVQPUJ02K_SIDE | Button_Switch_SMD:Panasonic_EVQPUJ_EVQPUA | 1
SW3 | BOOT | Button_Switch_SMD:SW_SPST_TL3342 | 1
SW4 | IP_KEY_TEST | Button_Switch_SMD:SW_SPST_TL3342 | 1 | DNP
SW5 | RESET | Button_Switch_SMD:SW_SPST_TL3342 | 1
TP1 | VBUS | TestPoint:TestPoint_Pad_D1.0mm | 1
TP2 | VBAT | TestPoint:TestPoint_Pad_D1.0mm | 1
TP3 | 5V_SYS | TestPoint:TestPoint_Pad_D1.0mm | 1
TP4 | 5V_SW | TestPoint:TestPoint_Pad_D1.0mm | 1
TP5 | 3V3 | TestPoint:TestPoint_Pad_D1.0mm | 1
TP6 | 2V8 | TestPoint:TestPoint_Pad_D1.0mm | 1
TP7 | 1V5 | TestPoint:TestPoint_Pad_D1.0mm | 1
TP8 | GND | TestPoint:TestPoint_Pad_D1.0mm | 1
TP9 | GND | TestPoint:TestPoint_Pad_D1.0mm | 1
TP10 | GND | TestPoint:TestPoint_Pad_D1.0mm | 1
TP11 | MCU_EN | TestPoint:TestPoint_Pad_D1.0mm | 1
TP12 | BOOT | TestPoint:TestPoint_Pad_D1.0mm | 1
TP13 | UART_TX | TestPoint:TestPoint_Pad_D1.0mm | 1
TP14 | VBUS_DET | TestPoint:TestPoint_Pad_D1.0mm | 1
TP15 | I2C_SDA | TestPoint:TestPoint_Pad_D1.0mm | 1
TP16 | I2C_SCL | TestPoint:TestPoint_Pad_D1.0mm | 1
U1 | USBLC6-2SC6 | Package_TO_SOT_SMD:SOT-23-6 | 1
U2 | IP5306 | Package_SO:HSOP-8-1EP_3.9x4.9mm_P1.27mm_EP2.41x3.1mm | 1
U3 | SY8088IAAC | Package_TO_SOT_SMD:SOT-23-5 | 1
U4 | ESP32-S3-WROOM-1-N16R8 | RF_Module:ESP32-S3-WROOM-1 | 1
U5 | 74AHCT1G125 | Package_TO_SOT_SMD:SOT-23-5 | 1
U6 | 74AHCT1G125 | Package_TO_SOT_SMD:SOT-23-5 | 1
U7 | ME6211C28M5G-N | Package_TO_SOT_SMD:SOT-23-5 | 1
U8 | ME6211C15M5G-N | Package_TO_SOT_SMD:SOT-23-5 | 1
U9 | MPU-6050 | Sensor_Motion:InvenSense_QFN-24_4x4mm_P0.5mm | 1
U10 | SN74LVC1G125DBVR_XCLK_2V8 | Package_TO_SOT_SMD:SOT-23-5 | 1
