gwangzeejay/NovaSight/hardware/NS-CLIP-MB/exports/NS-CLIP-MB-bom.csv

Refs | Value | Footprint | Qty | DNP
C1 | 100nF_10V | Capacitor_SMD:C_0402_1005Metric | 1
C2 | 100nF_10V | Capacitor_SMD:C_0402_1005Metric | 1
C3 | 100nF_10V | Capacitor_SMD:C_0402_1005Metric | 1
C4 | 22uF_10V | Capacitor_SMD:C_0805_2012Metric | 1
C5 | 10uF_10V | Capacitor_SMD:C_0603_1608Metric | 1
C6 | 100nF_10V | Capacitor_SMD:C_0402_1005Metric | 1
C7 | 10uF_10V | Capacitor_SMD:C_0603_1608Metric | 1
C8 | 10uF_10V | Capacitor_SMD:C_0603_1608Metric | 1
C9 | 10uF_10V | Capacitor_SMD:C_0603_1608Metric | 1
C10 | 100nF_10V | Capacitor_SMD:C_0402_1005Metric | 1
C11 | 22uF_10V | Capacitor_SMD:C_0805_2012Metric | 1
C12 | 1uF_10V | Capacitor_SMD:C_0402_1005Metric | 1
C13 | 100nF_10V | Capacitor_SMD:C_0402_1005Metric | 1
C14 | 100nF_10V | Capacitor_SMD:C_0402_1005Metric | 1
C15 | 100nF_10V | Capacitor_SMD:C_0402_1005Metric | 1
C16 | 10uF_10V | Capacitor_SMD:C_0603_1608Metric | 1
C17 | 100nF_10V | Capacitor_SMD:C_0402_1005Metric | 1
C18 | 100nF_10V | Capacitor_SMD:C_0402_1005Metric | 1
C19 | 100nF_10V | Capacitor_SMD:C_0402_1005Metric | 1
C20 | 10nF_10V | Capacitor_SMD:C_0402_1005Metric | 1
C21 | 100nF_10V | Capacitor_SMD:C_0402_1005Metric | 1
C22 | 2.2nF_50V | Capacitor_SMD:C_0402_1005Metric | 1
D1 | BEACON_RED | LED_THT:LED_D5.0mm | 1
D2 | BEACON_RED | LED_THT:LED_D5.0mm | 1
D3 | BEACON_WHITE | LED_THT:LED_D5.0mm | 1
D4 | SS14 | Diode_SMD:D_SMA | 1
D5 | B5819W | Diode_SMD:D_SOD-123 | 1
D6 | B5819W | Diode_SMD:D_SOD-123 | 1
D7 | CHARGE_RED | LED_SMD:LED_0603_1608Metric | 1
D8 | FULL_GREEN | LED_SMD:LED_0603_1608Metric | 1
D9 | STATUS_GREEN | LED_SMD:LED_0603_1608Metric | 1
J1 | USB-C_USB4105 | Connector_USB:USB_C_Receptacle_GCT_USB4105-xx-A_16P_TopMnt_Horizontal | 1
J2 | BATTERY_1S_WIRE | Connector_Wire:SolderWire-0.5sqmm_1x02_P4.6mm_D0.9mm_OD2.1mm | 1
J3 | MOTOR_L_WIRE | Connector_Wire:SolderWire-0.5sqmm_1x02_P4.6mm_D0.9mm_OD2.1mm | 1
J4 | MOTOR_R_WIRE | Connector_Wire:SolderWire-0.5sqmm_1x02_P4.6mm_D0.9mm_OD2.1mm | 1
J5 | GY521_OPTION_DNP | Connector_JST:JST_SH_SM06B-SRSS-TB_1x06-1MP_P1.00mm_Horizontal | 1 | DNP
Q1 | FS8205A_Fortune | Package_SO:TSSOP-8_3x3mm_P0.65mm | 1
Q2 | AO3401A | Package_TO_SOT_SMD:SOT-23 | 1
Q3 | AO3400A | Package_TO_SOT_SMD:SOT-23 | 1
Q4 | AO3400A | Package_TO_SOT_SMD:SOT-23 | 1
Q5 | AO3400A | Package_TO_SOT_SMD:SOT-23 | 1
R1 | 100R | Resistor_SMD:R_0402_1005Metric | 1
R2 | 100k | Resistor_SMD:R_0402_1005Metric | 1
R3 | 100R | Resistor_SMD:R_0402_1005Metric | 1
R4 | 100k | Resistor_SMD:R_0402_1005Metric | 1
R5 | 100R | Resistor_SMD:R_0402_1005Metric | 1
R6 | 100k | Resistor_SMD:R_0402_1005Metric | 1
R7 | 100R | Resistor_SMD:R_0603_1608Metric | 1
R8 | 100R | Resistor_SMD:R_0603_1608Metric | 1
R9 | 68R | Resistor_SMD:R_0603_1608Metric | 1
R10 | 5.1k_1% | Resistor_SMD:R_0402_1005Metric | 1
R11 | 5.1k_1% | Resistor_SMD:R_0402_1005Metric | 1
R12 | 0R | Resistor_SMD:R_0402_1005Metric | 1
R13 | 0R | Resistor_SMD:R_0402_1005Metric | 1
R14 | 68k_1% | Resistor_SMD:R_0402_1005Metric | 1
R15 | 100k_1% | Resistor_SMD:R_0402_1005Metric | 1
R16 | 3.0k_1% | Resistor_SMD:R_0402_1005Metric | 1
R17 | 100R | Resistor_SMD:R_0402_1005Metric | 1
R18 | 1k | Resistor_SMD:R_0402_1005Metric | 1
R19 | 100k | Resistor_SMD:R_0402_1005Metric | 1
R20 | 100k | Resistor_SMD:R_0402_1005Metric | 1
R21 | 10k | Resistor_SMD:R_0402_1005Metric | 1
R22 | 10k | Resistor_SMD:R_0402_1005Metric | 1
R23 | 10k | Resistor_SMD:R_0402_1005Metric | 1
R24 | 10k | Resistor_SMD:R_0402_1005Metric | 1
R25 | 10k | Resistor_SMD:R_0402_1005Metric | 1
R26 | 10k | Resistor_SMD:R_0402_1005Metric | 1
R27 | 470k_1% | Resistor_SMD:R_0402_1005Metric | 1
R28 | 470k_1% | Resistor_SMD:R_0402_1005Metric | 1
R29 | 1k | Resistor_SMD:R_0402_1005Metric | 1
R30 | 1k | Resistor_SMD:R_0402_1005Metric | 1
R31 | 1k | Resistor_SMD:R_0402_1005Metric | 1
R32 | 4.7k | Resistor_SMD:R_0402_1005Metric | 1
R33 | 4.7k | Resistor_SMD:R_0402_1005Metric | 1
SW1 | POWER_ON | Button_Switch_SMD:SW_SPDT_Shouhan_MSK12C02 | 1
SW2 | MODE | Button_Switch_SMD:SW_SPST_EVQP2_ShortPushTravel_H2.5mm | 1
SW3 | ROUTE | Button_Switch_SMD:SW_SPST_EVQP2_ShortPushTravel_H2.5mm | 1
SW4 | SOS | Button_Switch_SMD:SW_SPST_EVQP2_ShortPushTravel_H2.5mm | 1
TP1 | VBUS | TestPoint:TestPoint_Pad_D1.0mm | 1
TP2 | BAT_PLUS | TestPoint:TestPoint_Pad_D1.0mm | 1
TP3 | B_MINUS | TestPoint:TestPoint_Pad_D1.0mm | 1
TP4 | VSYS | TestPoint:TestPoint_Pad_D1.0mm | 1
TP5 | 3V3 | TestPoint:TestPoint_Pad_D1.0mm | 1
TP6 | GND | TestPoint:TestPoint_Pad_D1.0mm | 1
TP7 | GND | TestPoint:TestPoint_Pad_D1.0mm | 1
TP8 | MCU_EN | TestPoint:TestPoint_Pad_D1.0mm | 1
TP9 | BOOT | TestPoint:TestPoint_Pad_D1.0mm | 1
TP10 | I2C_SDA | TestPoint:TestPoint_Pad_D1.0mm | 1
TP11 | I2C_SCL | TestPoint:TestPoint_Pad_D1.0mm | 1
TP12 | VBUS_DET | TestPoint:TestPoint_Pad_D1.0mm | 1
TP13 | BTN_SOS | TestPoint:TestPoint_Pad_D1.0mm | 1
U1 | ESP32-C3-MINI-1-N4X | Espressif:ESP32-C3-MINI-1 | 1
U2 | USBLC6-2SC6 | Package_TO_SOT_SMD:SOT-23-6 | 1
U3 | TP4056-42-ESOP8 | Package_SO:HSOP-8-1EP_3.9x4.9mm_P1.27mm_EP2.41x3.1mm | 1
U4 | AP2112K-3.3TRG1 | Package_TO_SOT_SMD:SOT-23-5 | 1
U5 | DW01A | Package_TO_SOT_SMD:SOT-23-6 | 1
U6 | MPU-6050 | Sensor_Motion:InvenSense_QFN-24_4x4mm_P0.5mm | 1
