gwangzeejay/NovaSight/output/bom/p1/NS-CLIP-MB-mua-ngoai.csv

Refs | Qty | Manufacturer | MPN | LCSC | Assembly | Status | Note
D1,D2 | 2 | Everlight | 333-2SURD/S530-A3 | C87271 | Tự hàn/mua rời | ok | LED 5 mm xuyên lỗ, tự hàn
D3 | 1 |  | LED trắng 5 mm |  | Tự hàn/mua rời | đã duyệt: mua ngoài | Mua rời, không tìm được mã LCSC phù hợp
