gwangzeejay/NovaSight/hardware/NS-CHEST-MB/exports/NS-CHEST-MB_assembly.step

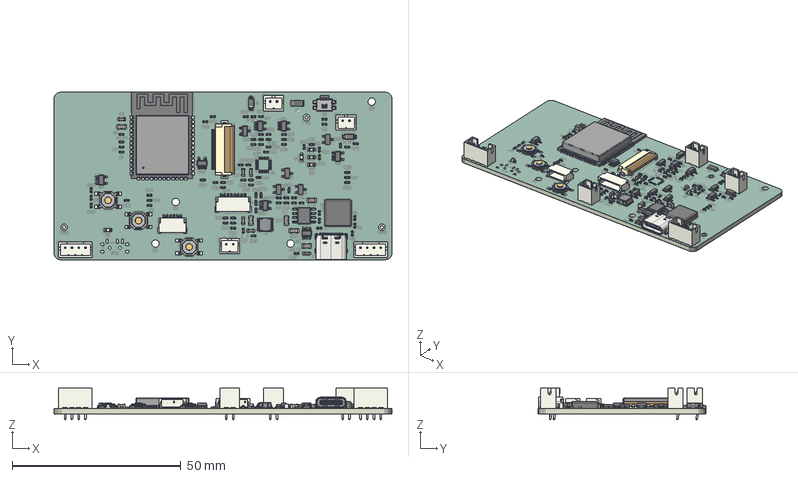
[picture p116: CAD file, 2026-11-12]
hardware/NS-CHEST-MB/exports/NS-CHEST-MB_assembly.step
100.0 x 49.6 x 9.40 mm
JST_B2B_PH_K x 3
R_0402_1005Metric x 46
SOT-23 x 5
C_0402_1005Metric x 30
SOT-23-5 x 6
JST_SH_SM06B-SRSS-TB_1x06-1MP_P1.00mm_Horizontal
D_SOD-123 x 2
C_0805_2012Metric x 6
C_0603_1608Metric x 6
JST_B4B_PH_K x 2
Fuse_1206_3216Metric
SW_SPST_TL3342 x 3
L_Coilcraft_XAL7020-102
USB_C_Receptacle_16P_TopMnt_Horizontal_GCT_USB4105-xx-A
L_Bourns-SRN4018
JST_SH_SM08B-SRSS-TB_1x08-1MP_P1.00mm_Horizontal
Panasonic_EVQPUJ_EVQPUA
SOT-23-6
LED_0603_1608Metric x 5
ESP32-S3-WROOM-1
lock
pins
HSOP-8-1EP_3.9x4.9mm_P1.27mm_EP2.41x3.1mm
NS-CHEST-MB_copper
NS-CHEST-MB_pad
NS-CHEST-MB_via
NS-CHEST-MB_silkscreen x 2
NS-CHEST-MB_soldermask x 2
NS-CHEST-MB_PCB
