gwangzeejay/NovaSight/hardware/NS-CLIP-MB/exports/NS-CLIP-MB_assembly.step

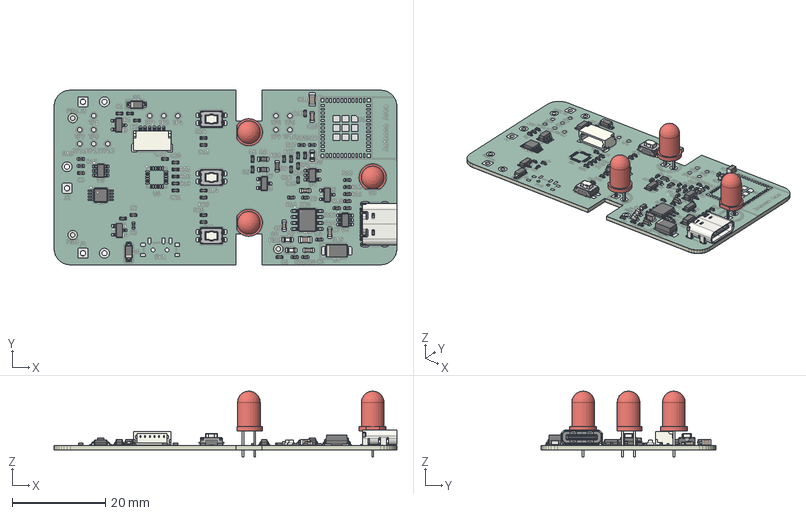
[picture p117: CAD file, 2026-11-12]
hardware/NS-CLIP-MB/exports/NS-CLIP-MB_assembly.step
73.4 x 37.4 x 14.1 mm
C_0603_1608Metric x 5
R_0402_1005Metric x 30
C_0402_1005Metric x 15
LED_D5.0mm x 3
R_0603_1608Metric x 3
C_0805_2012Metric x 2
USB_C_Receptacle_16P_TopMnt_Horizontal_GCT_USB4105-xx-A
SW_SPST_EVQP2_ShortPushTravel_H2.5mm x 3
SOT-23 x 4
TSSOP-8_3x3mm_P0.65mm
LED_0603_1608Metric x 3
D_SOD-123 x 2
D_SMA
SOT-23-5
HSOP-8-1EP_3.9x4.9mm_P1.27mm_EP2.41x3.1mm
JST_SH_SM06B-SRSS-TB_1x06-1MP_P1.00mm_Horizontal
SOT-23-6 x 2
NS-CLIP-MB_copper
NS-CLIP-MB_pad
NS-CLIP-MB_via
NS-CLIP-MB_silkscreen x 2
NS-CLIP-MB_soldermask x 2
NS-CLIP-MB_PCB
