gwangzeejay/NovaSight/output/pcb-review/NS-CHEST-MB/NS-CHEST-MB-assembly.step

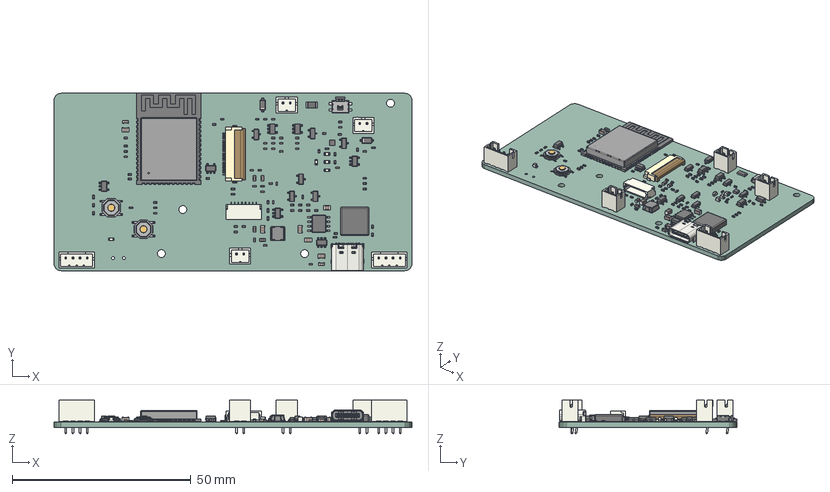
[picture p118: CAD file, 2026-11-12]
output/pcb-review/NS-CHEST-MB/NS-CHEST-MB-assembly.step
100.0 x 49.6 x 9.40 mm
JST_B2B_PH_K x 3
R_0402_1005Metric x 44
SOT-23 x 6
C_0402_1005Metric x 32
SOT-23-5 x 6
D_SOD-123 x 2
C_0805_2012Metric x 6
C_0603_1608Metric x 6
JST_B4B_PH_K x 2
Fuse_1206_3216Metric
L_Coilcraft_XAL7020-102
USB_C_Receptacle_16P_TopMnt_Horizontal_GCT_USB4105-xx-A
SW_SPST_TL3342 x 2
WSON6_15x15mm_Pitch05mm
L_Bourns-SRN4018
JST_SH_SM08B-SRSS-TB_1x08-1MP_P1.00mm_Horizontal
Panasonic_EVQPUJ_EVQPUA
SOT-23-6
LED_0603_1608Metric x 5
ESP32-S3-WROOM-1
lock
pins
HSOP-8-1EP_3.9x4.9mm_P1.27mm_EP2.41x3.1mm
NS-CHEST-MB_PCB
