gwangzeejay/NovaSight/output/pcb-review/NS-CLIP-MB/NS-CLIP-MB-mechanical-review.dxf

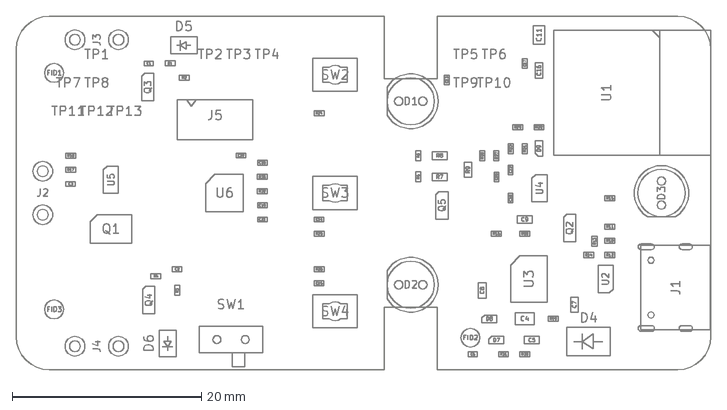
[picture p120: CAD file, 2026-11-12]
output/pcb-review/NS-CLIP-MB/NS-CLIP-MB-mechanical-review.dxf
73.4 x 37.4 mm
