gwangzeejay/NovaSight/output/pcb-review/NS-CHEST-MB/NS-CHEST-MB-mechanical-review.dxf

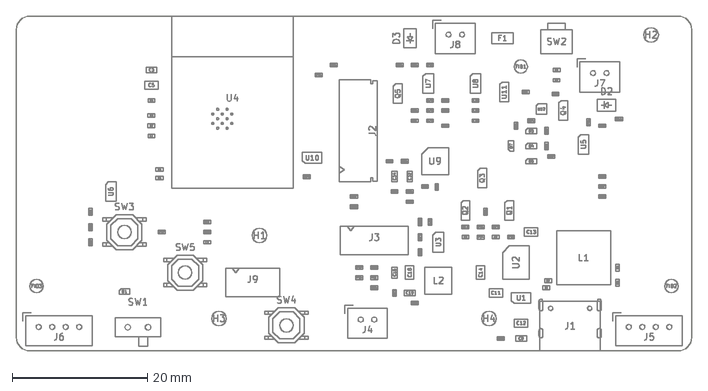
[picture p121: CAD file, 2026-11-12]
output/pcb-review/NS-CHEST-MB/NS-CHEST-MB-mechanical-review.dxf
100.0 x 49.6 mm
