gwangzeejay/NovaSight/output/pdf/NS-CHEST-MB-RevA-schematic.pdf

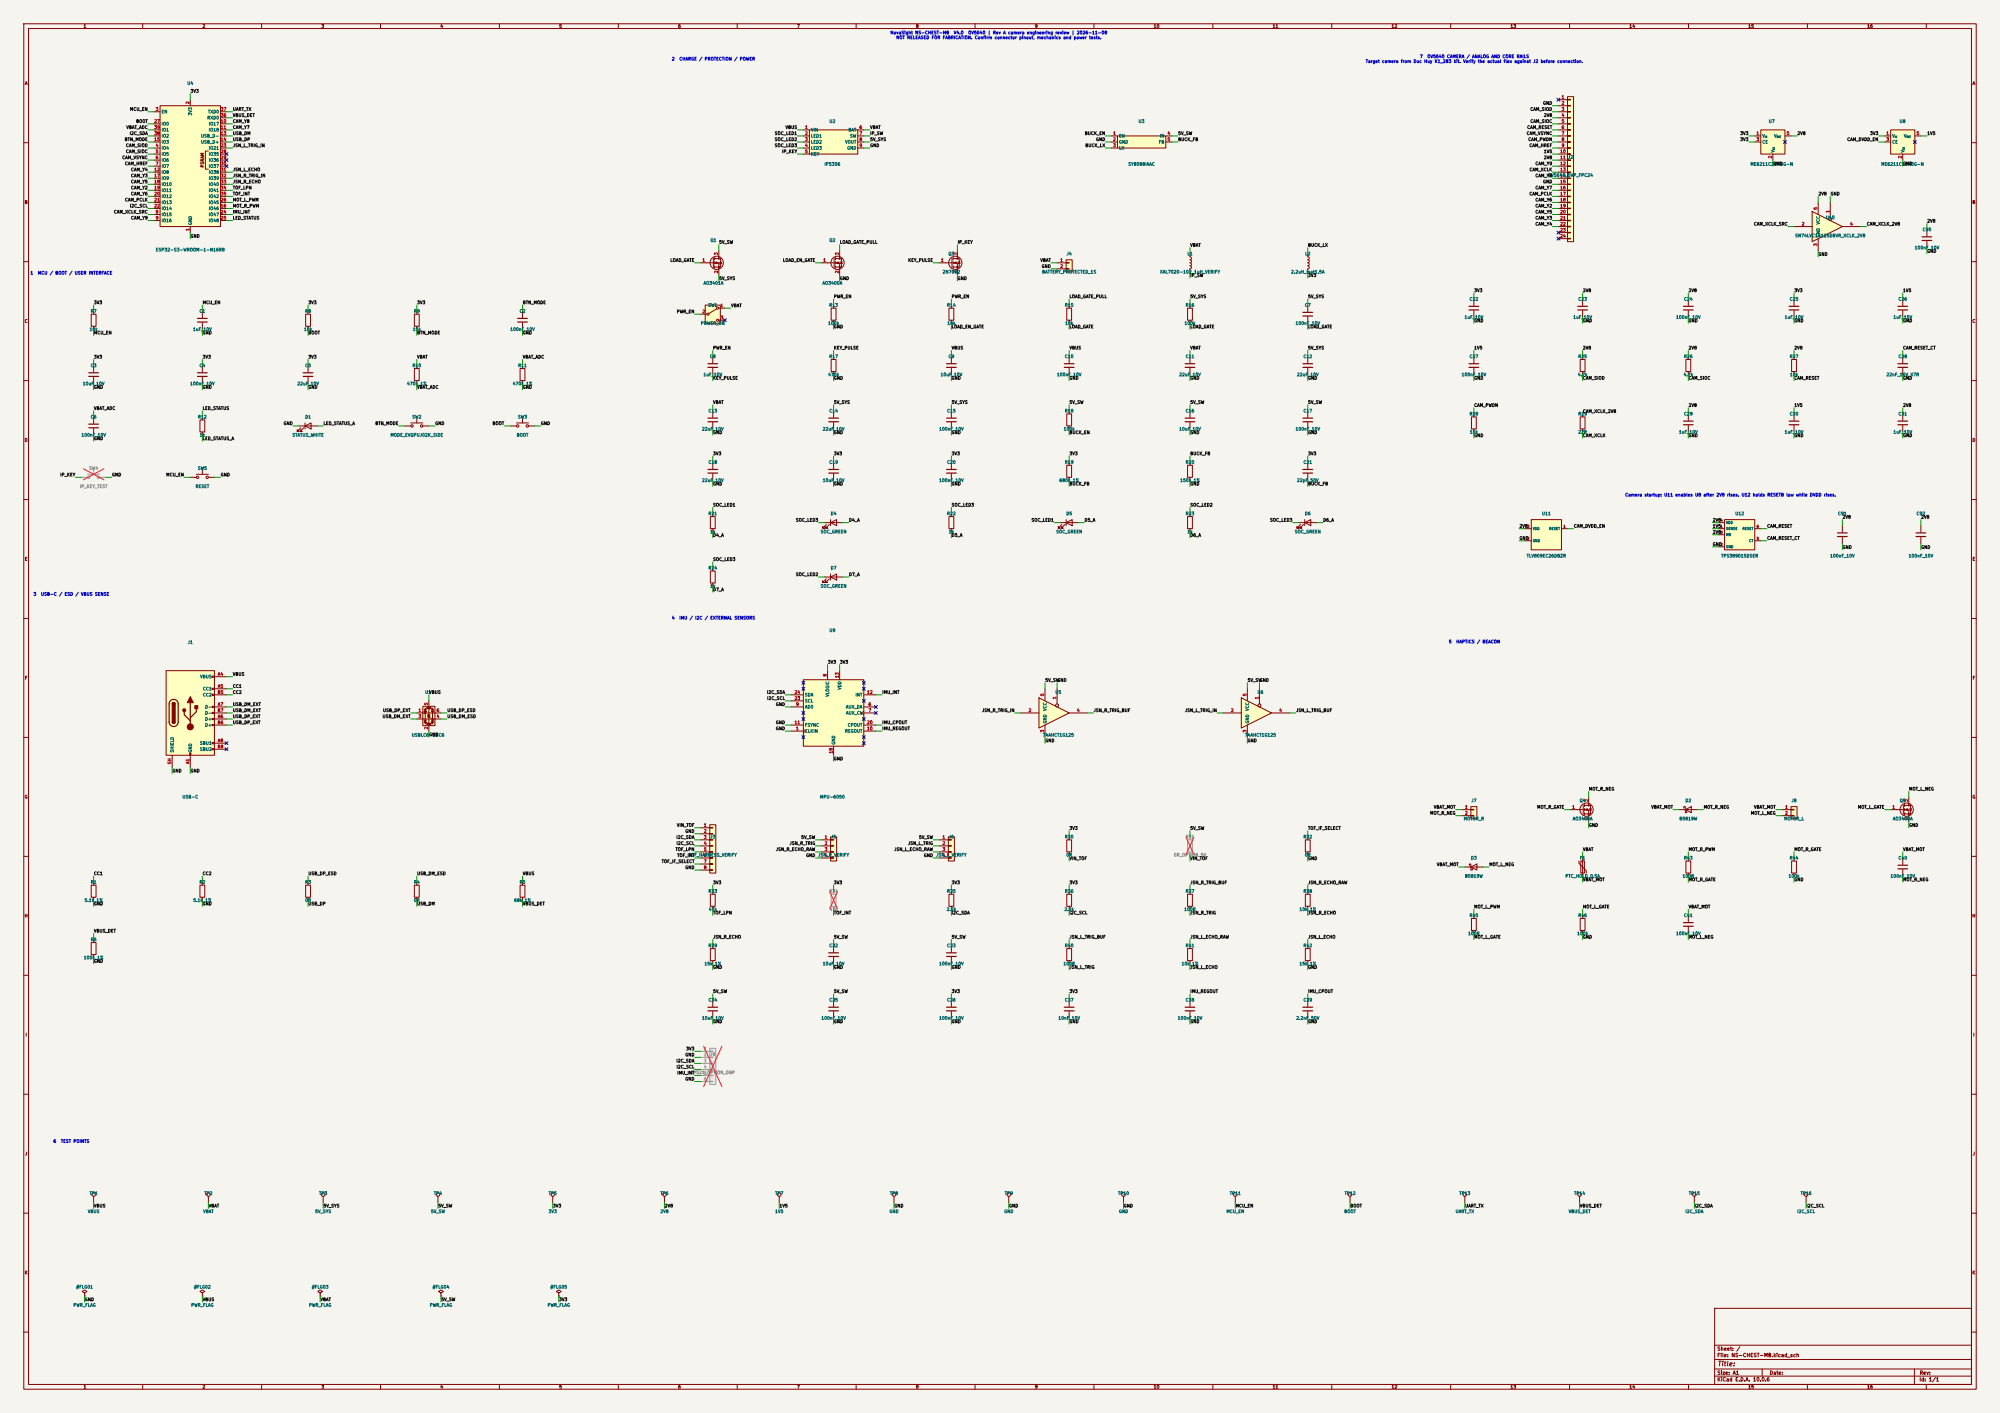
[picture p122: page 1]

NovaSight NS-CHEST-MB V4.0 OV5640 | Rev A camera engineering review | 2026-11-08 NOT RELEASED FOR FABRICATION. Confirm connector pinout, mechanics and power tests.

7 OV5640 CAMERA / ANALOG AND CORE RAILS

Target camera from Duc Huy K1_283 kit. Verify the actual flex against J2 before connection.

1 MCU / BOOT / USER INTERFACE

Camera startup: U11 enables U8 after 2V8 rises. U12 holds RESETB low while DVDD rises.

3 USB-C / ESD / VBUS SENSE

Sheet: /
File: NS-CHEST-MB.kicad_sch
Title:

Size: A1 | Rev:
KiCad E.D.A. 10.0.6 | Id: 1/1
