gwangzeejay/NovaSight/output/pdf/NS-CLIP-MB-RevA-schematic.pdf

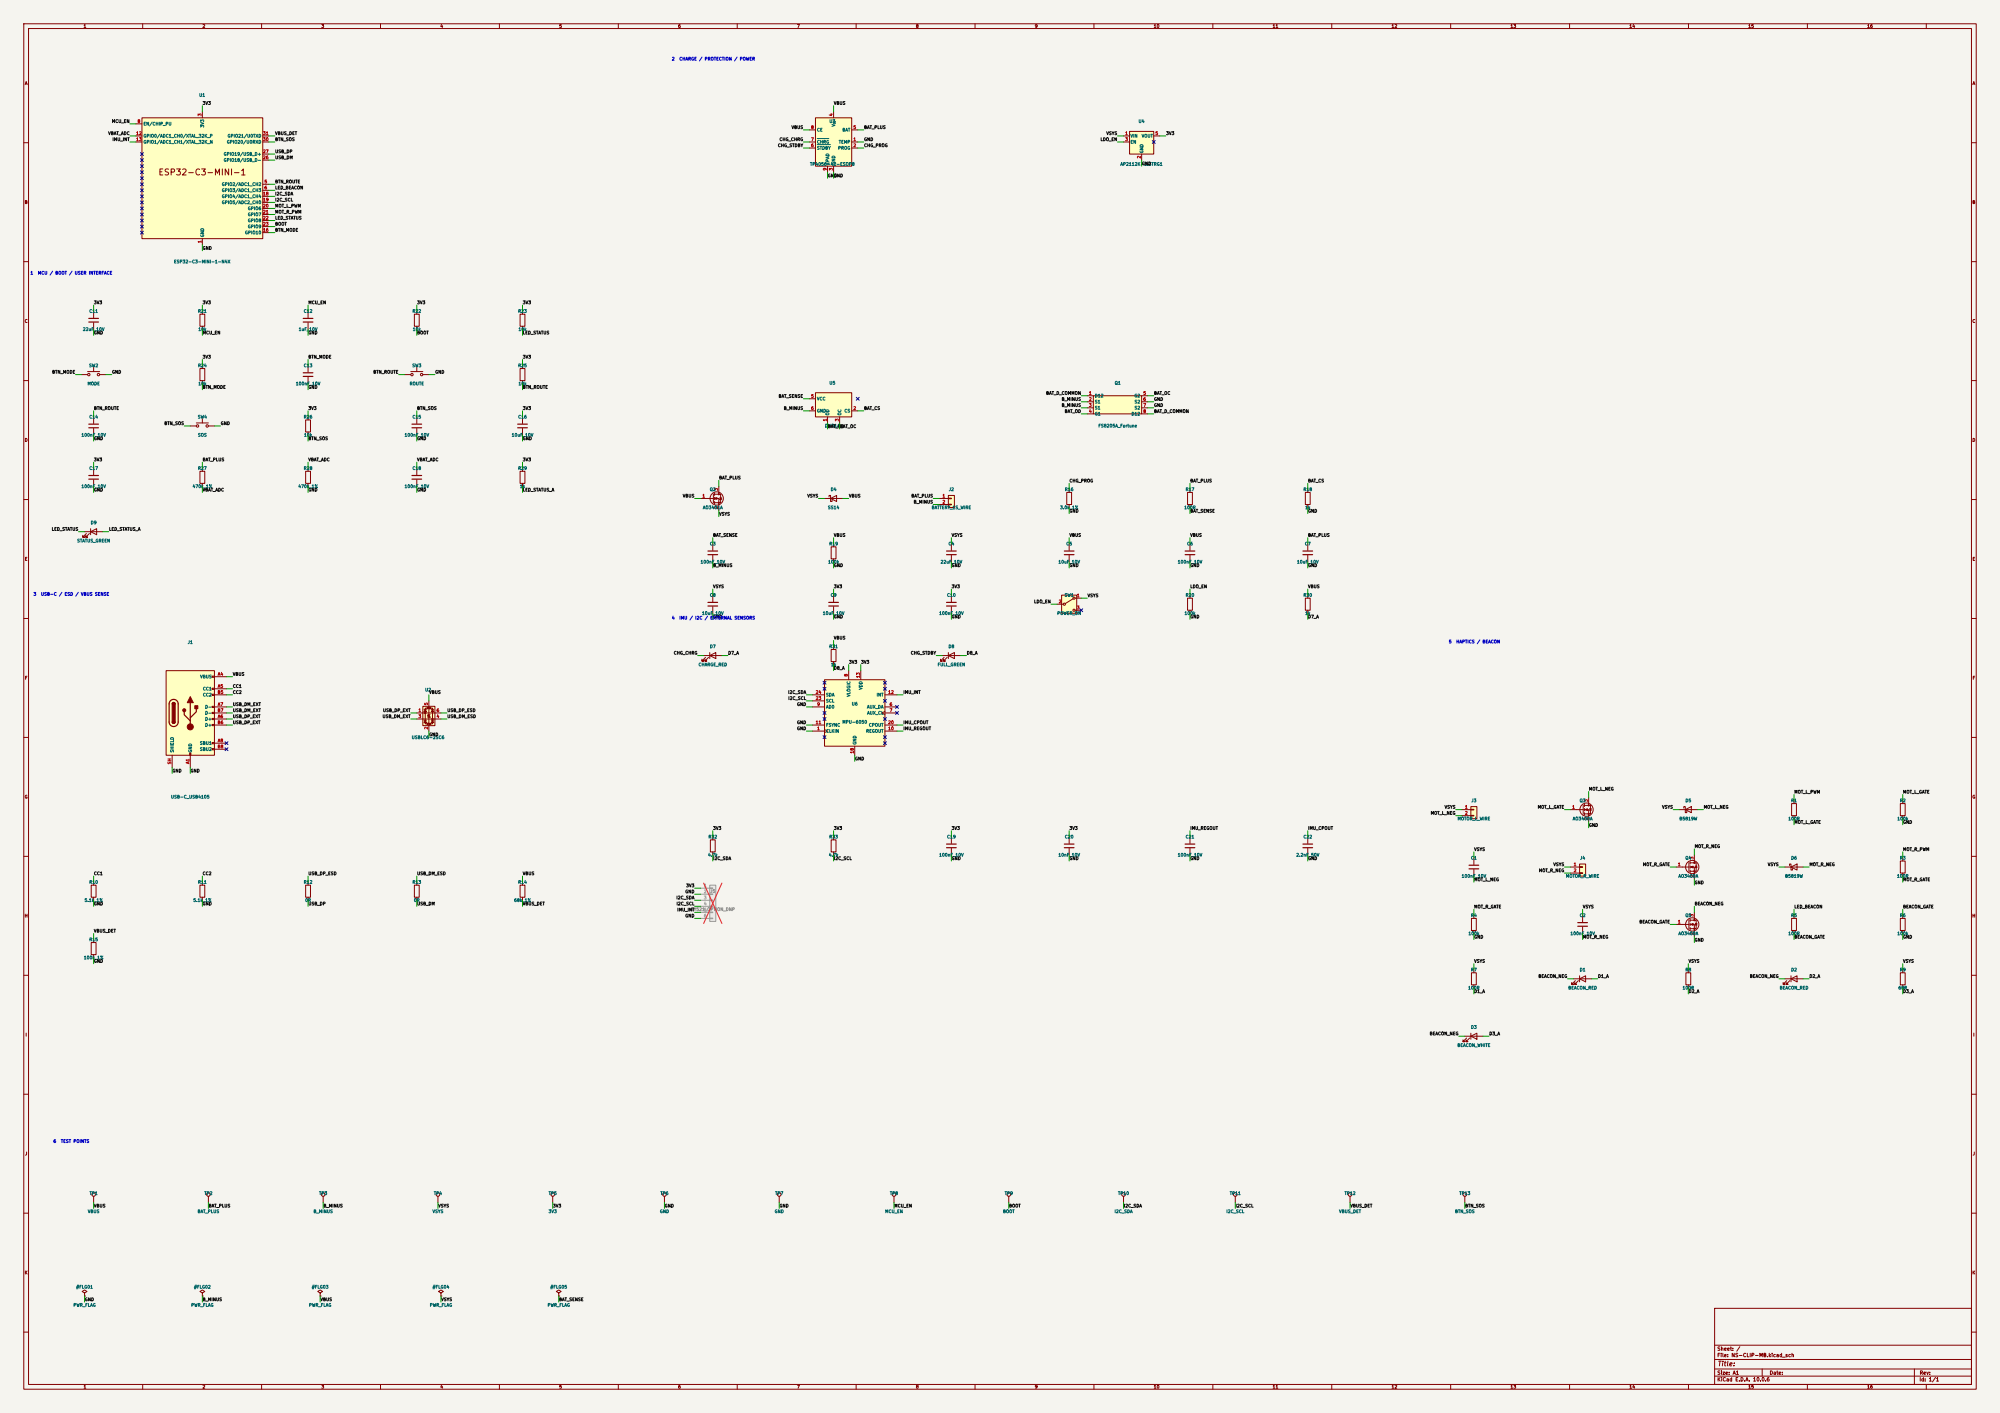
[picture p123: page 1]

1 MCU / BOOT / USER INTERFACE

3 USB-C / ESD / VBUS SENSE

File: NS-CLIP-MB.kicad_sch
Title:

Size: A1 | Rev:
KiCad E.D.A. 10.0.6 | Id: 1/1
