gwangzeejay/NovaSight/hardware/NS-CLIP-MB/exports/NS-CLIP-MB.pdf

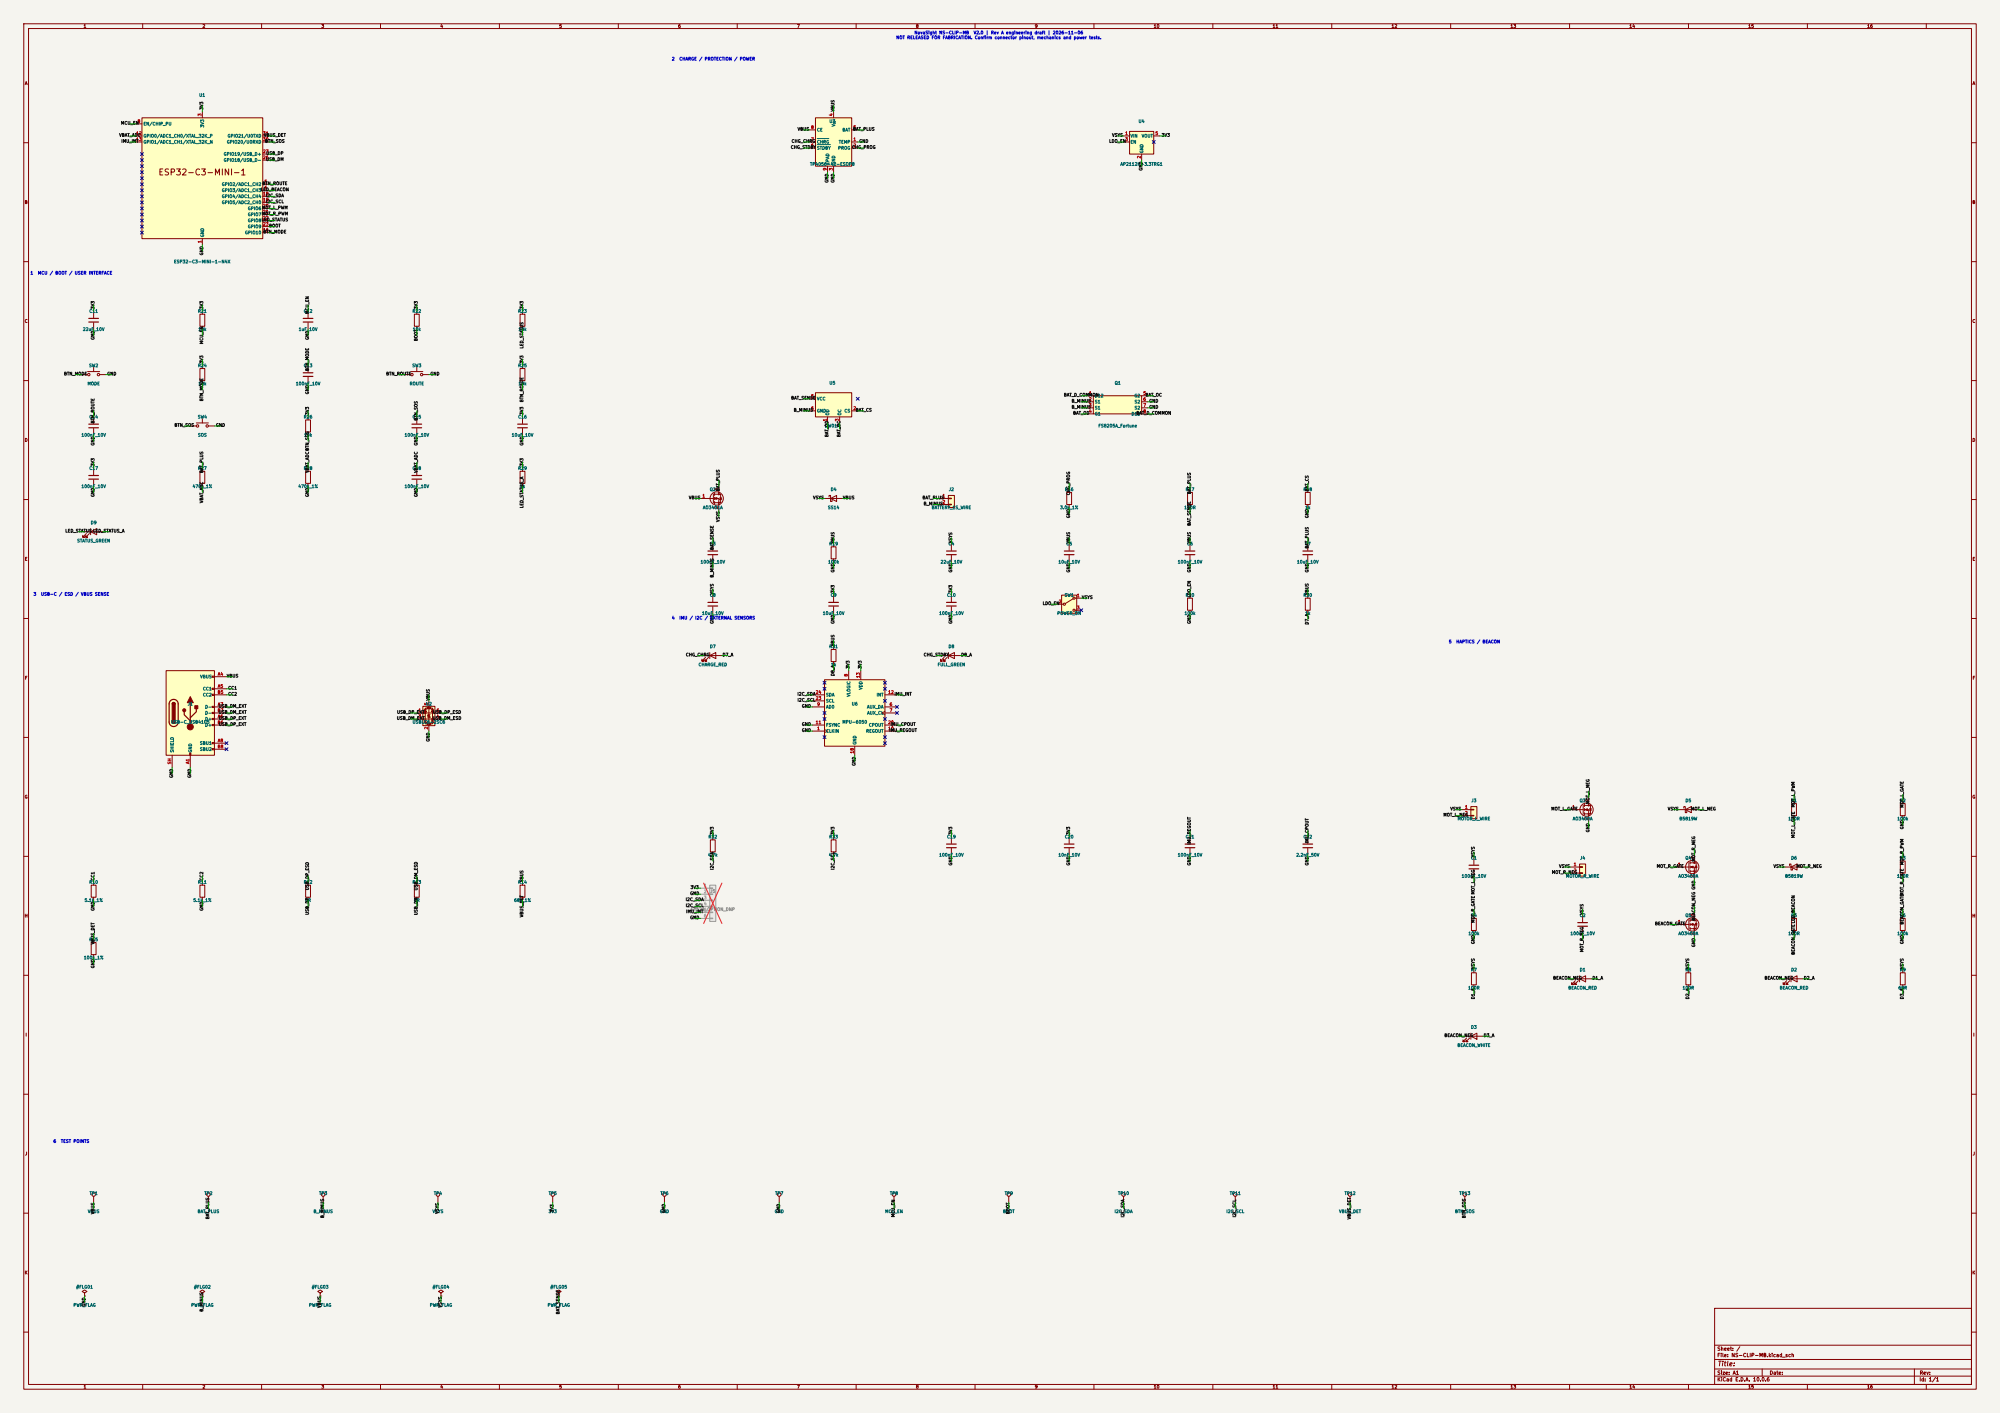
[picture p124: page 1]

NovaSight NS-CLIP-MB V2.0 | Rev A engineering draft | 2026-11-06 NOT RELEASED FOR FABRICATION. Confirm connector pinout, mechanics and power tests. 2 CHARGE / PROTECTION / POWER
IMU_REGOUT GND GND

1 MCU / BOOT / USER INTERFACE

Sheet: /
File: NS-CLIP-MB.kicad_sch
Title:

Size: A1 | Rev:
KiCad E.D.A. 10.0.6 | Id: 1/1
