gwangzeejay/NovaSight/hardware/NS-CHEST-MB/NS-CHEST-MB.kicad_pcb

## KiCad design hardware/NS-CHEST-MB/NS-CHEST-MB.kicad_pcb (2026-11-12)

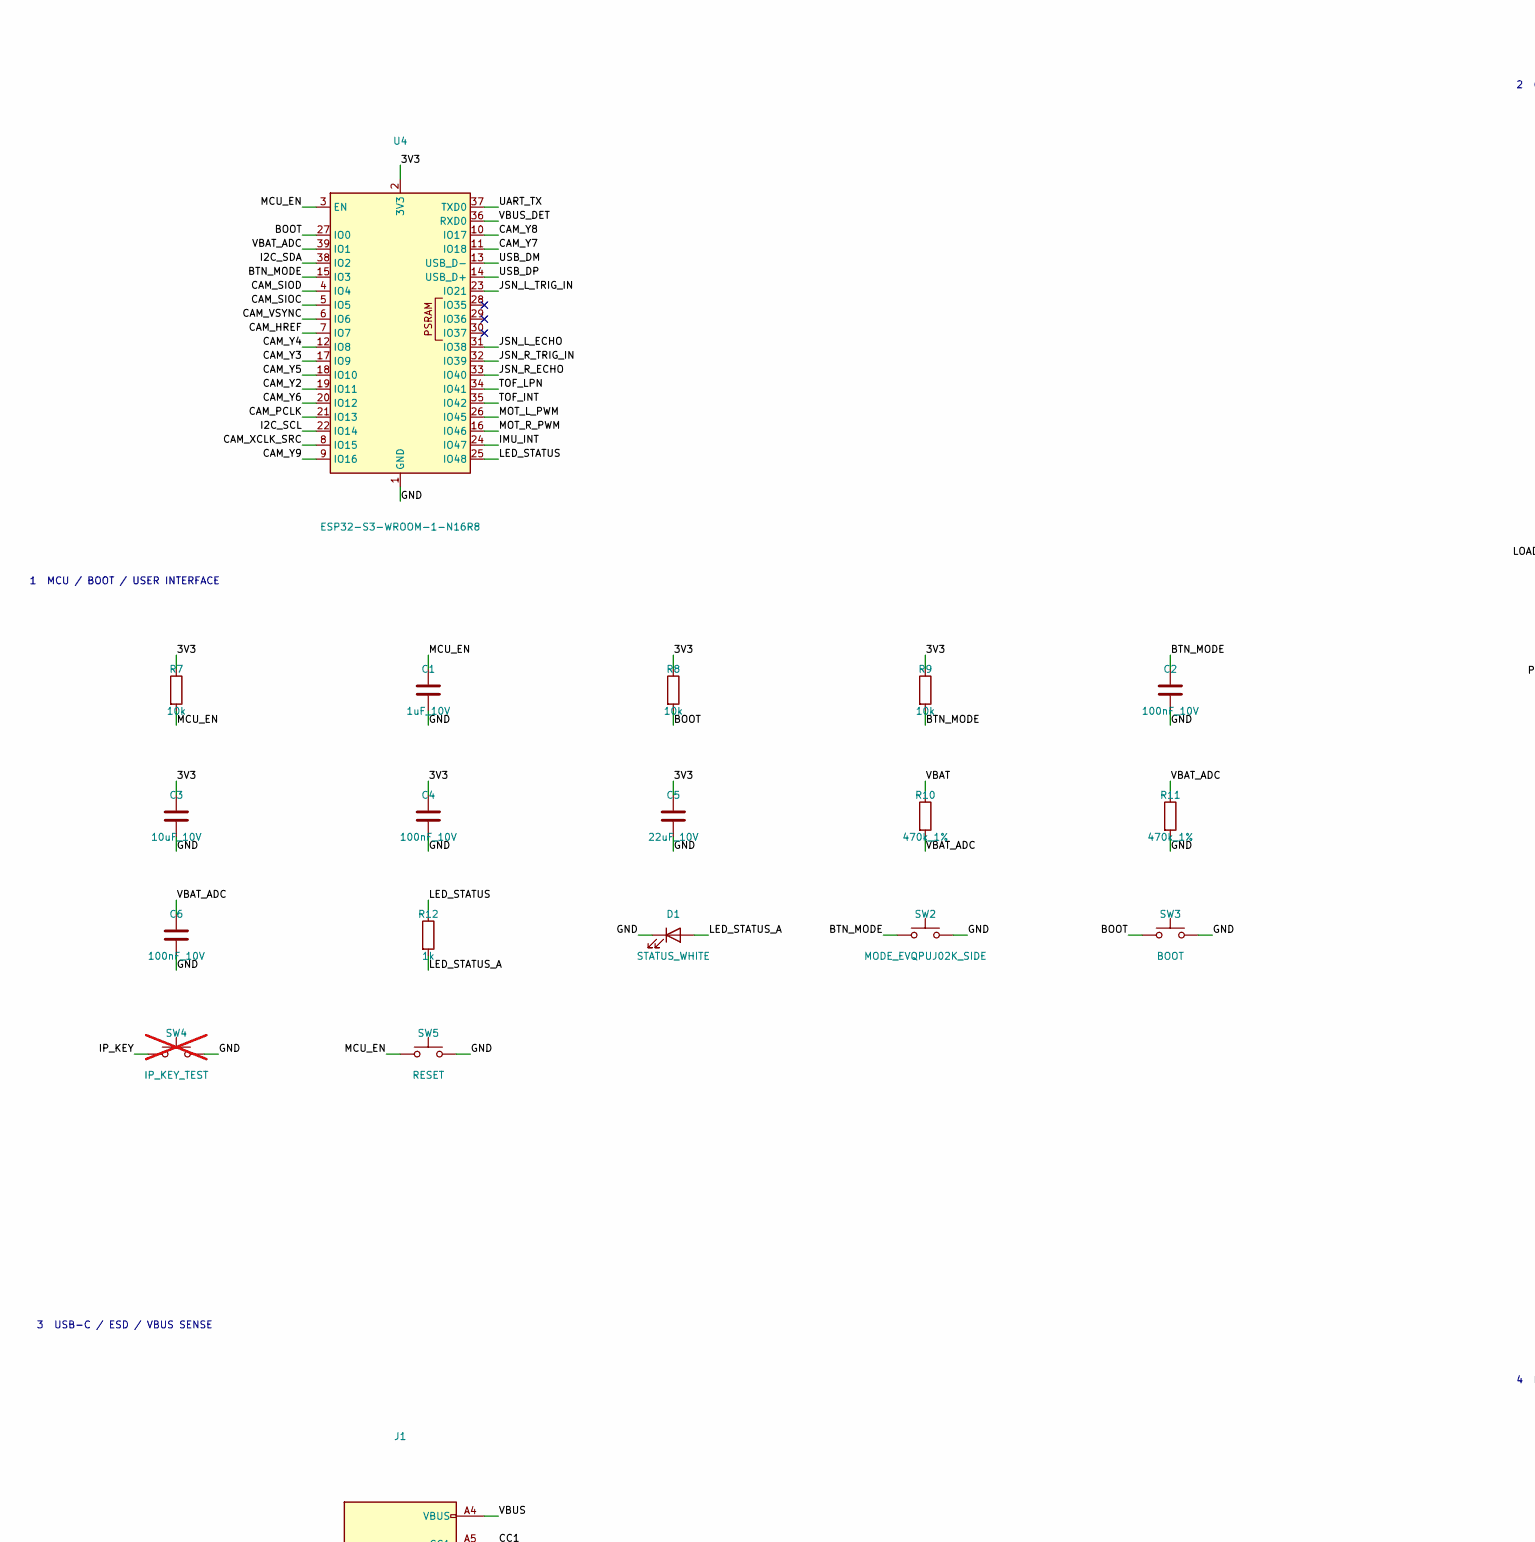
[picture p125: schematic NS-CHEST-MB.kicad_sch, part in row 1, column 1]

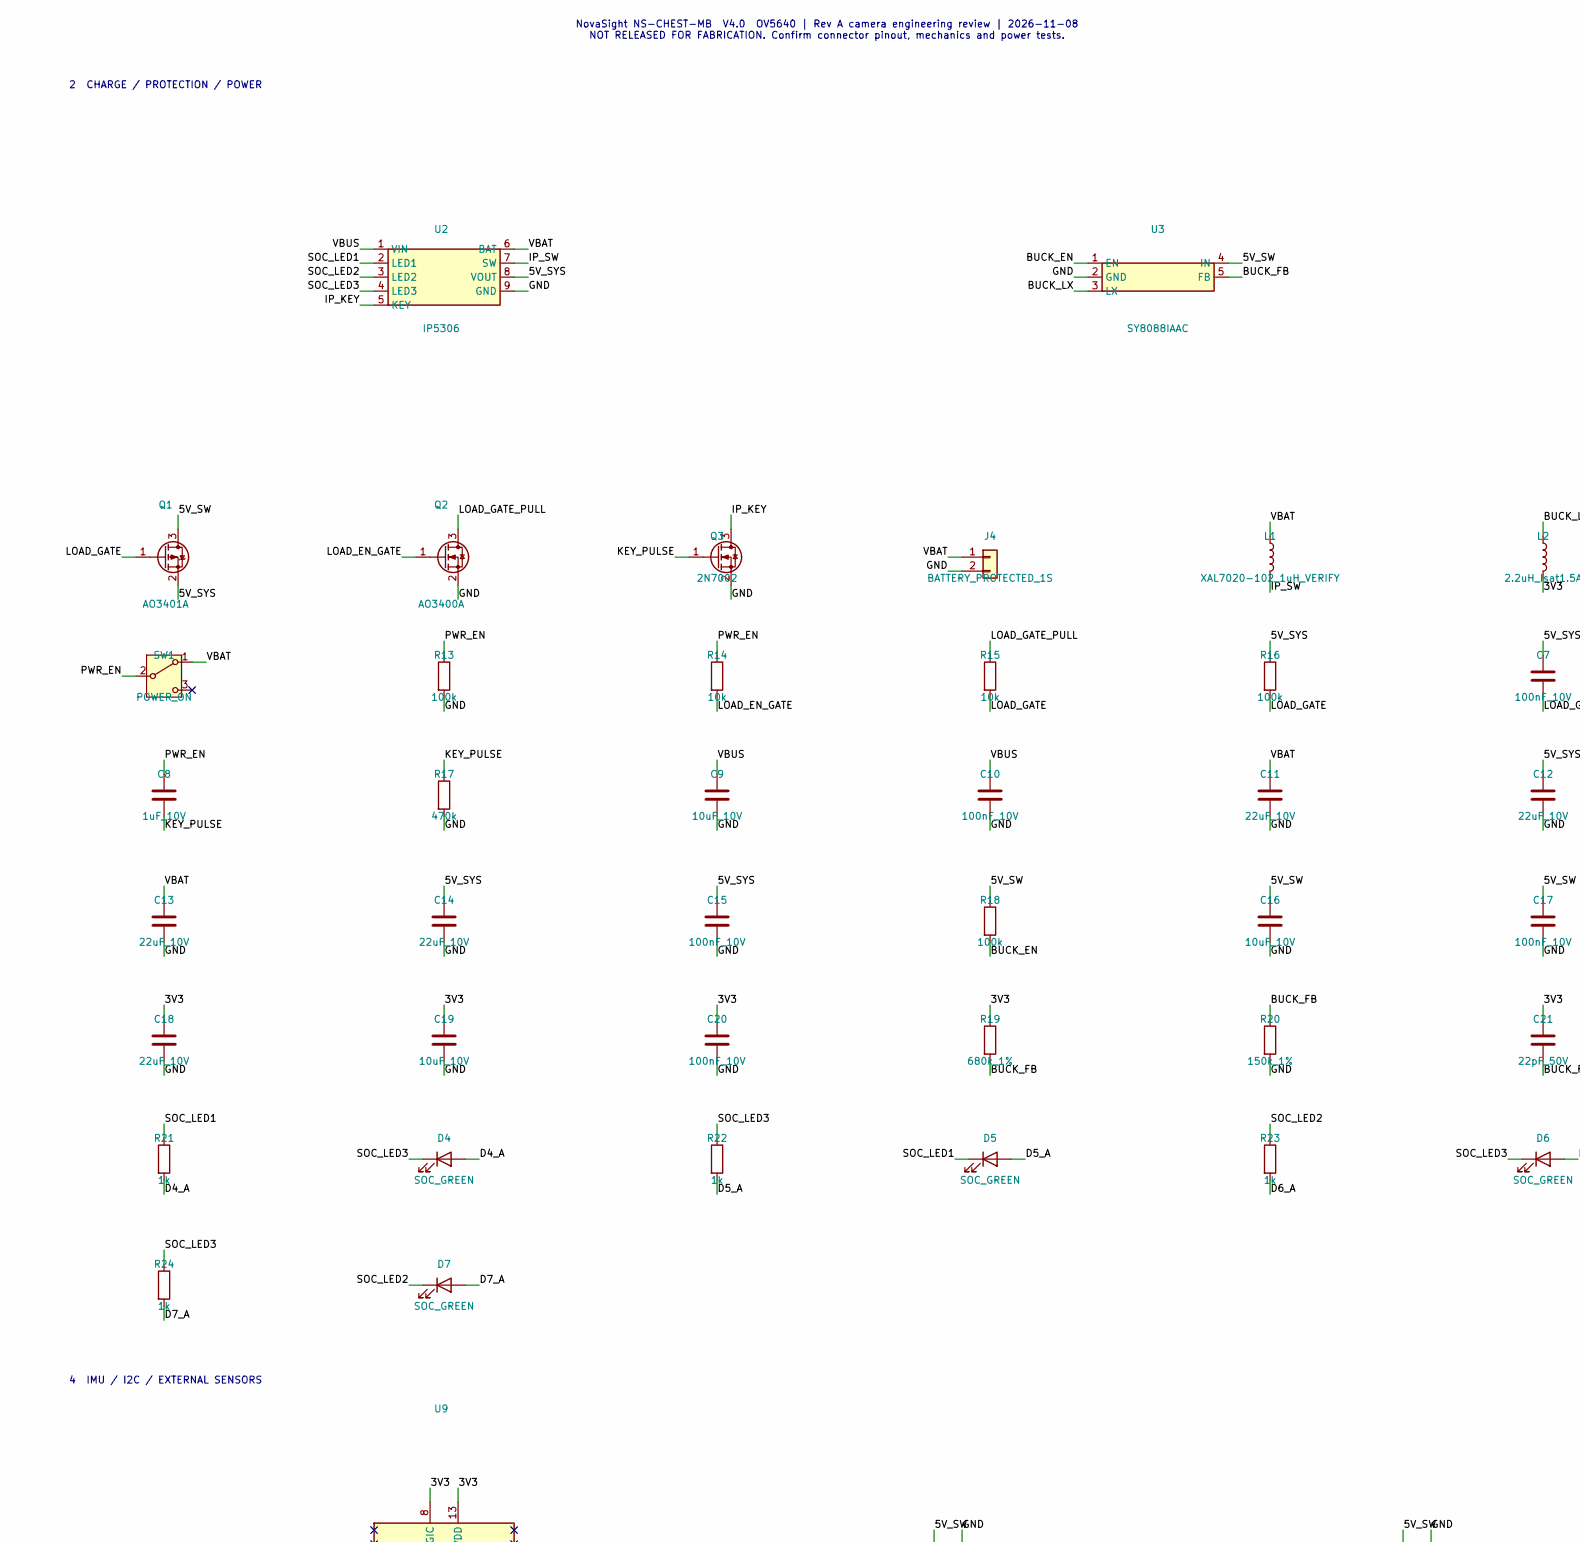
[picture p126: schematic NS-CHEST-MB.kicad_sch, part in row 1, column 2]

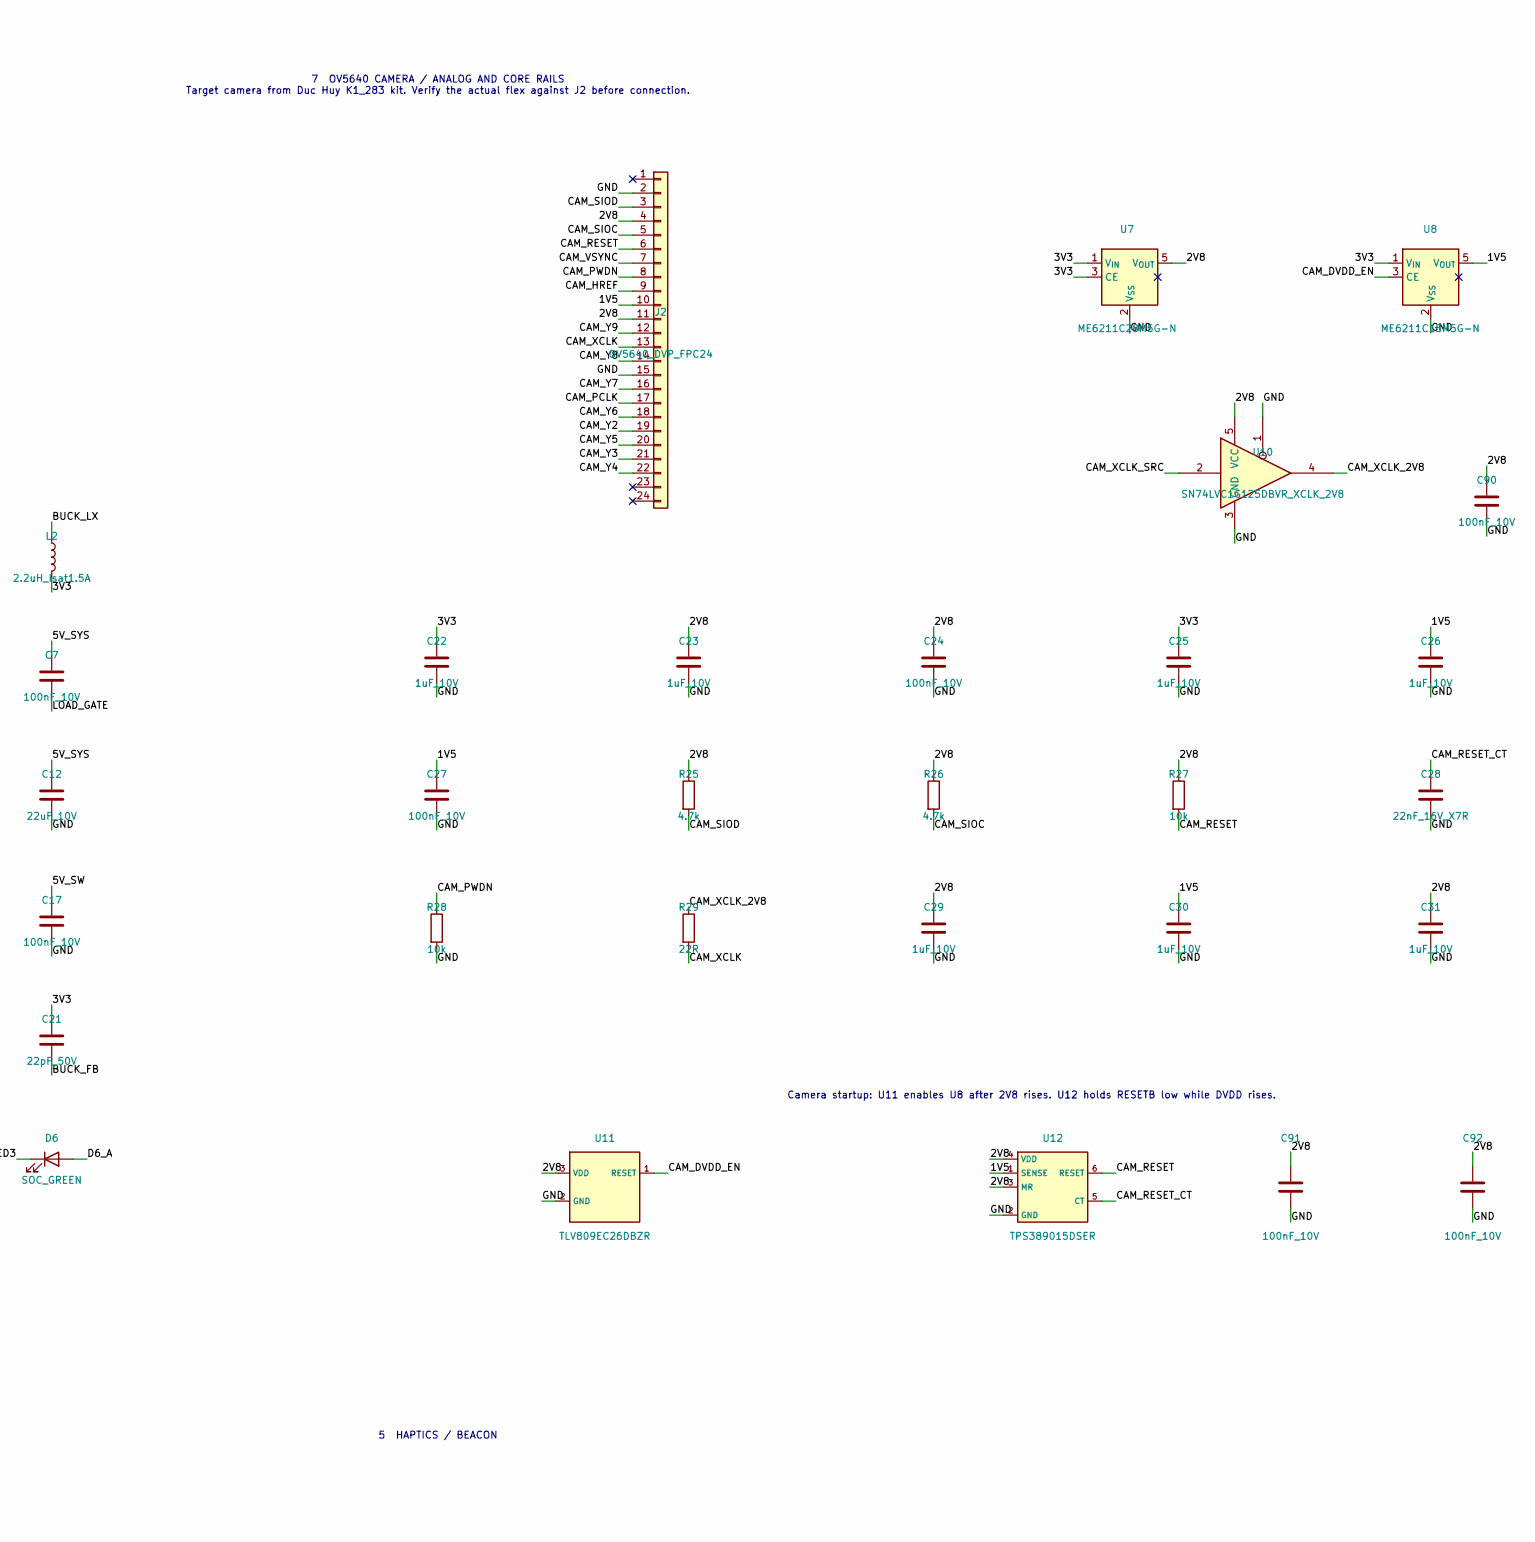
[picture p127: schematic NS-CHEST-MB.kicad_sch, part in row 1, column 3]

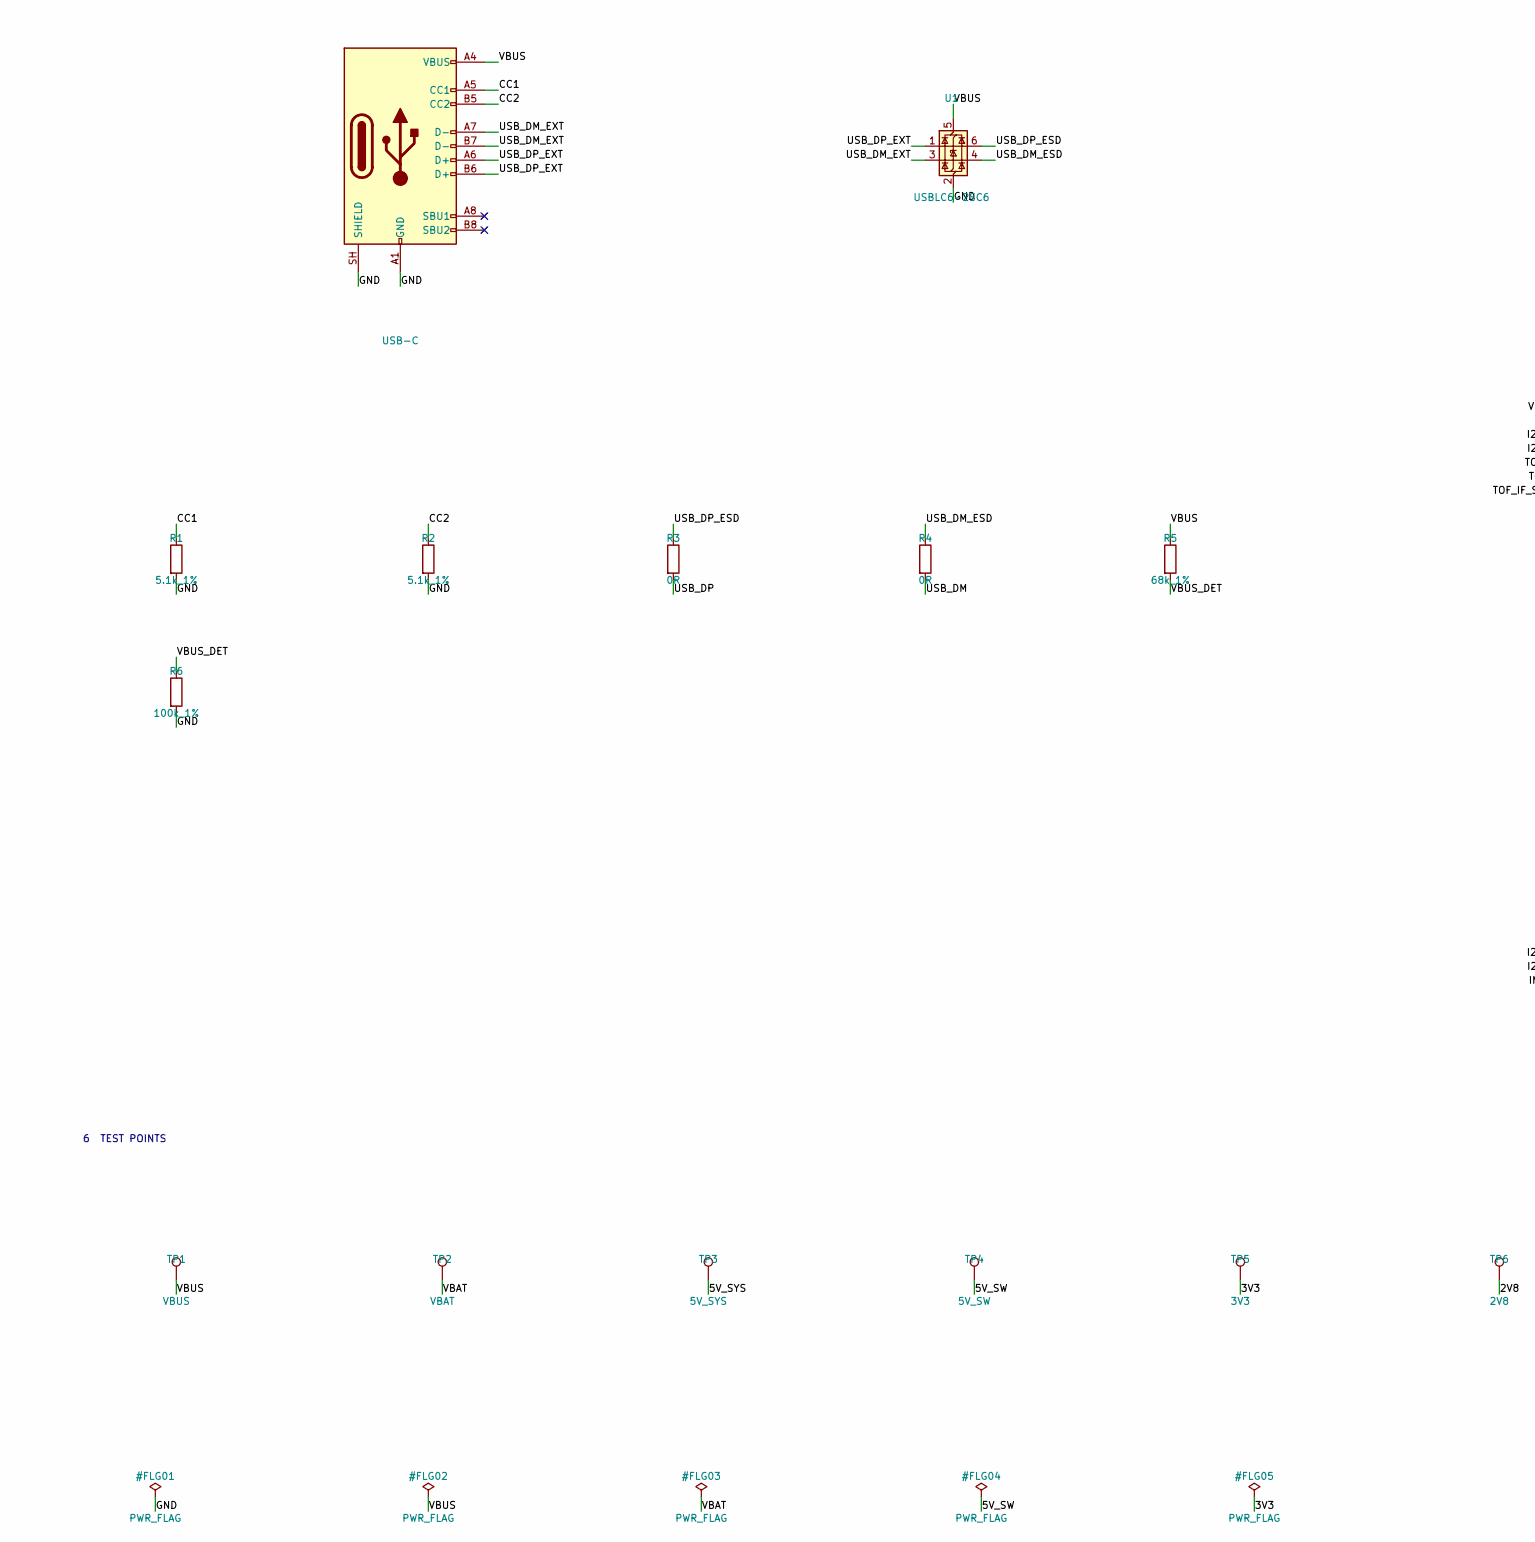
[picture p128: schematic NS-CHEST-MB.kicad_sch, part in row 2, column 1]

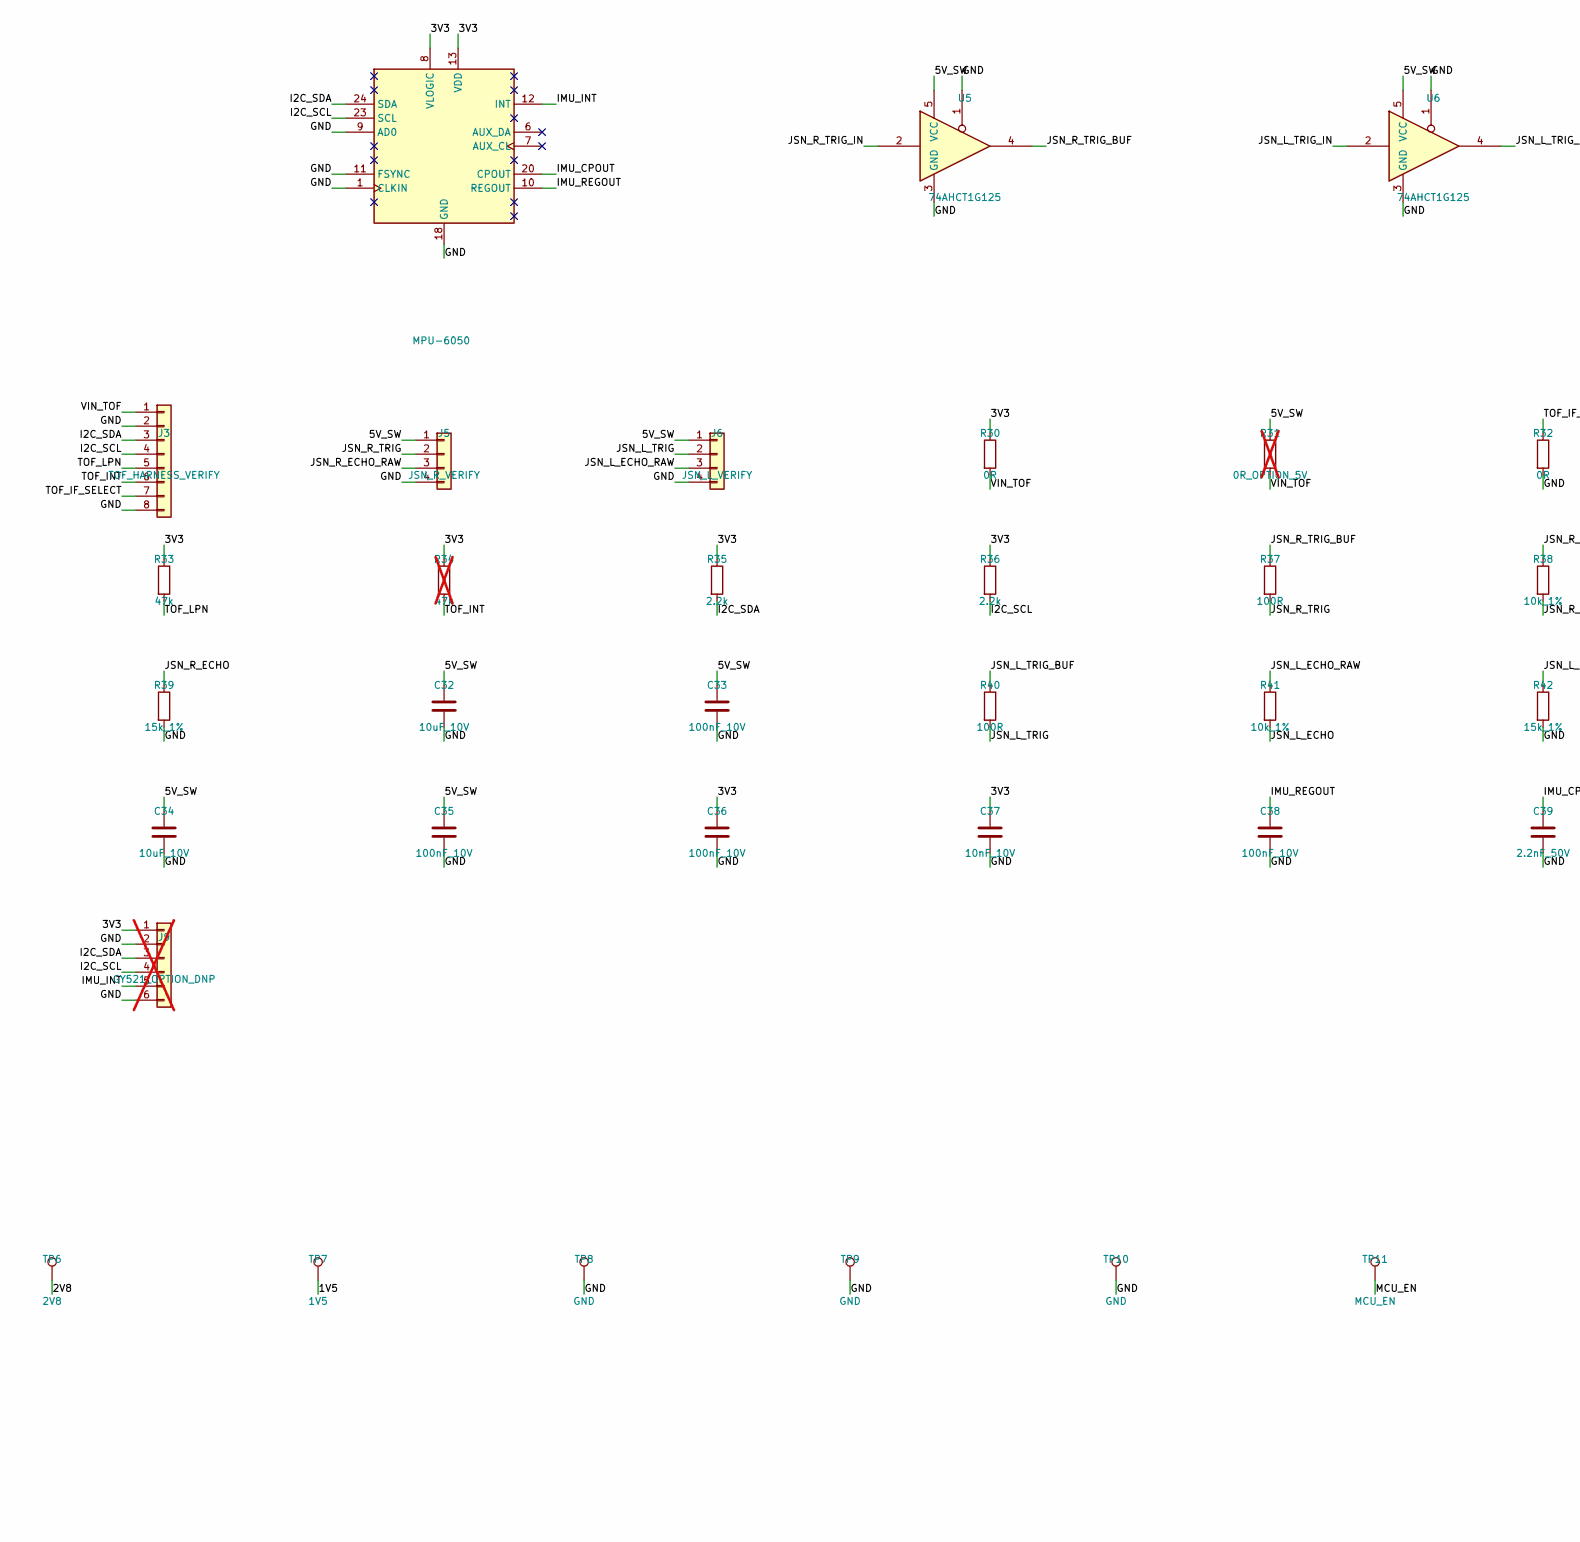
[picture p129: schematic NS-CHEST-MB.kicad_sch, part in row 2, column 2]

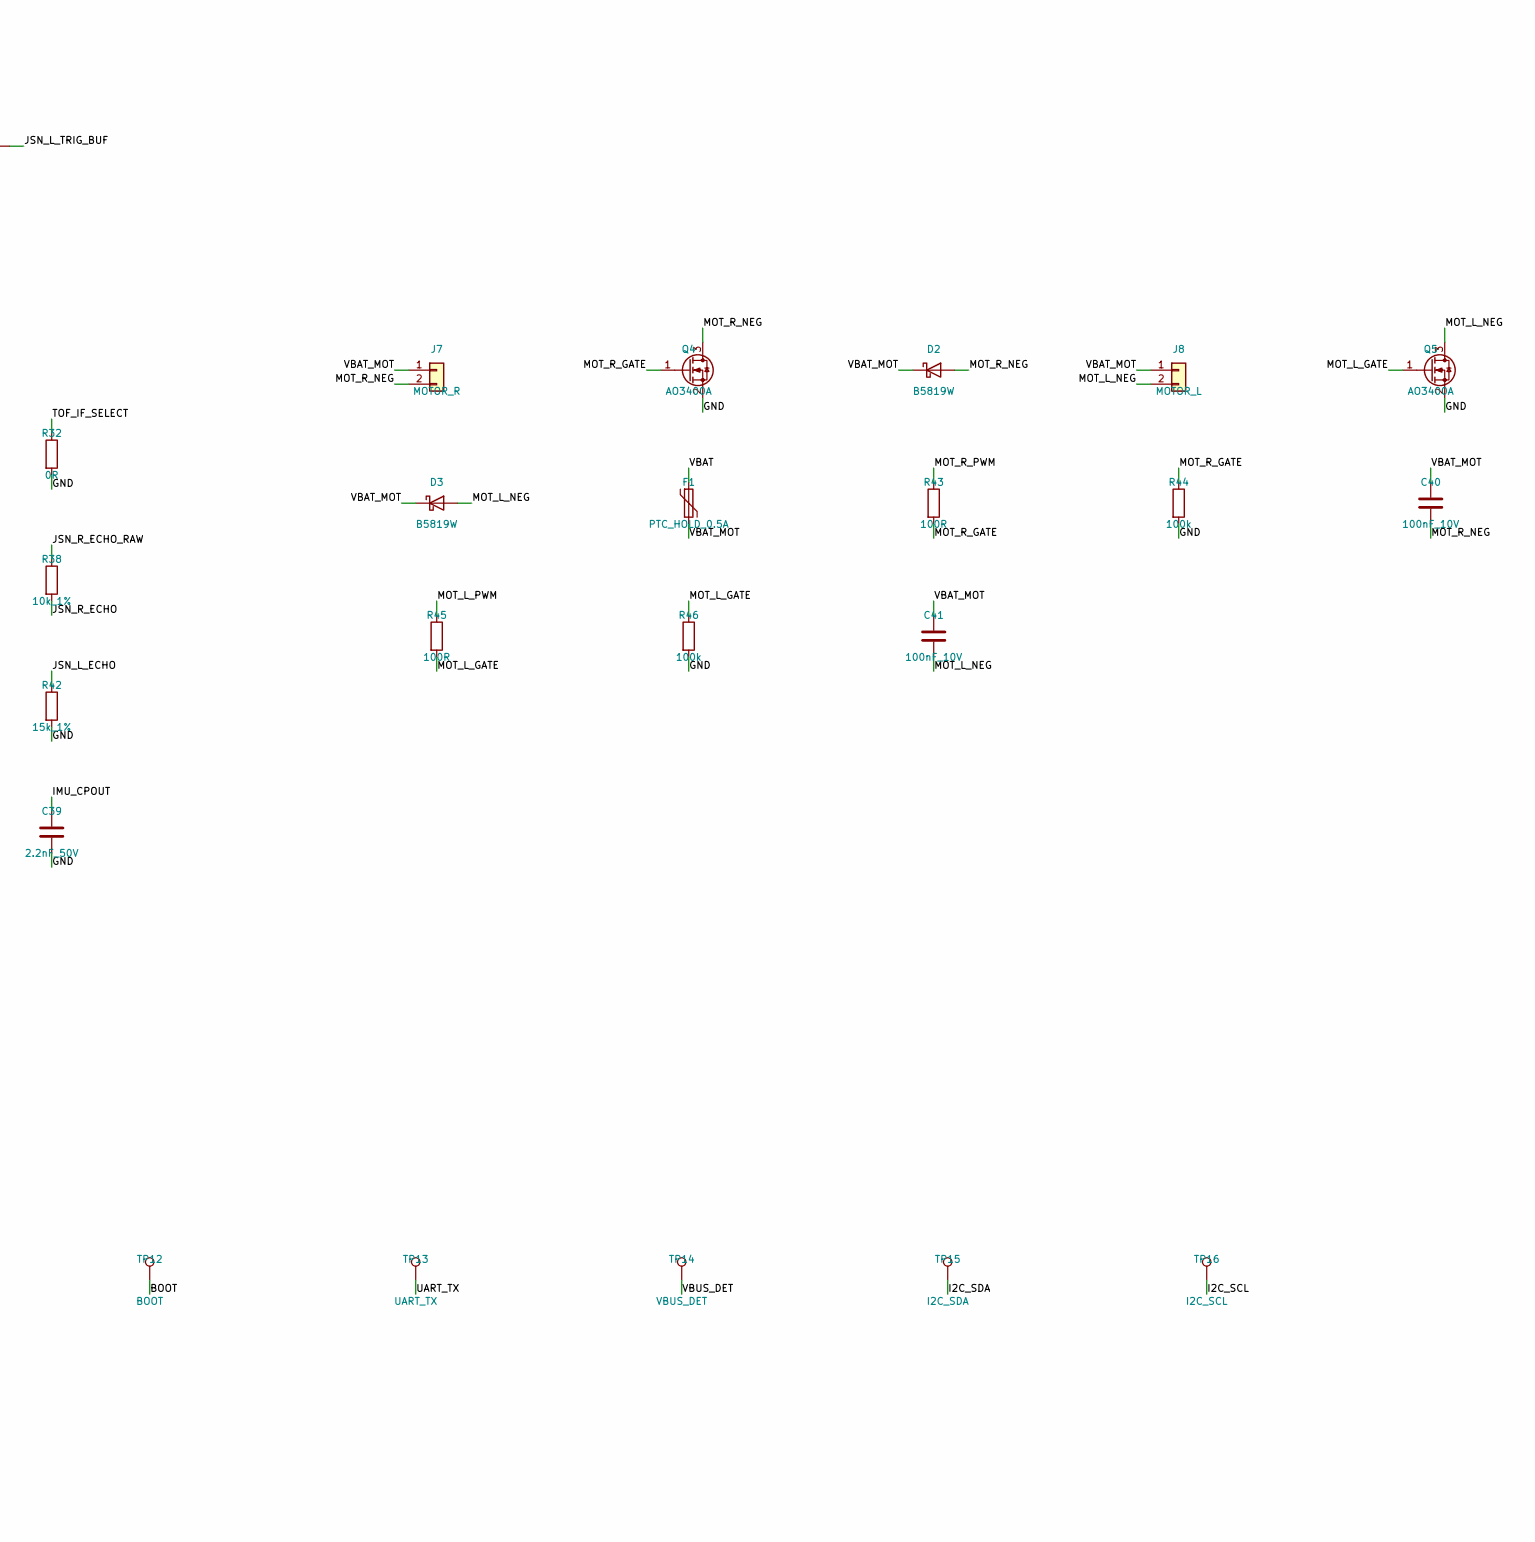
[picture p130: schematic NS-CHEST-MB.kicad_sch, part in row 2, column 3]

Parts:
C1, C8, C22, C23, C25, C26, C29, C30, C31: 1uF_10V; C_0402_1005Metric
C2, C4, C6, C7, C10, C15, C17, C20, C24, C27, C33, C35, C36, C38, C40, C41, C90, C91, C92: 100nF_10V; C_0402_1005Metric
C3, C9, C16, C19, C32, C34: 10uF_10V; C_0603_1608Metric
C5, C11, C12, C13, C14, C18: 22uF_10V; C_0805_2012Metric
C21: 22pF_50V; C_0402_1005Metric
C28: 22nF_16V_X7R; C_0402_1005Metric
C37: 10nF_10V; C_0402_1005Metric
C39: 2.2nF_50V; C_0402_1005Metric
D1: STATUS_WHITE; LED_0603_1608Metric
D2, D3: B5819W; D_SOD-123
D4, D5, D6, D7: SOC_GREEN; LED_0603_1608Metric
F1: PTC_HOLD_0.5A; Fuse_1206_3216Metric
J1: USB-C; USB_C_Receptacle_GCT_USB4105-xx-A_16P_TopMnt_Horizontal
J2: OV5640_DVP_FPC24; Hirose_FH12-24S-0.5SH_1x24-1MP_P0.50mm_Horizontal
J3: TOF_HARNESS_VERIFY; JST_SH_SM08B-SRSS-TB_1x08-1MP_P1.00mm_Horizontal
J4: BATTERY_PROTECTED_1S; JST_PH_B2B-PH-K_1x02_P2.00mm_Vertical
J5: JSN_R_VERIFY; JST_PH_B4B-PH-K_1x04_P2.00mm_Vertical
J6: JSN_L_VERIFY; JST_PH_B4B-PH-K_1x04_P2.00mm_Vertical
J7: MOTOR_R; JST_PH_B2B-PH-K_1x02_P2.00mm_Vertical
J8: MOTOR_L; JST_PH_B2B-PH-K_1x02_P2.00mm_Vertical
J9: GY521_OPTION_DNP; JST_SH_SM06B-SRSS-TB_1x06-1MP_P1.00mm_Horizontal; not fitted
L1: XAL7020-102_1uH_VERIFY; L_Coilcraft_XAL7020-102
L2: 2.2uH_Isat1.5A; L_Bourns-SRN4018
Q1: AO3401A; SOT-23
Q2, Q4, Q5: AO3400A; SOT-23
Q3: 2N7002; SOT-23
R1, R2: 5.1k_1%; R_0402_1005Metric
R3, R4, R30, R32: 0R; R_0402_1005Metric
R5: 68k_1%; R_0402_1005Metric
R6: 100k_1%; R_0402_1005Metric
R7, R8, R9, R14, R15, R27, R28: 10k; R_0402_1005Metric
R10, R11: 470k_1%; R_0402_1005Metric
R12, R21, R22, R23, R24: 1k; R_0402_1005Metric
R13, R16, R18, R44, R46: 100k; R_0402_1005Metric
R17: 470k; R_0402_1005Metric
R19: 680k_1%; R_0402_1005Metric
R20: 150k_1%; R_0402_1005Metric
R25, R26: 4.7k; R_0402_1005Metric
R29: 22R; R_0402_1005Metric
R31: 0R_OPTION_5V; R_0402_1005Metric; not fitted
R33: 47k; R_0402_1005Metric
R34: 47k; R_0402_1005Metric; not fitted
R35, R36: 2.2k; R_0402_1005Metric
R37, R40, R43, R45: 100R; R_0402_1005Metric
R38, R41: 10k_1%; R_0402_1005Metric
R39, R42: 15k_1%; R_0402_1005Metric
SW1: POWER_ON; SW_SPDT_Shouhan_MSK12C02
SW2: MODE_EVQPUJ02K_SIDE; Panasonic_EVQPUJ_EVQPUA
SW3: BOOT; SW_SPST_TL3342
SW4: IP_KEY_TEST; SW_SPST_TL3342; not fitted
SW5: RESET; SW_SPST_TL3342
TP1: VBUS; TestPoint_Pad_D1.0mm
TP2: VBAT; TestPoint_Pad_D1.0mm
TP3: 5V_SYS; TestPoint_Pad_D1.0mm
TP4: 5V_SW; TestPoint_Pad_D1.0mm
TP5: 3V3; TestPoint_Pad_D1.0mm
TP6: 2V8; TestPoint_Pad_D1.0mm
TP7: 1V5; TestPoint_Pad_D1.0mm
TP8, TP9, TP10: GND; TestPoint_Pad_D1.0mm
TP11: MCU_EN; TestPoint_Pad_D1.0mm
TP12: BOOT; TestPoint_Pad_D1.0mm
TP13: UART_TX; TestPoint_Pad_D1.0mm
TP14: VBUS_DET; TestPoint_Pad_D1.0mm
TP15: I2C_SDA; TestPoint_Pad_D1.0mm
TP16: I2C_SCL; TestPoint_Pad_D1.0mm
U1: USBLC6-2SC6; SOT-23-6
U2: IP5306; HSOP-8-1EP_3.9x4.9mm_P1.27mm_EP2.41x3.1mm
U3: SY8088IAAC; SOT-23-5; LCSC C479072
U4: ESP32-S3-WROOM-1-N16R8; ESP32-S3-WROOM-1
U5, U6: 74AHCT1G125; SOT-23-5
U7: ME6211C28M5G-N; SOT-23-5
U8: ME6211C15M5G-N; SOT-23-5
U9: MPU-6050; InvenSense_QFN-24_4x4mm_P0.5mm; LCSC C24112
U10: SN74LVC1G125DBVR_XCLK_2V8; SOT-23-5
U11: TLV809EC26DBZR; SOT-23
U12: TPS389015DSER; WSON-6_1.5x1.5mm_P0.5mm

Connections:
/1V5: C26.1, C27.1, C30.1, J2.10, TP7.1, U8.5 (V_{OUT}), U12.1 (SENSE)
/2V8: C23.1, C24.1, C29.1, C31.1, C90.1, C91.1, C92.1, J2.4, J2.11, R25.1, R26.1, R27.1, TP6.1, U7.5 (V_{OUT}), U10.5 (VCC), U11.3 (VDD), U12.3 (MR), U12.4 (VDD)
/3V3: C3.1, C4.1, C5.1, C18.1, C19.1, C20.1, C21.1, C22.1, C25.1, C36.1, C37.1, J9.1, L2.2, R7.1, R8.1, R9.1, R19.1, R30.1, R33.1, R34.1, R35.1, R36.1, TP5.1, U4.2 (3V3), U7.1 (V_{IN}), U7.3 (CE), U8.1 (V_{IN}), U9.8 (VLOGIC), U9.13 (VDD)
/5V_SW: C16.1, C17.1, C32.1, C33.1, C34.1, C35.1, J5.1, J6.1, Q1.3 (D), R18.1, R31.1, TP4.1, U3.4 (IN), U5.5 (VCC), U6.5 (VCC)
/5V_SYS: C7.1, C12.1, C14.1, C15.1, Q1.2 (S), R16.1, TP3.1, U2.8 (VOUT)
/BOOT: R8.2, SW3.1, TP12.1, U4.27 (IO0)
/BTN_MODE: C2.1, R9.2, SW2.1, U4.15 (IO3)
/BUCK_EN: R18.2, U3.1 (EN)
/BUCK_FB: C21.2, R19.2, R20.1, U3.5 (FB)
/BUCK_LX: L2.1, U3.3 (LX)
/CAM_DVDD_EN: U8.3 (CE), U11.1 (RESET)
/CAM_HREF: J2.9, U4.7 (IO7)
/CAM_PCLK: J2.17, U4.21 (IO13)
/CAM_PWDN: J2.8, R28.1
/CAM_RESET: J2.6, R27.2, U12.6 (RESET)
/CAM_RESET_CT: C28.1, U12.5 (CT)
/CAM_SIOC: J2.5, R26.2, U4.5 (IO5)
/CAM_SIOD: J2.3, R25.2, U4.4 (IO4)
/CAM_VSYNC: J2.7, U4.6 (IO6)
/CAM_XCLK: J2.13, R29.2
/CAM_XCLK_2V8: R29.1, U10.4
/CAM_XCLK_SRC: U4.8 (IO15), U10.2
/CAM_Y2: J2.19, U4.19 (IO11)
/CAM_Y3: J2.21, U4.17 (IO9)
/CAM_Y4: J2.22, U4.12 (IO8)
/CAM_Y5: J2.20, U4.18 (IO10)
/CAM_Y6: J2.18, U4.20 (IO12)
/CAM_Y7: J2.16, U4.11 (IO18)
/CAM_Y8: J2.14, U4.10 (IO17)
/CAM_Y9: J2.12, U4.9 (IO16)
/CC1: J1.A5 (CC1), R1.1
/CC2: J1.B5 (CC2), R2.1
/D4_A: D4.2 (A), R21.2
/D5_A: D5.2 (A), R22.2
/D6_A: D6.2 (A), R23.2
/D7_A: D7.2 (A), R24.2
/GND: C1.2, C2.2, C3.2, C4.2, C5.2, C6.2, C9.2, C10.2, C11.2, C12.2, C13.2, C14.2, C15.2, C16.2, C17.2, C18.2, C19.2, C20.2, C22.2, C23.2, C24.2, C25.2, C26.2, C27.2, C28.2, C29.2, C30.2, C31.2, C32.2, C33.2, C34.2, C35.2, C36.2, C37.2, C38.2, C39.2, C90.2, C91.2, C92.2, D1.1 (K), J1.A1 (GND), J1.A12 (GND), J1.B1 (GND), J1.B12 (GND), J1.SH (SHIELD), J2.2, J2.15, J3.2, J3.8, J4.2, J5.4, J6.4, J9.2, J9.6, Q2.2 (S), Q3.2 (S), Q4.2 (S), Q5.2 (S), R1.2, R2.2, R6.2, R11.2, R13.2, R17.2, R20.2, R28.2, R32.2, R39.2, R42.2, R44.2, R46.2, SW2.2, SW3.2, SW4.2, SW5.2, TP8.1, TP9.1, TP10.1, U1.2 (GND), U2.9 (GND), U3.2 (GND), U4.1 (GND), U4.40 (GND), U4.41 (GND), U5.1, U5.3 (GND), U6.1, U6.3 (GND), U7.2 (V_{SS}), U8.2 (V_{SS}), U9.1 (CLKIN), U9.9 (AD0), U9.11 (FSYNC), U9.18 (GND), U10.1, U10.3 (GND), U11.2 (GND), U12.2 (GND)
/I2C_SCL: J3.4, J9.4, R36.2, TP16.1, U4.22 (IO14), U9.23 (SCL)
/I2C_SDA: J3.3, J9.3, R35.2, TP15.1, U4.38 (IO2), U9.24 (SDA)
/IMU_CPOUT: C39.1, U9.20 (CPOUT)
/IMU_INT: J9.5, U4.24 (IO47), U9.12 (INT)
/IMU_REGOUT: C38.1, U9.10 (REGOUT)
/IP_KEY: Q3.3 (D), SW4.1, U2.5 (KEY)
/IP_SW: L1.2, U2.7 (SW)
/JSN_L_ECHO: R41.2, R42.1, U4.31 (IO38)
/JSN_L_ECHO_RAW: J6.3, R41.1
/JSN_L_TRIG: J6.2, R40.2
/JSN_L_TRIG_BUF: R40.1, U6.4
/JSN_L_TRIG_IN: U4.23 (IO21), U6.2
/JSN_R_ECHO: R38.2, R39.1, U4.33 (IO40)
/JSN_R_ECHO_RAW: J5.3, R38.1
/JSN_R_TRIG: J5.2, R37.2
/JSN_R_TRIG_BUF: R37.1, U5.4
/JSN_R_TRIG_IN: U4.32 (IO39), U5.2
/KEY_PULSE: C8.2, Q3.1 (G), R17.1
/LED_STATUS: R12.1, U4.25 (IO48)
/LED_STATUS_A: D1.2 (A), R12.2
/LOAD_EN_GATE: Q2.1 (G), R14.2
/LOAD_GATE: C7.2, Q1.1 (G), R15.2, R16.2
/LOAD_GATE_PULL: Q2.3 (D), R15.1
/MCU_EN: C1.1, R7.2, SW5.1, TP11.1, U4.3 (EN)
/MOT_L_GATE: Q5.1 (G), R45.2, R46.1
/MOT_L_NEG: C41.2, D3.2 (A), J8.2, Q5.3 (D)
/MOT_L_PWM: R45.1, U4.26 (IO45)
/MOT_R_GATE: Q4.1 (G), R43.2, R44.1
/MOT_R_NEG: C40.2, D2.2 (A), J7.2, Q4.3 (D)
/MOT_R_PWM: R43.1, U4.16 (IO46)
/PWR_EN: C8.1, R13.1, R14.1, SW1.2 (B)
/SOC_LED1: D5.1 (K), R21.1, U2.2 (LED1)
/SOC_LED2: D7.1 (K), R23.1, U2.3 (LED2)
/SOC_LED3: D4.1 (K), D6.1 (K), R22.1, R24.1, U2.4 (LED3)
/TOF_IF_SELECT: J3.7, R32.1
/TOF_INT: J3.6, R34.2, U4.35 (IO42)
/TOF_LPN: J3.5, R33.2, U4.34 (IO41)
/UART_TX: TP13.1, U4.37 (TXD0)
/USB_DM: R4.2, U4.13 (USB_D-)
/USB_DM_ESD: R4.1, U1.4 (I/O2)
/USB_DM_EXT: J1.A7 (D-), J1.B7 (D-), U1.3 (I/O2)
/USB_DP: R3.2, U4.14 (USB_D+)
/USB_DP_ESD: R3.1, U1.6 (I/O1)
/USB_DP_EXT: J1.A6 (D+), J1.B6 (D+), U1.1 (I/O1)
/VBAT: C11.1, C13.1, F1.1, J4.1, L1.1, R10.1, SW1.1 (A), TP2.1, U2.6 (BAT)
/VBAT_ADC: C6.1, R10.2, R11.1, U4.39 (IO1)
/VBAT_MOT: C40.1, C41.1, D2.1 (K), D3.1 (K), F1.2, J7.1, J8.1
/VBUS: C9.1, C10.1, J1.A4 (VBUS), J1.A9 (VBUS), J1.B4 (VBUS), J1.B9 (VBUS), R5.1, TP1.1, U1.5 (VBUS), U2.1 (VIN)
/VBUS_DET: R5.2, R6.1, TP14.1, U4.36 (RXD0)
/VIN_TOF: J3.1, R30.2, R31.2

Notes on the sheet:
1 MCU / BOOT / USER INTERFACE
2 CHARGE / PROTECTION / POWER
3 USB-C / ESD / VBUS SENSE
4 IMU / I2C / EXTERNAL SENSORS
5 HAPTICS / BEACON
6 TEST POINTS
7 OV5640 CAMERA / ANALOG AND CORE RAILS Target camera from Duc Huy K1_283 kit. Verify the actual flex against J2 before connection.
NovaSight NS-CHEST-MB V4.0 OV5640 | Rev A camera engineering review | 2026-11-08 NOT RELEASED FOR FABRICATION. Confirm connector pinout, mechanics and power tests.
Camera startup: U11 enables U8 after 2V8 rises. U12 holds RESETB low while DVDD rises.

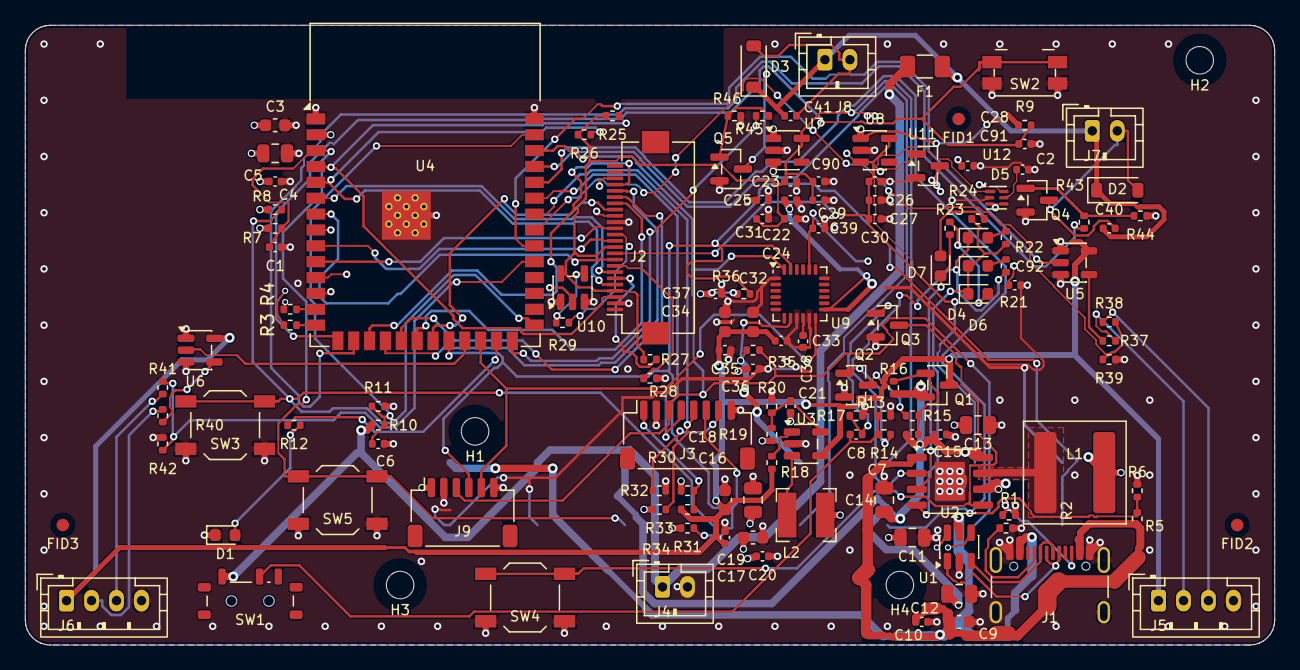
[picture p131: board NS-CHEST-MB.kicad_pcb from above]

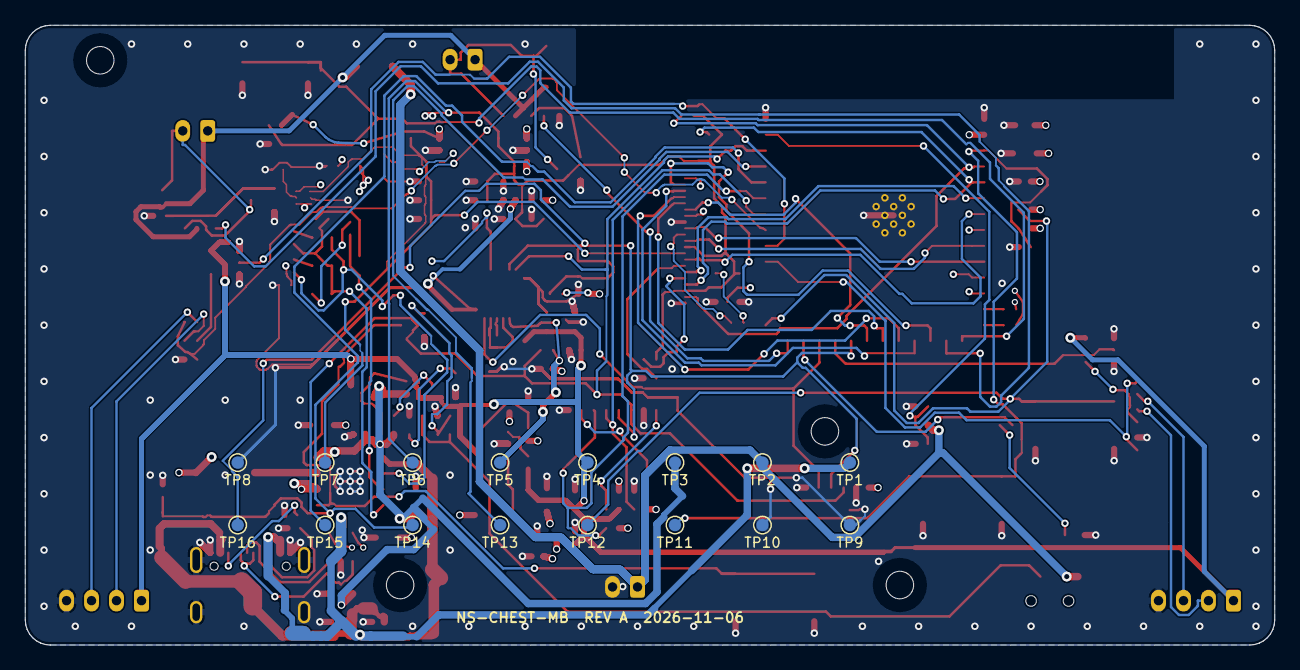
[picture p132: board NS-CHEST-MB.kicad_pcb from below]

Board: 4 copper layers, 100.0 x 49.6 mm, 154 parts (16 on the bottom side), 87 nets.

Other parts of the board:
FID1, FID2, FID3: FIDUCIAL; Fiducial_1mm_Mask2mm
H1, H2, H3, H4: M2_NPTH; MountingHole_2.2mm_M2
