gwangzeejay/NovaSight/hardware/NS-CLIP-MB/NS-CLIP-MB.kicad_pcb

## KiCad design hardware/NS-CLIP-MB/NS-CLIP-MB.kicad_pcb (2026-11-12)

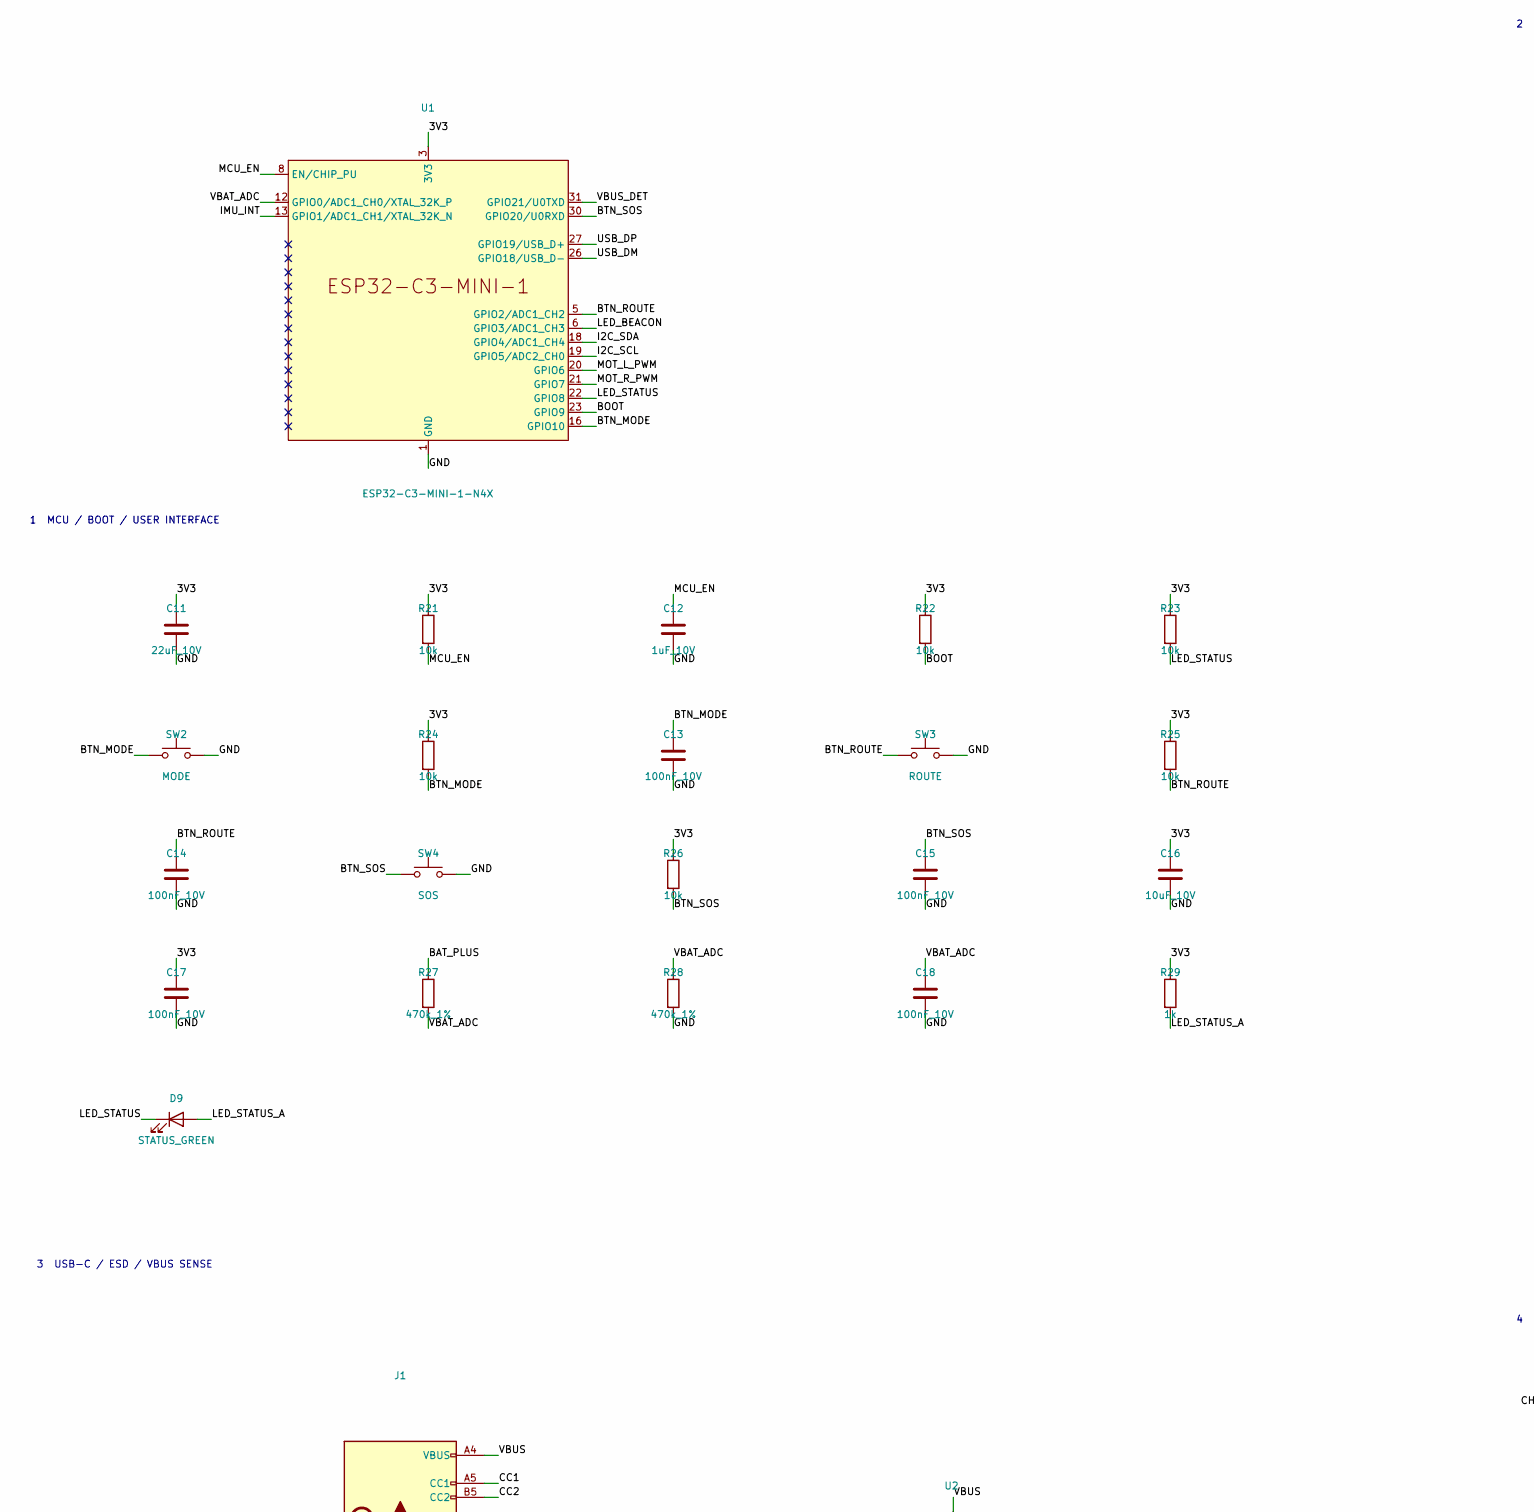
[picture p133: schematic NS-CLIP-MB.kicad_sch, part in row 1, column 1]

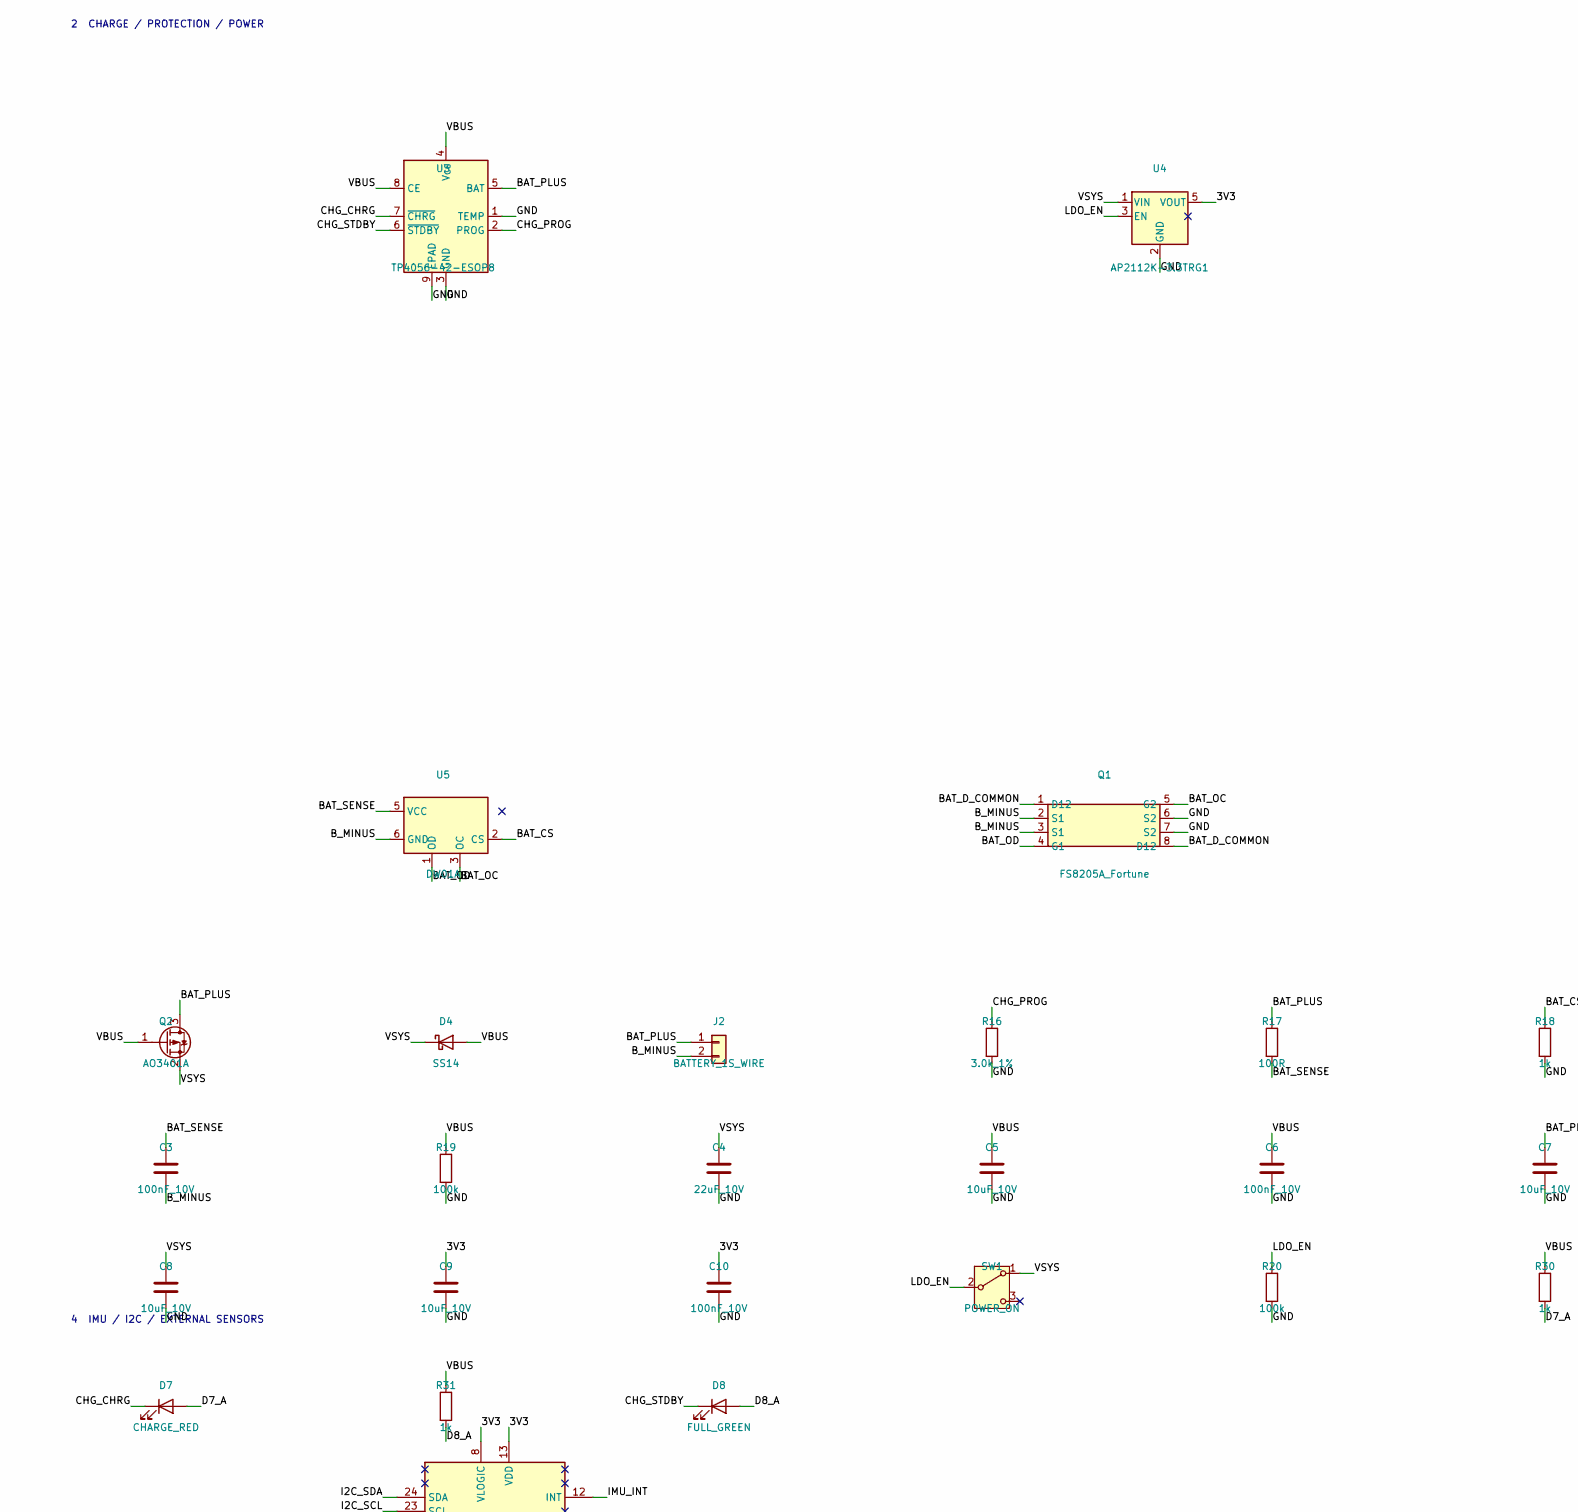
[picture p134: schematic NS-CLIP-MB.kicad_sch, part in row 1, column 2]

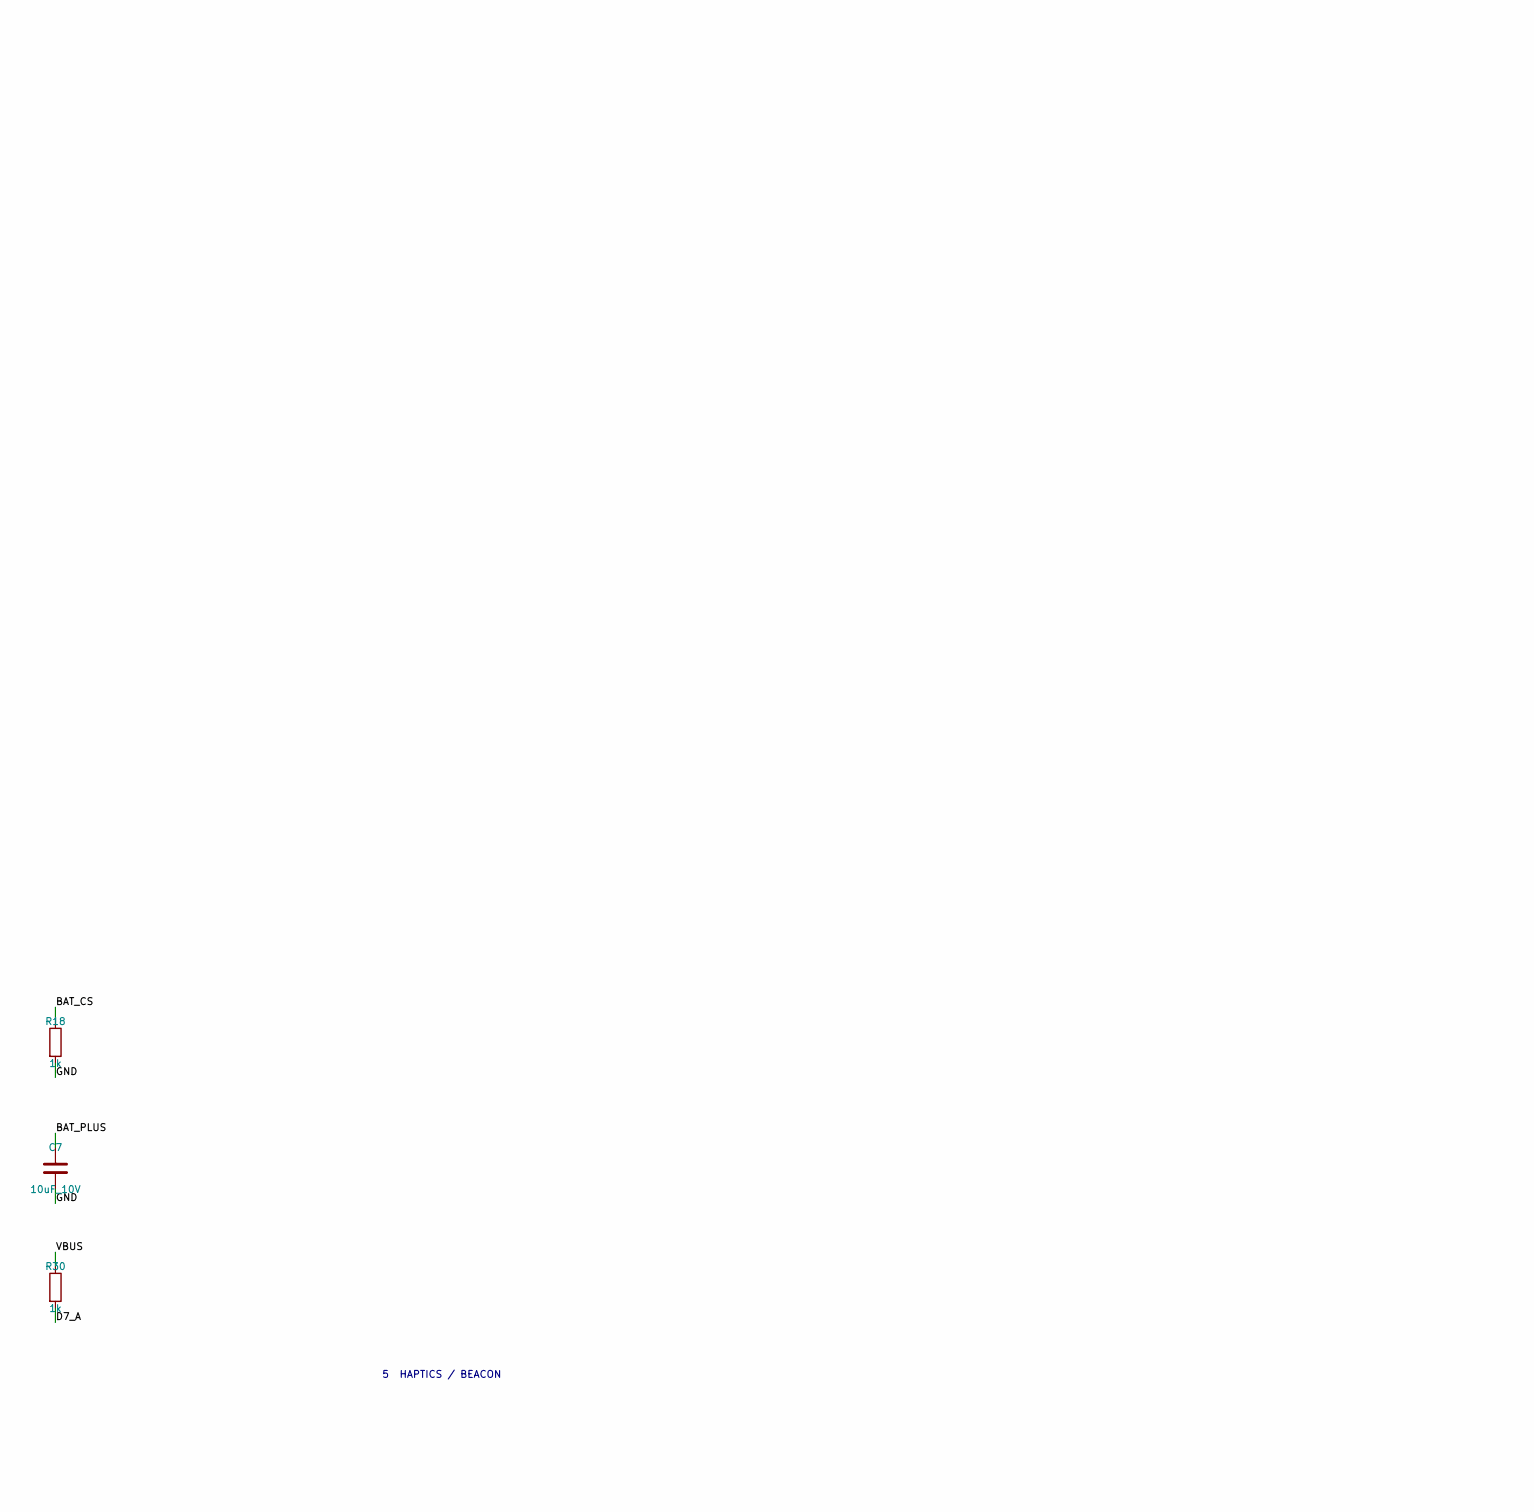
[picture p135: schematic NS-CLIP-MB.kicad_sch, part in row 1, column 3]

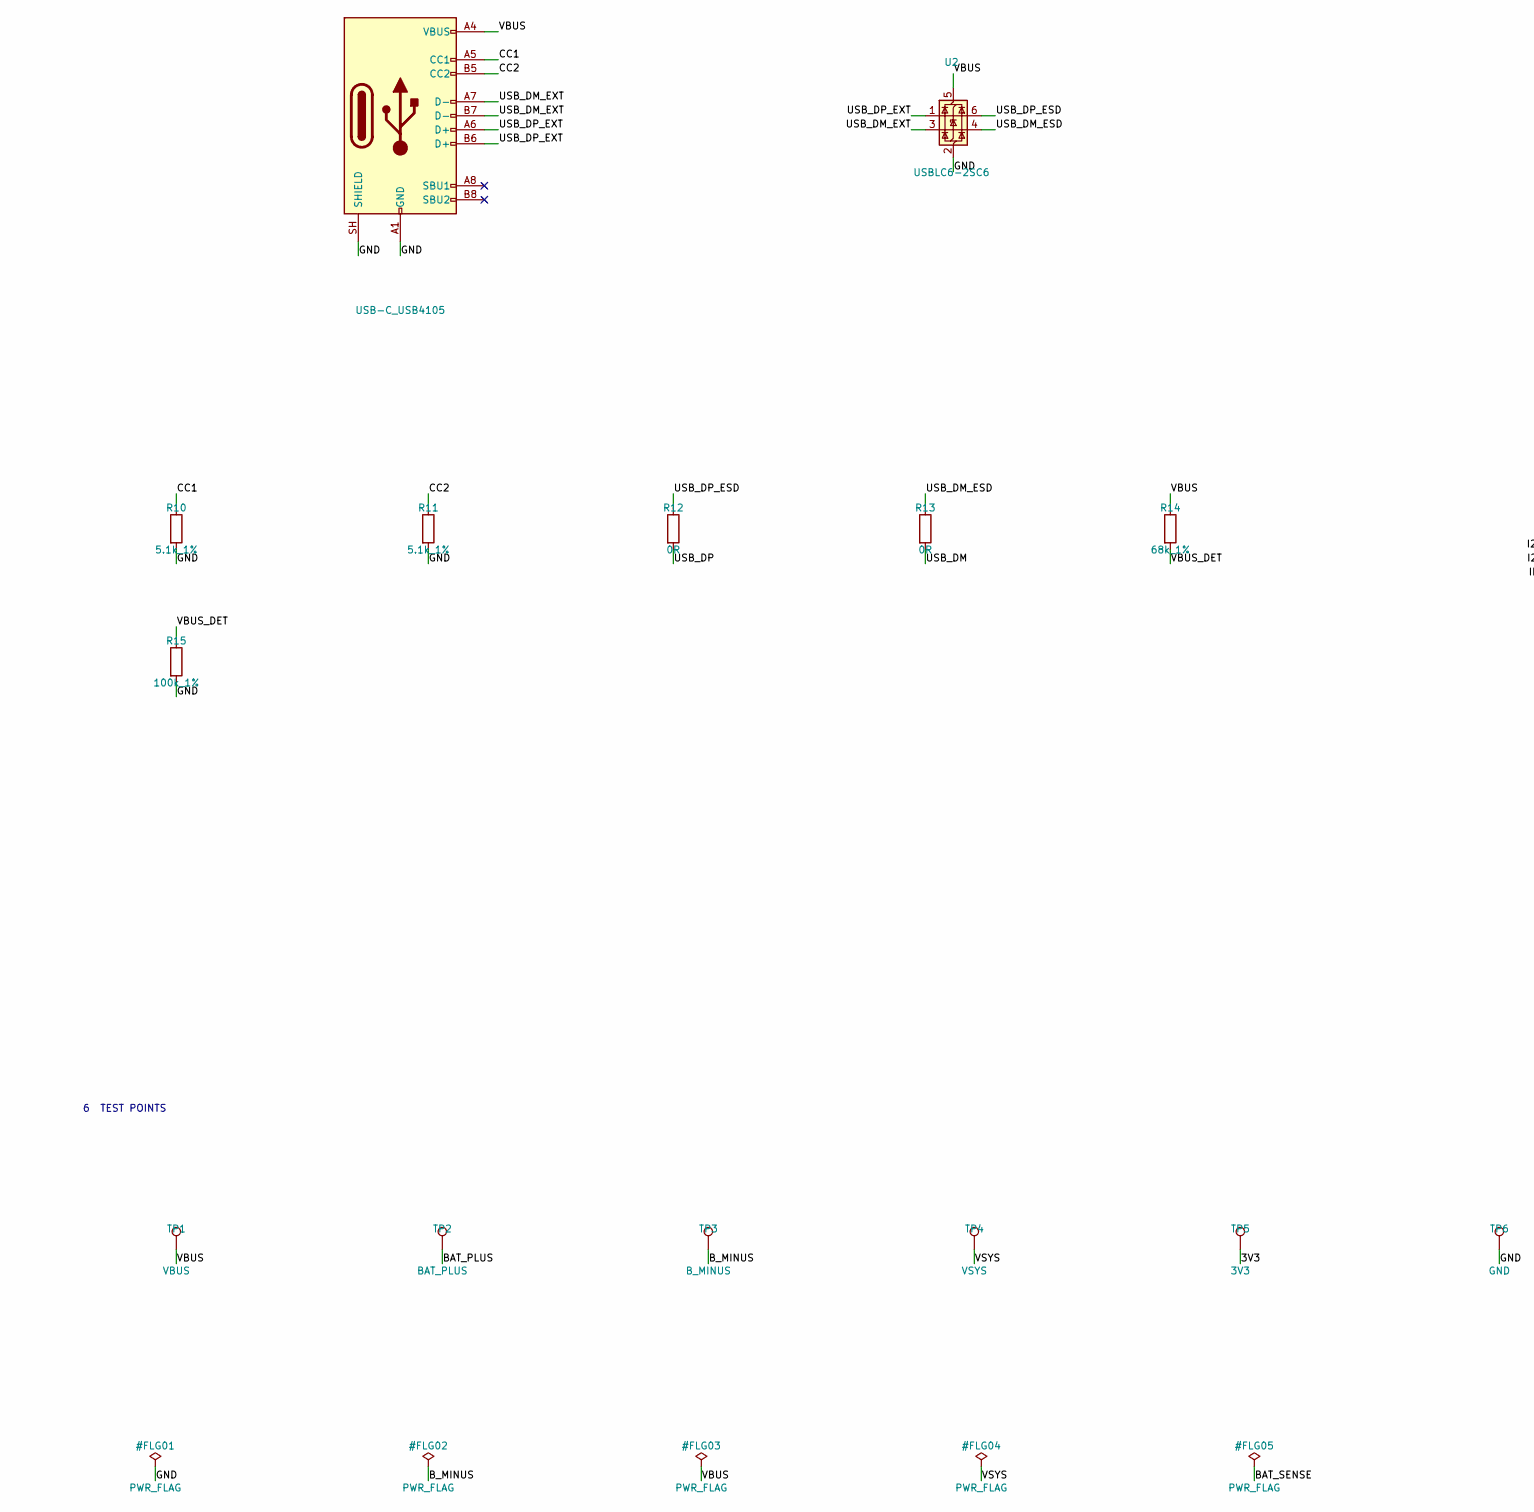
[picture p136: schematic NS-CLIP-MB.kicad_sch, part in row 2, column 1]

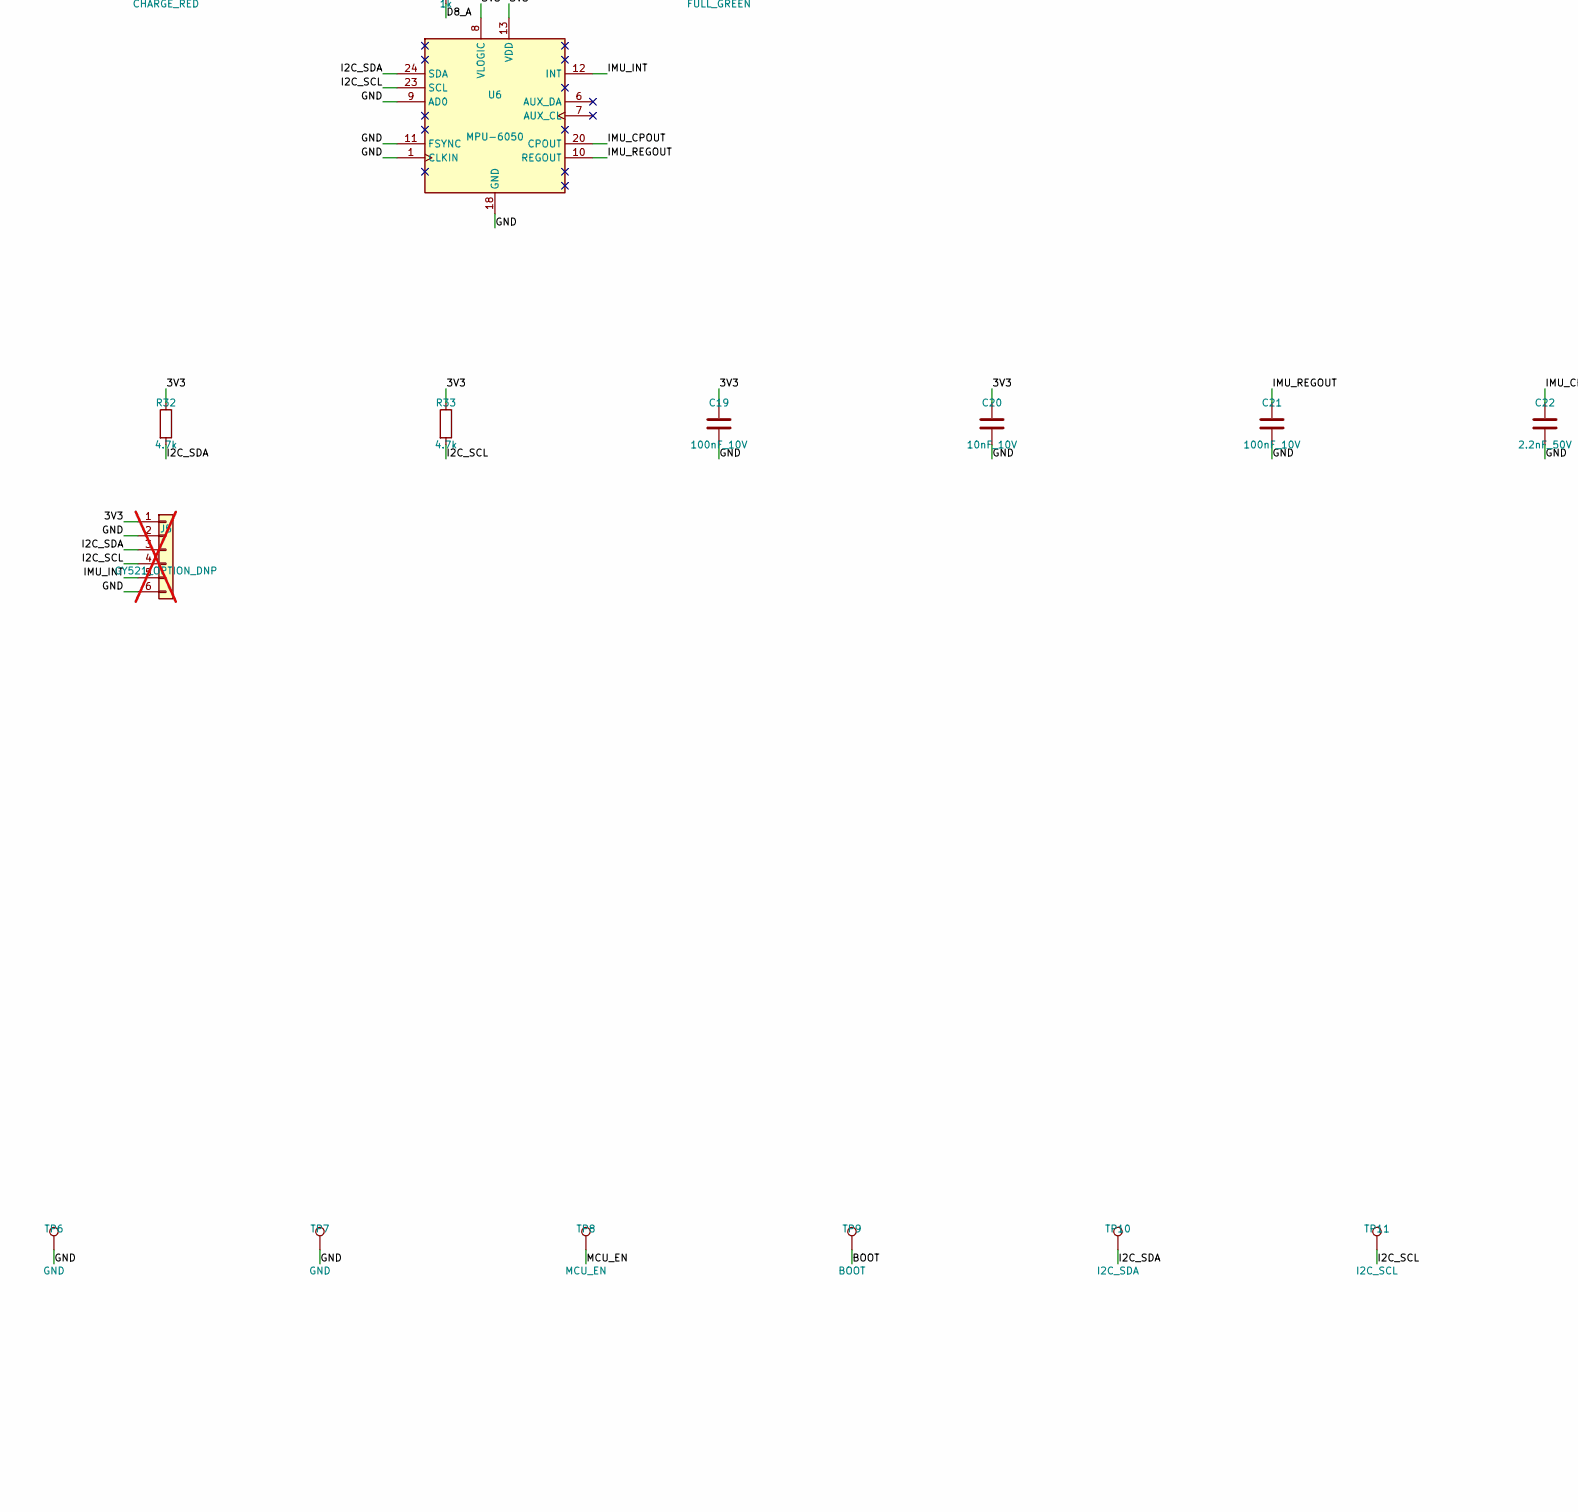
[picture p137: schematic NS-CLIP-MB.kicad_sch, part in row 2, column 2]

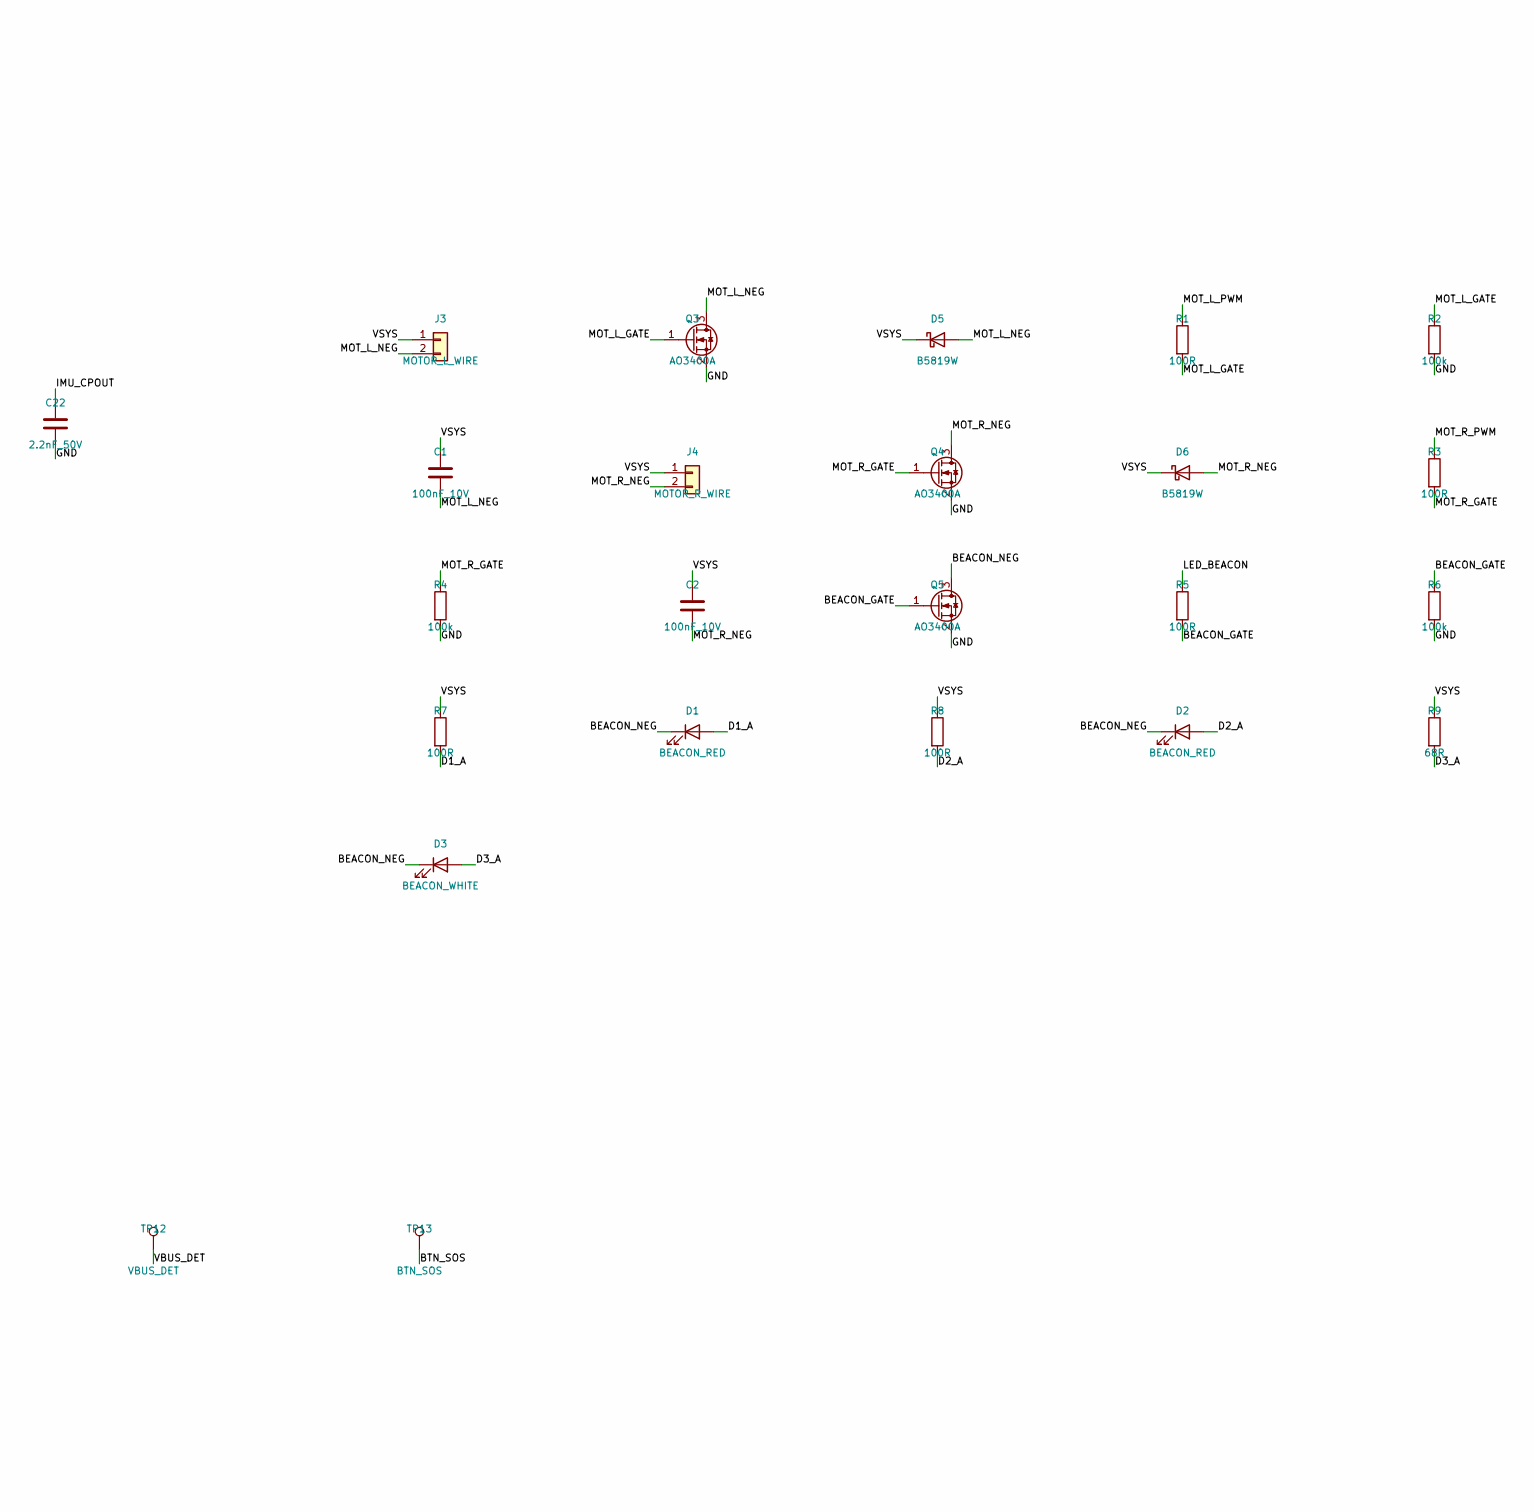
[picture p138: schematic NS-CLIP-MB.kicad_sch, part in row 2, column 3]

Parts:
C1, C2, C3, C6, C10, C13, C14, C15, C17, C18, C19, C21: 100nF_10V; C_0402_1005Metric
C4, C11: 22uF_10V; C_0805_2012Metric
C5, C7, C8, C9, C16: 10uF_10V; C_0603_1608Metric
C12: 1uF_10V; C_0402_1005Metric
C20: 10nF_10V; C_0402_1005Metric
C22: 2.2nF_50V; C_0402_1005Metric
D1, D2: BEACON_RED; LED_D5.0mm
D3: BEACON_WHITE; LED_D5.0mm
D4: SS14; D_SMA
D5, D6: B5819W; D_SOD-123
D7: CHARGE_RED; LED_0603_1608Metric
D8: FULL_GREEN; LED_0603_1608Metric
D9: STATUS_GREEN; LED_0603_1608Metric
J1: USB-C_USB4105; USB_C_Receptacle_GCT_USB4105-xx-A_16P_TopMnt_Horizontal
J2: BATTERY_1S_WIRE; SolderWire-0.5sqmm_1x02_P4.6mm_D0.9mm_OD2.1mm
J3: MOTOR_L_WIRE; SolderWire-0.5sqmm_1x02_P4.6mm_D0.9mm_OD2.1mm
J4: MOTOR_R_WIRE; SolderWire-0.5sqmm_1x02_P4.6mm_D0.9mm_OD2.1mm
J5: GY521_OPTION_DNP; JST_SH_SM06B-SRSS-TB_1x06-1MP_P1.00mm_Horizontal; not fitted
Q1: FS8205A_Fortune; TSSOP-8_4.4x3mm_P0.65mm; LCSC C16052
Q2: AO3401A; SOT-23
Q3, Q4, Q5: AO3400A; SOT-23
R1, R3, R5, R17: 100R; R_0402_1005Metric
R2, R4, R6, R19, R20: 100k; R_0402_1005Metric
R7, R8: 100R; R_0603_1608Metric
R9: 68R; R_0603_1608Metric
R10, R11: 5.1k_1%; R_0402_1005Metric
R12, R13: 0R; R_0402_1005Metric
R14: 68k_1%; R_0402_1005Metric
R15: 100k_1%; R_0402_1005Metric
R16: 3.0k_1%; R_0402_1005Metric
R18, R29, R30, R31: 1k; R_0402_1005Metric
R21, R22, R23, R24, R25, R26: 10k; R_0402_1005Metric
R27, R28: 470k_1%; R_0402_1005Metric
R32, R33: 4.7k; R_0402_1005Metric
SW1: POWER_ON; SW_SPDT_Shouhan_MSK12C02
SW2: MODE; SW_SPST_EVQP2_ShortPushTravel_H2.5mm
SW3: ROUTE; SW_SPST_EVQP2_ShortPushTravel_H2.5mm
SW4: SOS; SW_SPST_EVQP2_ShortPushTravel_H2.5mm
TP1: VBUS; TestPoint_Pad_D1.0mm
TP2: BAT_PLUS; TestPoint_Pad_D1.0mm
TP3: B_MINUS; TestPoint_Pad_D1.0mm
TP4: VSYS; TestPoint_Pad_D1.0mm
TP5: 3V3; TestPoint_Pad_D1.0mm
TP6, TP7: GND; TestPoint_Pad_D1.0mm
TP8: MCU_EN; TestPoint_Pad_D1.0mm
TP9: BOOT; TestPoint_Pad_D1.0mm
TP10: I2C_SDA; TestPoint_Pad_D1.0mm
TP11: I2C_SCL; TestPoint_Pad_D1.0mm
TP12: VBUS_DET; TestPoint_Pad_D1.0mm
TP13: BTN_SOS; TestPoint_Pad_D1.0mm
U1: ESP32-C3-MINI-1-N4X; ESP32-C3-MINI-1
U2: USBLC6-2SC6; SOT-23-6
U3: TP4056-42-ESOP8; HSOP-8-1EP_3.9x4.9mm_P1.27mm_EP2.41x3.1mm
U4: AP2112K-3.3TRG1; SOT-23-5
U5: DW01A; SOT-23-6
U6: MPU-6050; InvenSense_QFN-24_4x4mm_P0.5mm; LCSC C24112

Connections:
/3V3: C9.1, C10.1, C11.1, C16.1, C17.1, C19.1, C20.1, J5.1, R21.1, R22.1, R23.1, R24.1, R25.1, R26.1, R29.1, R32.1, R33.1, TP5.1, U1.3 (3V3), U4.5 (VOUT), U6.8 (VLOGIC), U6.13 (VDD)
/BAT_CS: R18.1, U5.2 (CS)
/BAT_D_COMMON: Q1.1 (D12), Q1.8 (D12)
/BAT_OC: Q1.5 (G2), U5.3 (OC)
/BAT_OD: Q1.4 (G1), U5.1 (OD)
/BAT_PLUS: C7.1, J2.1, Q2.3 (D), R17.1, R27.1, TP2.1, U3.5 (BAT)
/BAT_SENSE: C3.1, R17.2, U5.5 (VCC)
/BEACON_GATE: Q5.1 (G), R5.2, R6.1
/BEACON_NEG: D1.1 (K), D2.1 (K), D3.1 (K), Q5.3 (D)
/BOOT: R22.2, TP9.1, U1.23 (GPIO9)
/BTN_MODE: C13.1, R24.2, SW2.1, U1.16 (GPIO10)
/BTN_ROUTE: C14.1, R25.2, SW3.1, U1.5 (GPIO2/ADC1_CH2)
/BTN_SOS: C15.1, R26.2, SW4.1, TP13.1, U1.30 (GPIO20/U0RXD)
/B_MINUS: C3.2, J2.2, Q1.2 (S1), Q1.3 (S1), TP3.1, U5.6 (GND)
/CC1: J1.A5 (CC1), R10.1
/CC2: J1.B5 (CC2), R11.1
/CHG_CHRG: D7.1 (K), U3.7 (~CHRG)
/CHG_PROG: R16.1, U3.2 (PROG)
/CHG_STDBY: D8.1 (K), U3.6 (~STDBY)
/D1_A: D1.2 (A), R7.2
/D2_A: D2.2 (A), R8.2
/D3_A: D3.2 (A), R9.2
/D7_A: D7.2 (A), R30.2
/D8_A: D8.2 (A), R31.2
/GND: C4.2, C5.2, C6.2, C7.2, C8.2, C9.2, C10.2, C11.2, C12.2, C13.2, C14.2, C15.2, C16.2, C17.2, C18.2, C19.2, C20.2, C21.2, C22.2, J1.A1 (GND), J1.A12 (GND), J1.B1 (GND), J1.B12 (GND), J1.SH (SHIELD), J5.2, J5.6, Q1.6 (S2), Q1.7 (S2), Q3.2 (S), Q4.2 (S), Q5.2 (S), R2.2, R4.2, R6.2, R10.2, R11.2, R15.2, R16.2, R18.2, R19.2, R20.2, R28.2, SW2.2, SW3.2, SW4.2, TP6.1, TP7.1, U1.1 (GND), U1.2 (GND), U1.11 (GND), U1.14 (GND), U1.36 (GND), U1.37 (GND), U1.38 (GND), U1.39 (GND), U1.40 (GND), U1.41 (GND), U1.42 (GND), U1.43 (GND), U1.44 (GND), U1.45 (GND), U1.46 (GND), U1.47 (GND), U1.48 (GND), U1.49 (GND), U1.50 (GND), U1.51 (GND), U1.52 (GND), U1.53 (GND), U2.2 (GND), U3.1 (TEMP), U3.3 (GND), U3.9 (EPAD), U4.2 (GND), U6.1 (CLKIN), U6.9 (AD0), U6.11 (FSYNC), U6.18 (GND)
/I2C_SCL: J5.4, R33.2, TP11.1, U1.19 (GPIO5/ADC2_CH0), U6.23 (SCL)
/I2C_SDA: J5.3, R32.2, TP10.1, U1.18 (GPIO4/ADC1_CH4), U6.24 (SDA)
/IMU_CPOUT: C22.1, U6.20 (CPOUT)
/IMU_INT: J5.5, U1.13 (GPIO1/ADC1_CH1/XTAL_32K_N), U6.12 (INT)
/IMU_REGOUT: C21.1, U6.10 (REGOUT)
/LDO_EN: R20.1, SW1.2 (B), U4.3 (EN)
/LED_BEACON: R5.1, U1.6 (GPIO3/ADC1_CH3)
/LED_STATUS: D9.1 (K), R23.2, U1.22 (GPIO8)
/LED_STATUS_A: D9.2 (A), R29.2
/MCU_EN: C12.1, R21.2, TP8.1, U1.8 (EN/CHIP_PU)
/MOT_L_GATE: Q3.1 (G), R1.2, R2.1
/MOT_L_NEG: C1.2, D5.2 (A), J3.2, Q3.3 (D)
/MOT_L_PWM: R1.1, U1.20 (GPIO6)
/MOT_R_GATE: Q4.1 (G), R3.2, R4.1
/MOT_R_NEG: C2.2, D6.2 (A), J4.2, Q4.3 (D)
/MOT_R_PWM: R3.1, U1.21 (GPIO7)
/USB_DM: R13.2, U1.26 (GPIO18/USB_D-)
/USB_DM_ESD: R13.1, U2.4 (I/O2)
/USB_DM_EXT: J1.A7 (D-), J1.B7 (D-), U2.3 (I/O2)
/USB_DP: R12.2, U1.27 (GPIO19/USB_D+)
/USB_DP_ESD: R12.1, U2.6 (I/O1)
/USB_DP_EXT: J1.A6 (D+), J1.B6 (D+), U2.1 (I/O1)
/VBAT_ADC: C18.1, R27.2, R28.1, U1.12 (GPIO0/ADC1_CH0/XTAL_32K_P)
/VBUS: C5.1, C6.1, D4.2 (A), J1.A4 (VBUS), J1.A9 (VBUS), J1.B4 (VBUS), J1.B9 (VBUS), Q2.1 (G), R14.1, R19.1, R30.1, R31.1, TP1.1, U2.5 (VBUS), U3.4 (V_{CC}), U3.8 (CE)
/VBUS_DET: R14.2, R15.1, TP12.1, U1.31 (GPIO21/U0TXD)
/VSYS: C1.1, C2.1, C4.1, C8.1, D4.1 (K), D5.1 (K), D6.1 (K), J3.1, J4.1, Q2.2 (S), R7.1, R8.1, R9.1, SW1.1 (A), TP4.1, U4.1 (VIN)

Notes on the sheet:
5 HAPTICS / BEACON
2 CHARGE / PROTECTION / POWER
3 USB-C / ESD / VBUS SENSE
4 IMU / I2C / EXTERNAL SENSORS
1 MCU / BOOT / USER INTERFACE
6 TEST POINTS

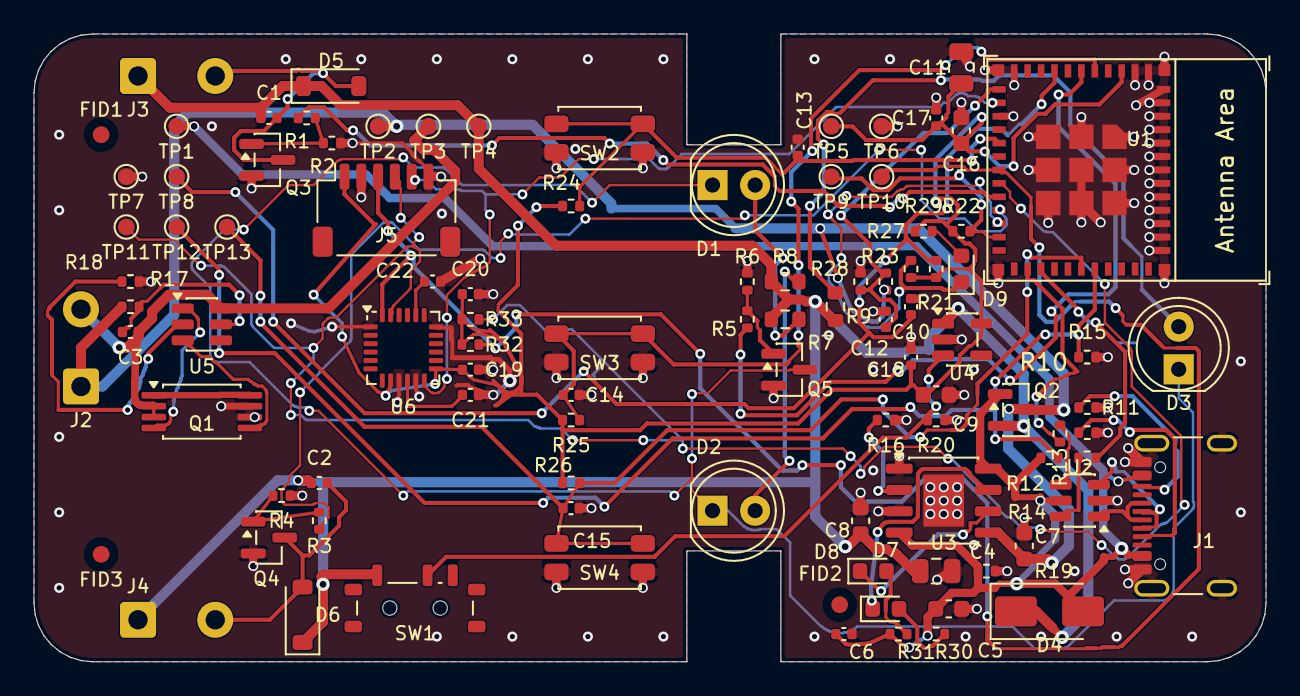
[picture p139: board NS-CLIP-MB.kicad_pcb from above]

Board: 2 copper layers, 73.4 x 37.4 mm, 100 parts (0 on the bottom side), 51 nets.

Other parts of the board:
FID1, FID2, FID3: FIDUCIAL; Fiducial_1mm_Mask2mm
