gwangzeejay/NovaSight/(commit log)

2026-11-12 NovaSight Rev A P1: PCB, firmware, algorithm docs and 3D viewer
    - hardware: KiCad P1 projects NS-CHEST-MB and NS-CLIP-MB (0 DRC errors,
    0 unconnected, 0 parity, 0 ERC on KiCad 10.0.6), routing history
    - output: Gerber P1, BOM/CPL/DXF/STEP review, P1 BOM with LCSC codes,
    PCB dossier (pptx/pdf/docx), algorithm and system-diagram decks,
    3D assembly + usage simulation page
    - firmware (PlatformIO ESP32-S3 / ESP32-C3), NovaApp, tools and tests
    [NS-CHEST-MB-BOM-JLCPCB.csv, NS-CHEST-MB-BOM-final.csv, NS-CHEST-MB-BOM-review.csv, NS-CHEST-MB-assembly.step, NS-CHEST-MB-bom.csv, NS-CHEST-MB-mechanical-review.dxf, NS-CHEST-MB-mua-ngoai.csv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]
2026-11-12 Clean up scratch files: remove one-off PDF patch scripts and 3D/USB screenshots
    Drop output/pdf/src patch3-7.py and cutpass*.py (one-off edits already
    applied to build.py), the six 3D viewer screenshots in output/3d and the
    usb_crop.png debug crops. COOKBOOK no longer points at the deleted
    output/.pcb-fab-work folder.
